rod-0310/Senior_Engineering_Design_Project/vision/runs/detect/predict/2025-11-10-225509_frame_3_jpg.rf.fb63ad9d6d32afbec5ac665ef9ed68c7.jpg

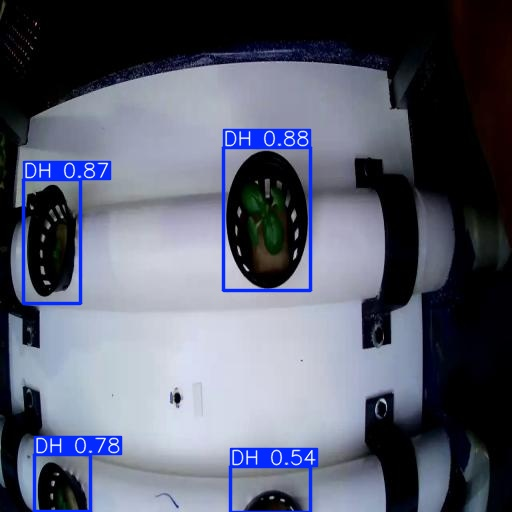
vision/runs/detect/predict/2025-11-10-225509_frame_3_jpg.rf.fb63ad9d6d32afbec5ac665ef9ed68c7.jpg
