rod-0310/Senior_Engineering_Design_Project/README.md

# Senior_Engineering_Design_Project
mian repository
