rod-0310/Senior_Engineering_Design_Project/body-gt2-idler-pulley-1.snapshot.2/Foto.png

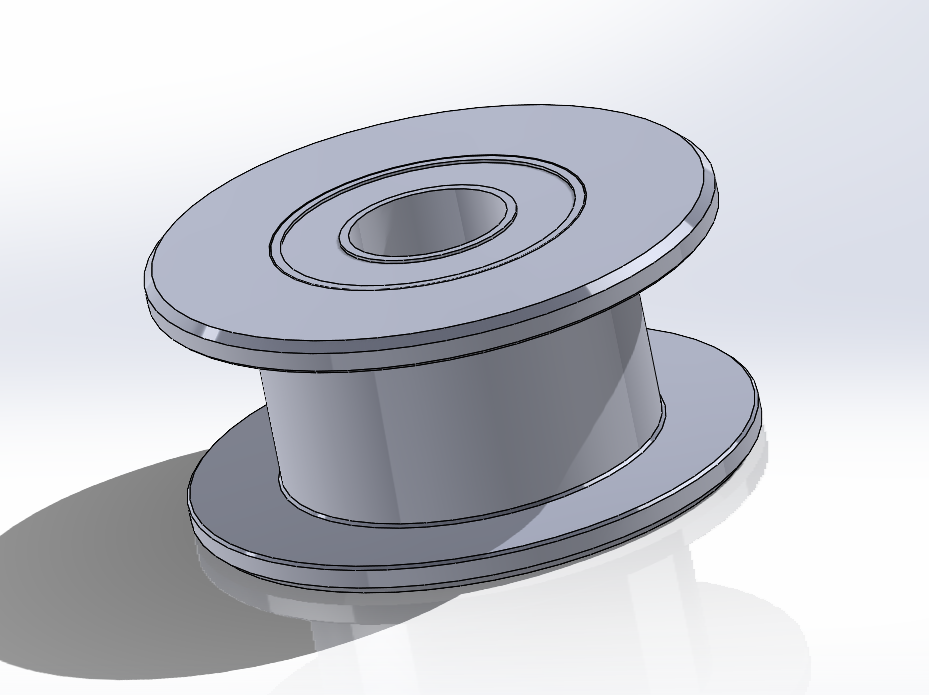
body-gt2-idler-pulley-1.snapshot.2/Foto.png
