rod-0310/Senior_Engineering_Design_Project/bomba-march-pump-1.snapshot.9/BOMBA DE LLENADORA.JPG

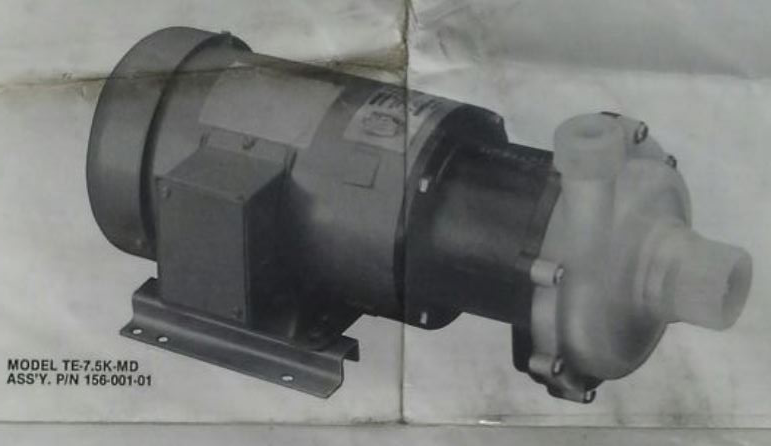
bomba-march-pump-1.snapshot.9/BOMBA DE LLENADORA.JPG
