rod-0310/Senior_Engineering_Design_Project/esp32-devkit_1-shield-expansion-board-1.snapshot.10/imagen_2025-06-20_145719014.png

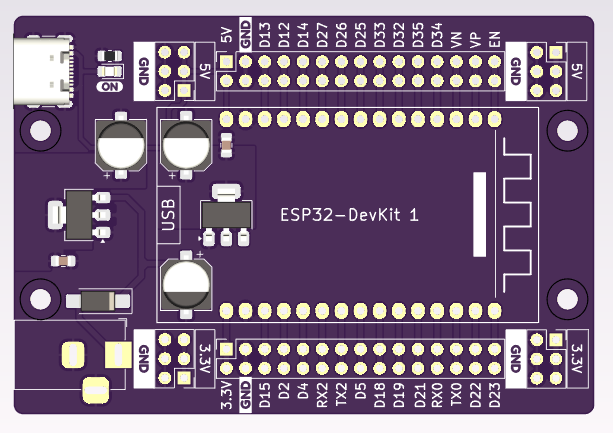
esp32-devkit_1-shield-expansion-board-1.snapshot.10/imagen_2025-06-20_145719014.png
