rod-0310/Senior_Engineering_Design_Project/fan-60x60-techman-1.snapshot.1/2.jpg

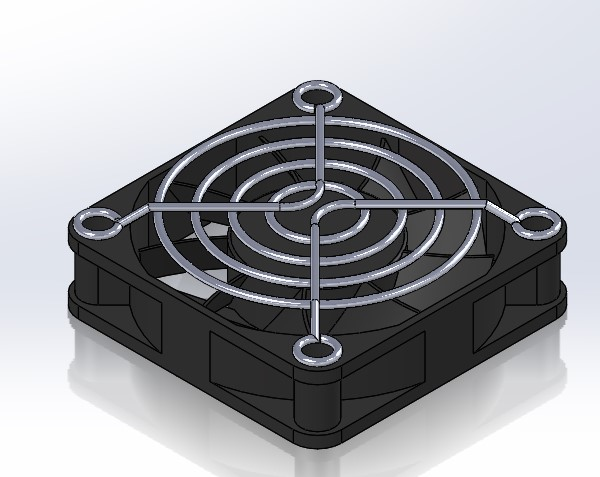
fan-60x60-techman-1.snapshot.1/2.jpg
