rod-0310/Senior_Engineering_Design_Project/fan-60x60-techman-1.snapshot.1/20181109_073611.png

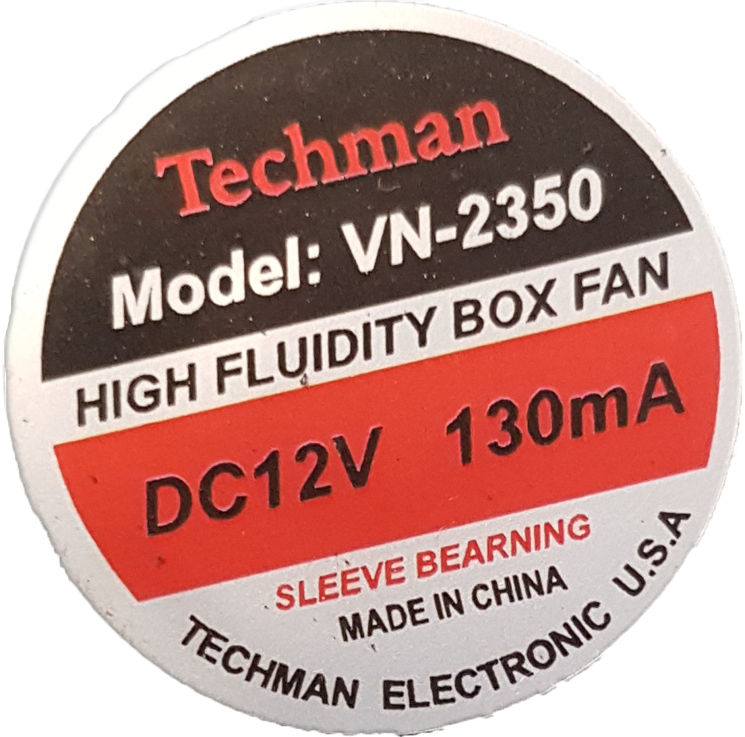
fan-60x60-techman-1.snapshot.1/20181109_073611.png
