rod-0310/Senior_Engineering_Design_Project/fuente-conmutada-24v-25a-48v-12-5a-y-24v-25a-1.snapshot.1/Fuente Conmutada 48V 12.5A img 1.PNG

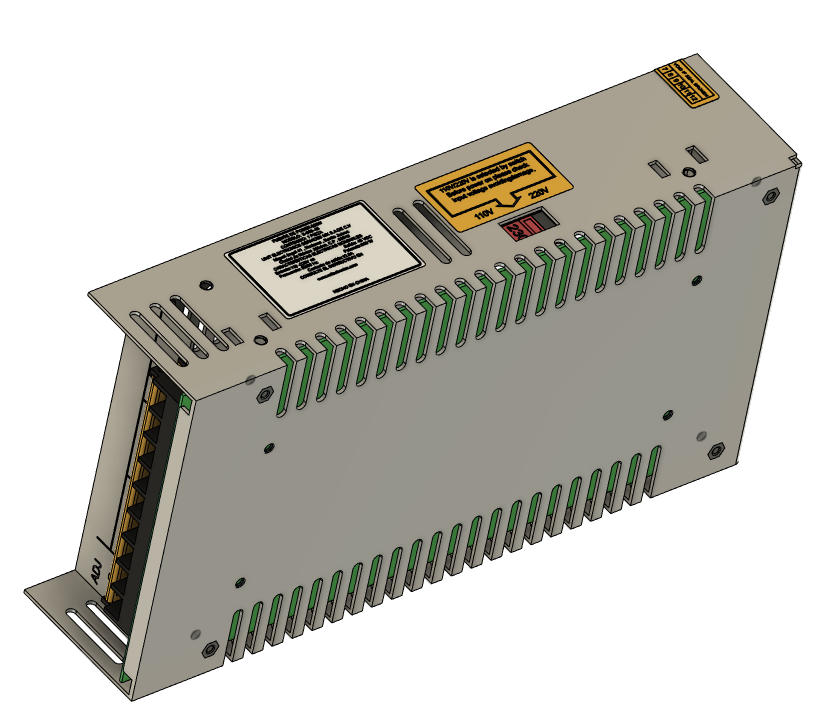
fuente-conmutada-24v-25a-48v-12-5a-y-24v-25a-1.snapshot.1/Fuente Conmutada 48V 12.5A img 1.PNG
