rod-0310/Senior_Engineering_Design_Project/Nema 17 42x40x5/Pic3.PNG

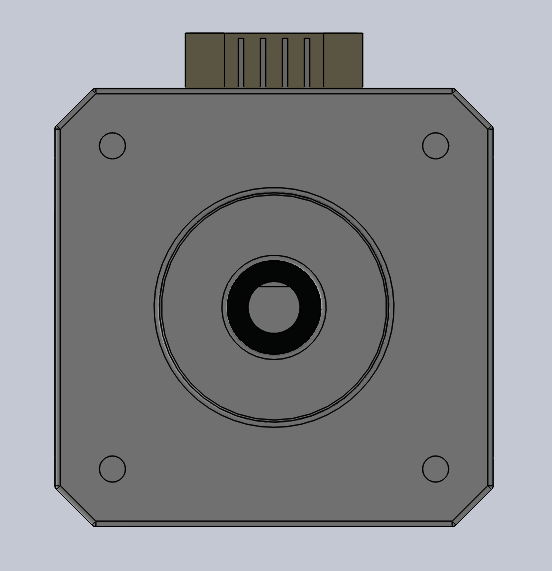
Nema 17 42x40x5/Pic3.PNG
