rod-0310/Senior_Engineering_Design_Project/plc-7.snapshot.1/PLCFinal2.png

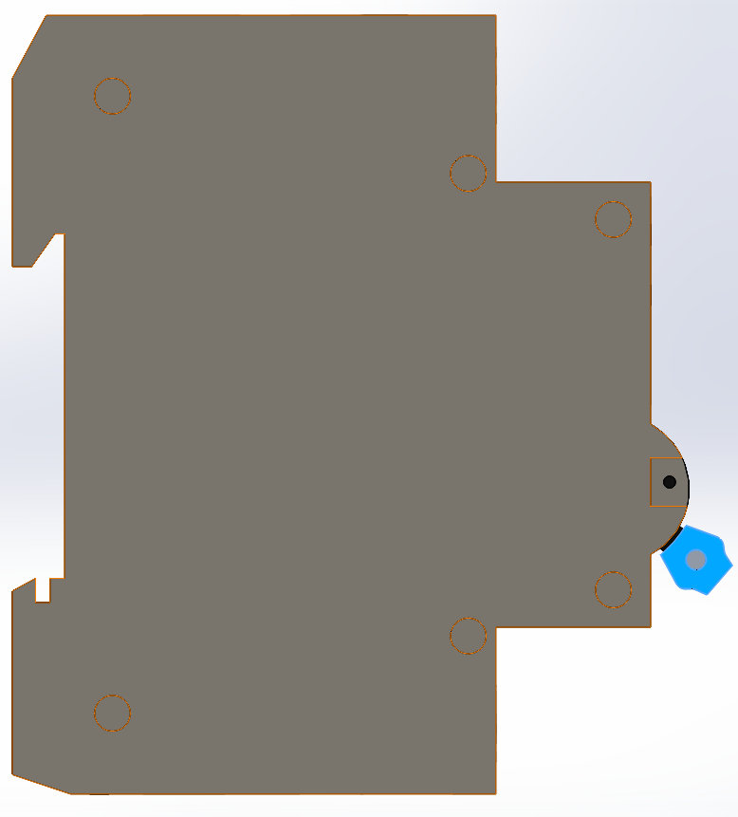
plc-7.snapshot.1/PLCFinal2.png
