rod-0310/Senior_Engineering_Design_Project/pulley-gt2-20-tooth-5-bore-gt2-1.snapshot.1/Снимок экрана 2023-11-01 161619.png

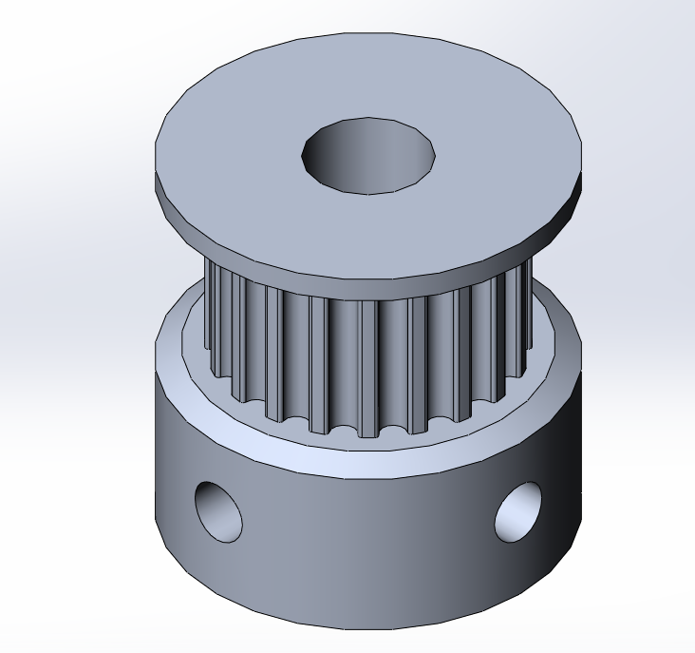
pulley-gt2-20-tooth-5-bore-gt2-1.snapshot.1/Снимок экрана 2023-11-01 161619.png
