rod-0310/Senior_Engineering_Design_Project/rodamientos-lineales-linear-bearings-1.snapshot.2/rodamientos lineales.JPG

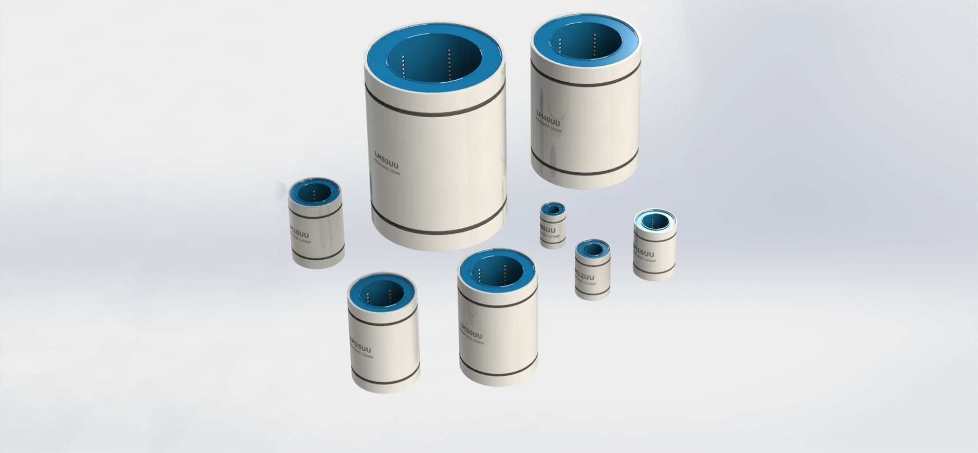
rodamientos-lineales-linear-bearings-1.snapshot.2/rodamientos lineales.JPG
