rod-0310/Senior_Engineering_Design_Project/tb6600-driver-1.snapshot.1/TB6600-3.PNG

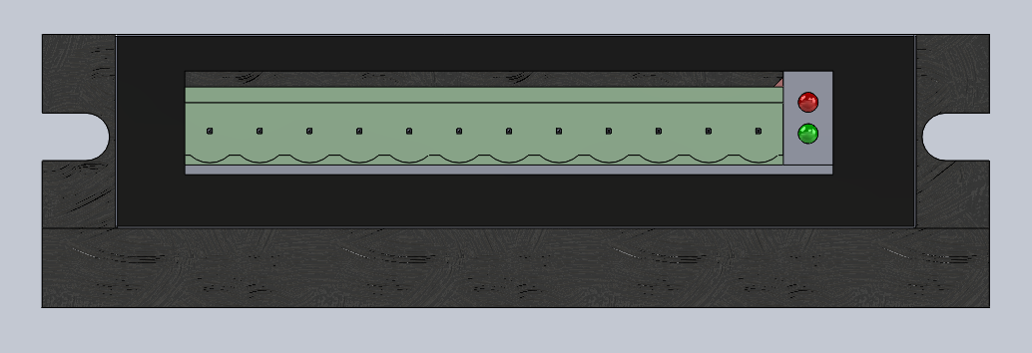
tb6600-driver-1.snapshot.1/TB6600-3.PNG
