rod-0310/Senior_Engineering_Design_Project/valvula-de-bola-de-1-in-de-pvc-1.snapshot.3/Untitled.JPG

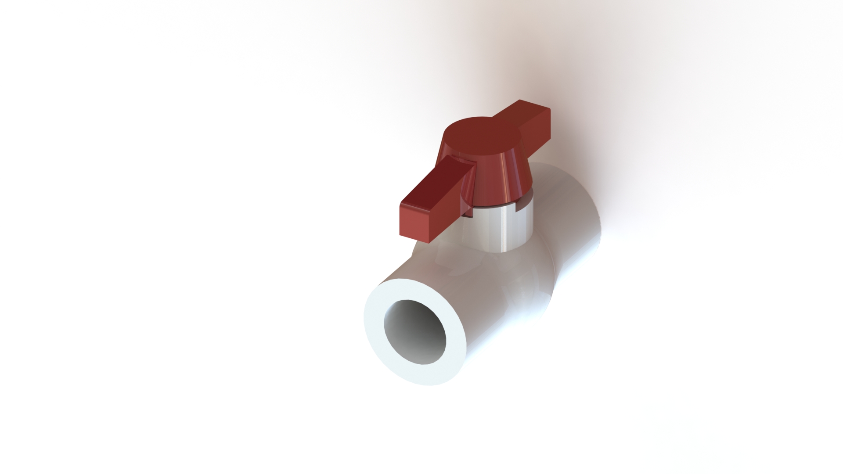
valvula-de-bola-de-1-in-de-pvc-1.snapshot.3/Untitled.JPG
