rod-0310/Senior_Engineering_Design_Project/vision/runs/detect/predict/2025-11-10-223832_frame_15_jpg.rf.22a14f25574e3a6e1a47245aced490ff.jpg

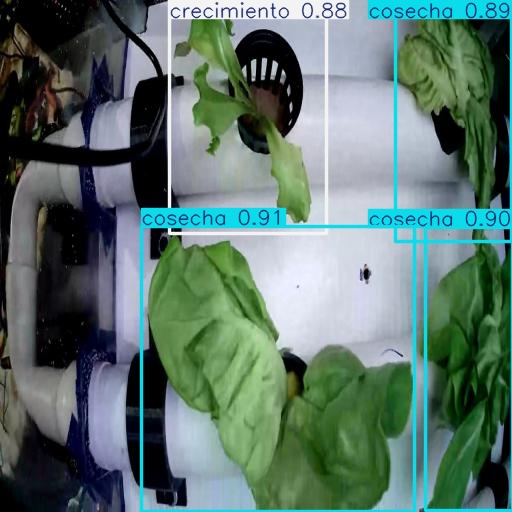
vision/runs/detect/predict/2025-11-10-223832_frame_15_jpg.rf.22a14f25574e3a6e1a47245aced490ff.jpg
