rod-0310/Senior_Engineering_Design_Project/vision/runs/detect/predict/2025-11-10-223832_frame_16_jpg.rf.2f97a4026e4792bca8e62f9cea386afc.jpg

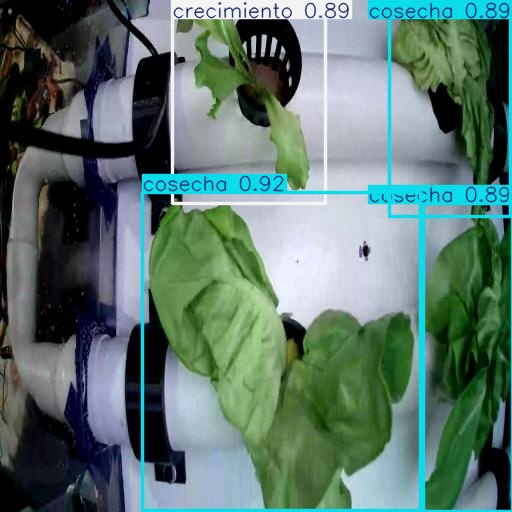
vision/runs/detect/predict/2025-11-10-223832_frame_16_jpg.rf.2f97a4026e4792bca8e62f9cea386afc.jpg
