rod-0310/Senior_Engineering_Design_Project/vision/runs/detect/predict/2025-11-10-223936_frame_9_jpg.rf.916dadcf2fc539604772f068412f9f6e.jpg

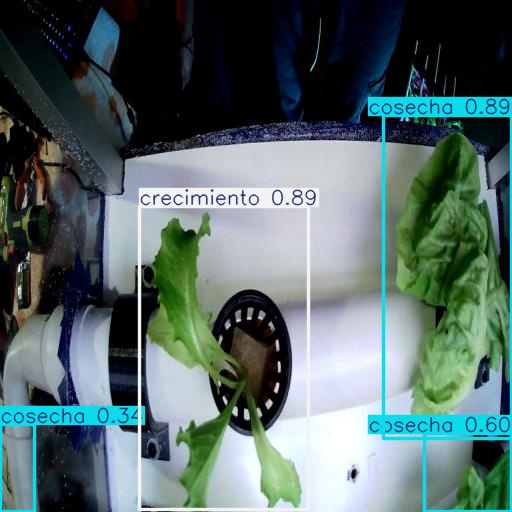
vision/runs/detect/predict/2025-11-10-223936_frame_9_jpg.rf.916dadcf2fc539604772f068412f9f6e.jpg
