rod-0310/Senior_Engineering_Design_Project/vision/runs/detect/predict/2025-11-10-223936_frame_16_jpg.rf.3a708838be61265636ba27722d4fdc08.jpg

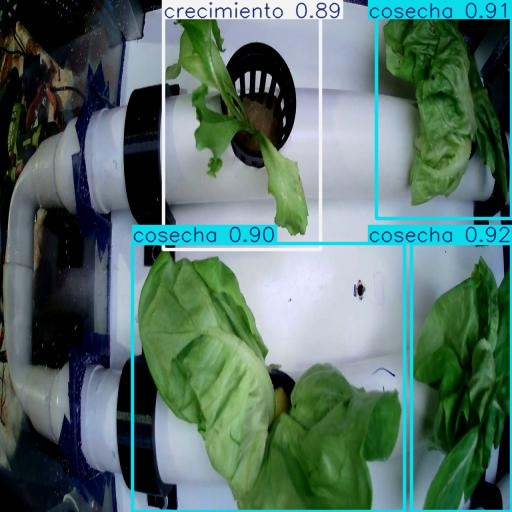
vision/runs/detect/predict/2025-11-10-223936_frame_16_jpg.rf.3a708838be61265636ba27722d4fdc08.jpg
