rod-0310/Senior_Engineering_Design_Project/vision/runs/detect/predict/2025-11-10-224214_frame_26_jpg.rf.f7065c991a5802a6a953b0d0d70c4c16.jpg

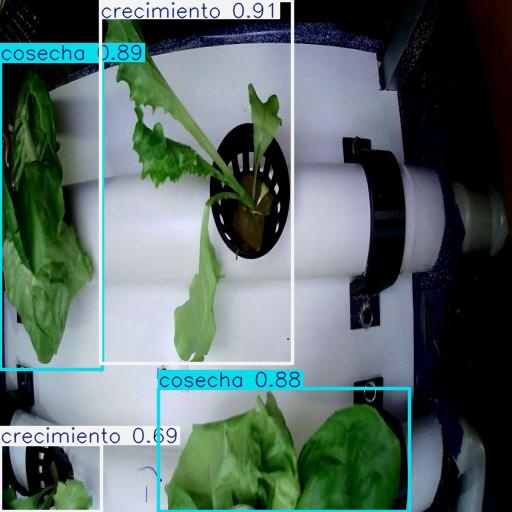
vision/runs/detect/predict/2025-11-10-224214_frame_26_jpg.rf.f7065c991a5802a6a953b0d0d70c4c16.jpg
