rod-0310/Senior_Engineering_Design_Project/vision/runs/detect/predict/2025-11-10-224326_frame_7_jpg.rf.50a9398aa1a29edf5bf6550289bb4c49.jpg

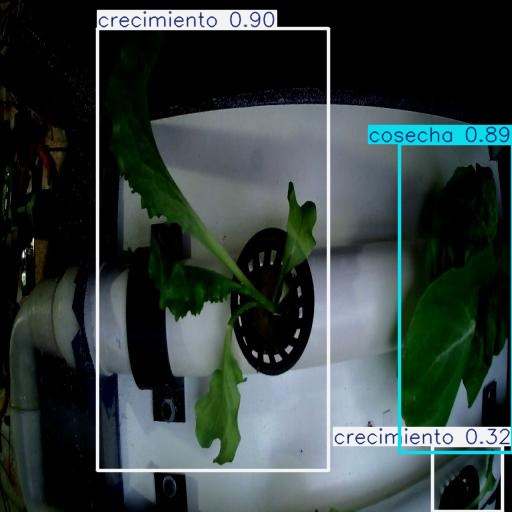
vision/runs/detect/predict/2025-11-10-224326_frame_7_jpg.rf.50a9398aa1a29edf5bf6550289bb4c49.jpg
