rod-0310/Senior_Engineering_Design_Project/vision/runs/detect/predict/2025-11-10-224425_frame_20_jpg.rf.f0c4a33722093ec0f9ddbb4c10bcf8e6.jpg

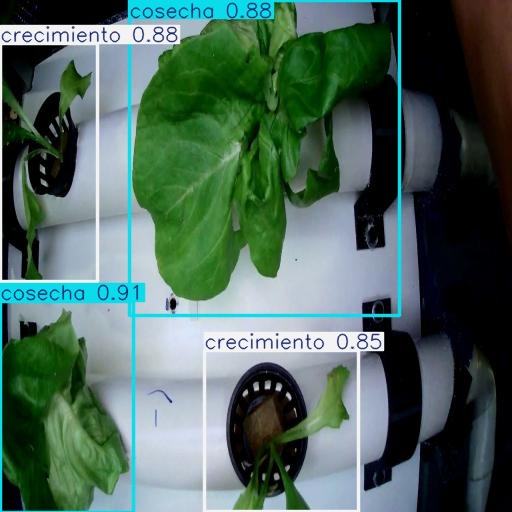
vision/runs/detect/predict/2025-11-10-224425_frame_20_jpg.rf.f0c4a33722093ec0f9ddbb4c10bcf8e6.jpg
