rod-0310/Senior_Engineering_Design_Project/vision/runs/detect/predict/2025-11-10-224652_frame_2_jpg.rf.96d3c39d6f43bb69b98d42bbe74c6def.jpg

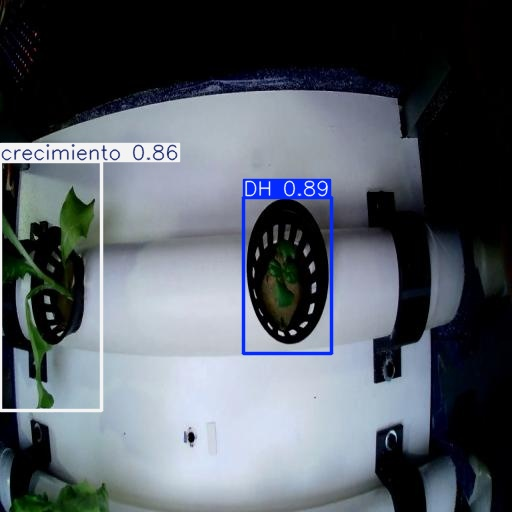
vision/runs/detect/predict/2025-11-10-224652_frame_2_jpg.rf.96d3c39d6f43bb69b98d42bbe74c6def.jpg
