rod-0310/Senior_Engineering_Design_Project/vision/runs/detect/predict/2025-11-10-224652_frame_13_jpg.rf.508b9bf271020223bf58ecf0794aba57.jpg

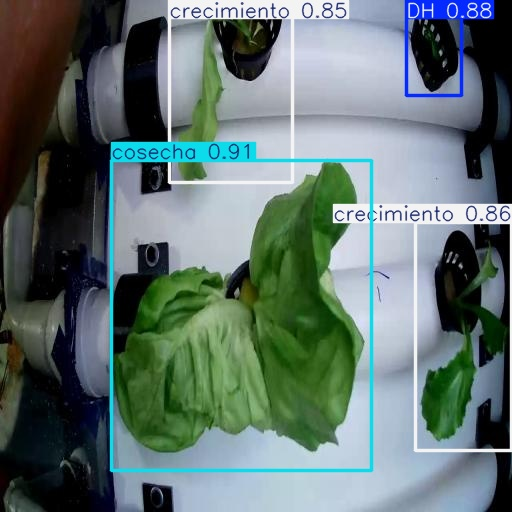
vision/runs/detect/predict/2025-11-10-224652_frame_13_jpg.rf.508b9bf271020223bf58ecf0794aba57.jpg
