rod-0310/Senior_Engineering_Design_Project/vision/runs/detect/train2/F1_curve.png

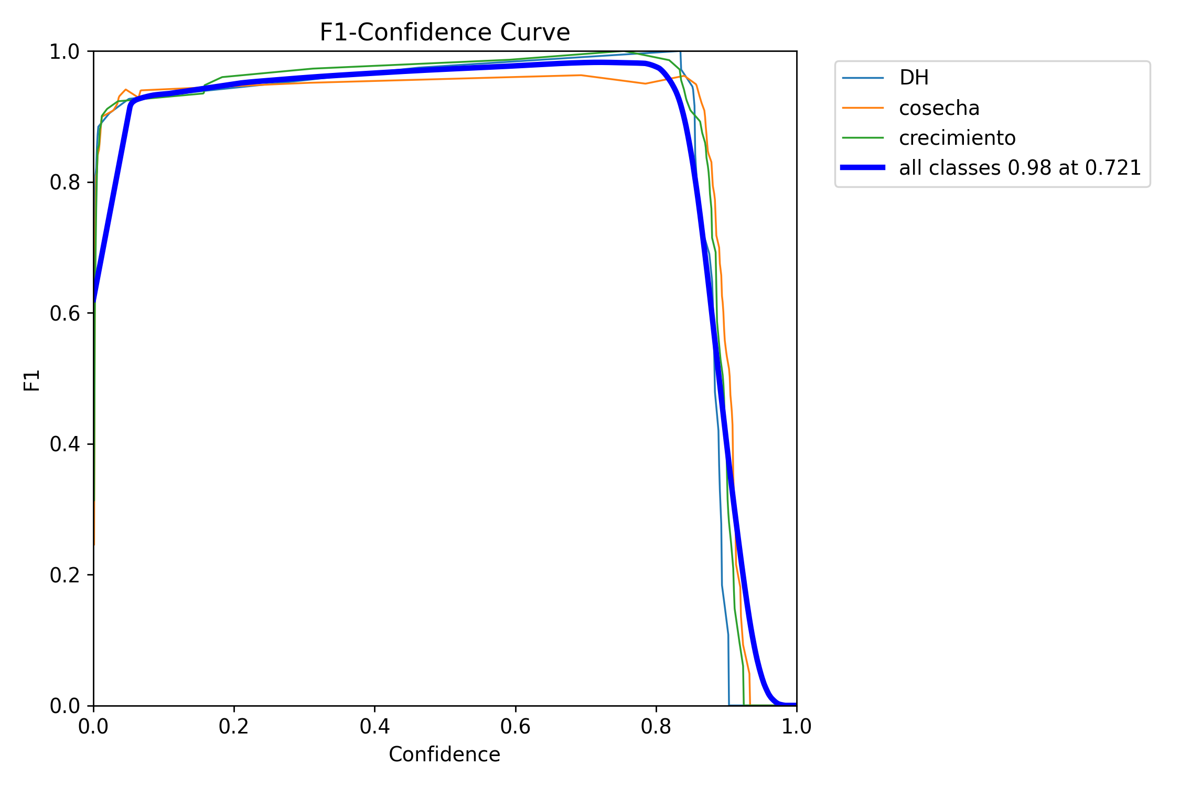
vision/runs/detect/train2/F1_curve.png
