rod-0310/Senior_Engineering_Design_Project/vision/runs/detect/train2/labels.jpg

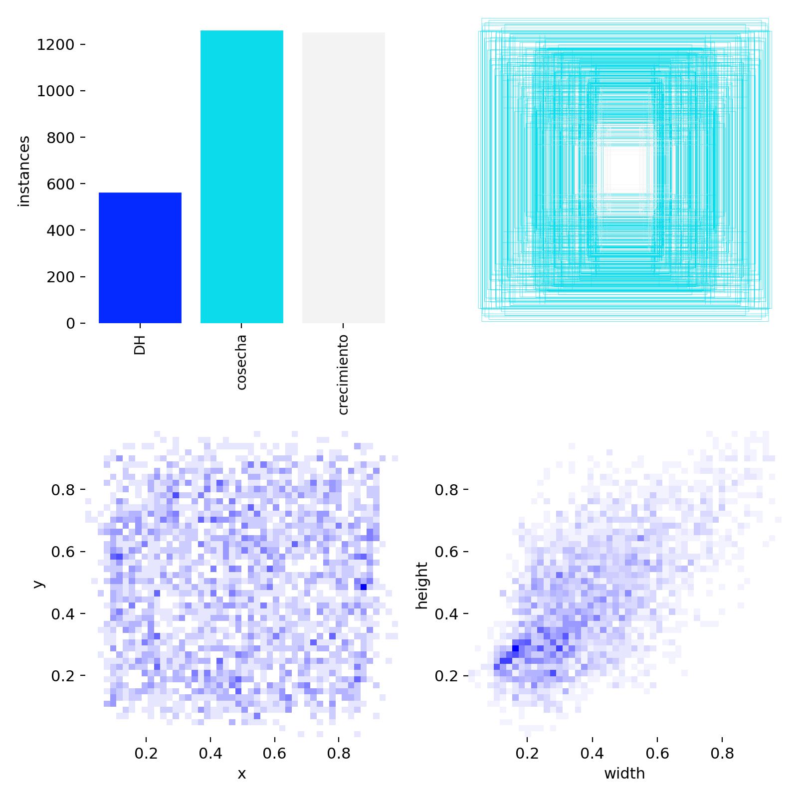
vision/runs/detect/train2/labels.jpg
