rod-0310/Senior_Engineering_Design_Project/vision/runs/detect/train2/train_batch0.jpg

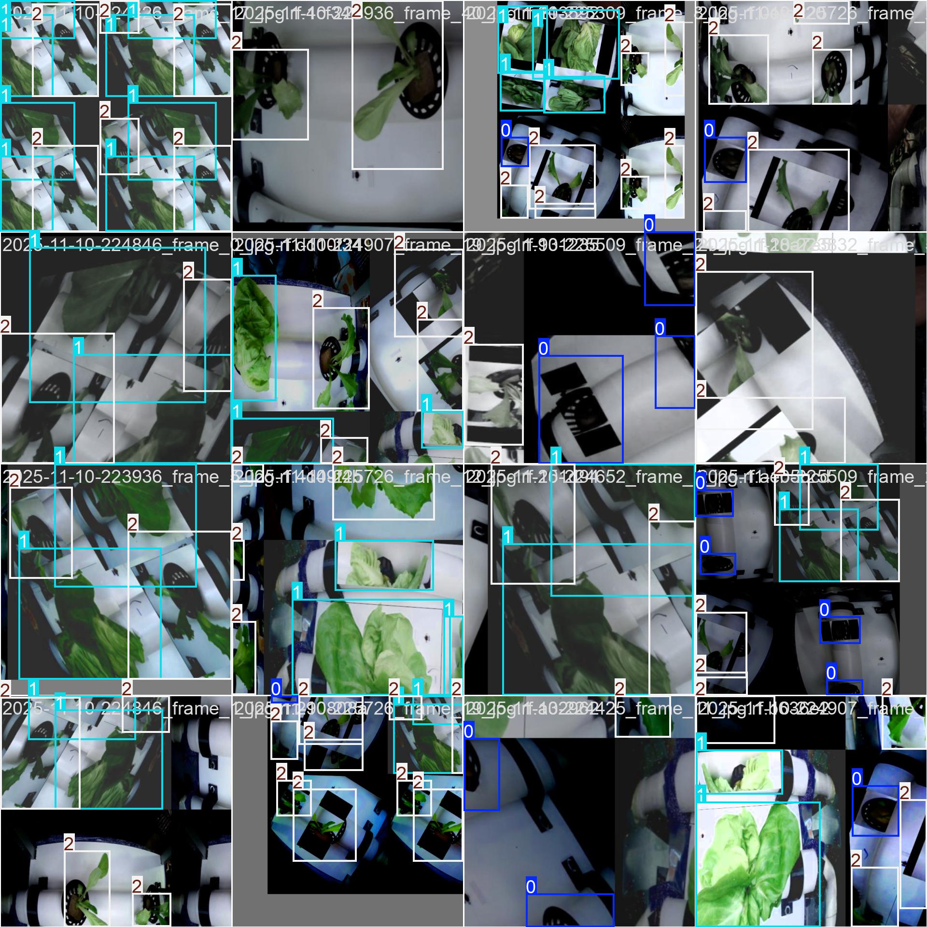
vision/runs/detect/train2/train_batch0.jpg
