rod-0310/Senior_Engineering_Design_Project/vision/runs/detect/train3/train_batch2.jpg

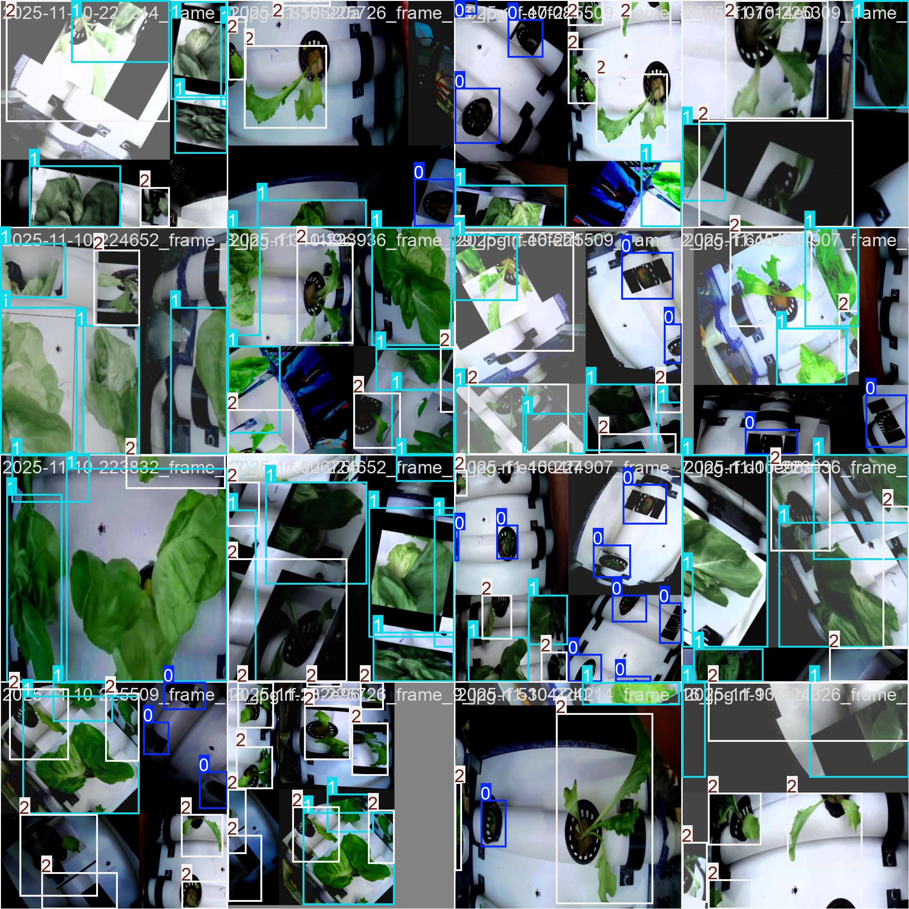
vision/runs/detect/train3/train_batch2.jpg
