rod-0310/Senior_Engineering_Design_Project/vision/runs/detect/train5/labels_correlogram.jpg

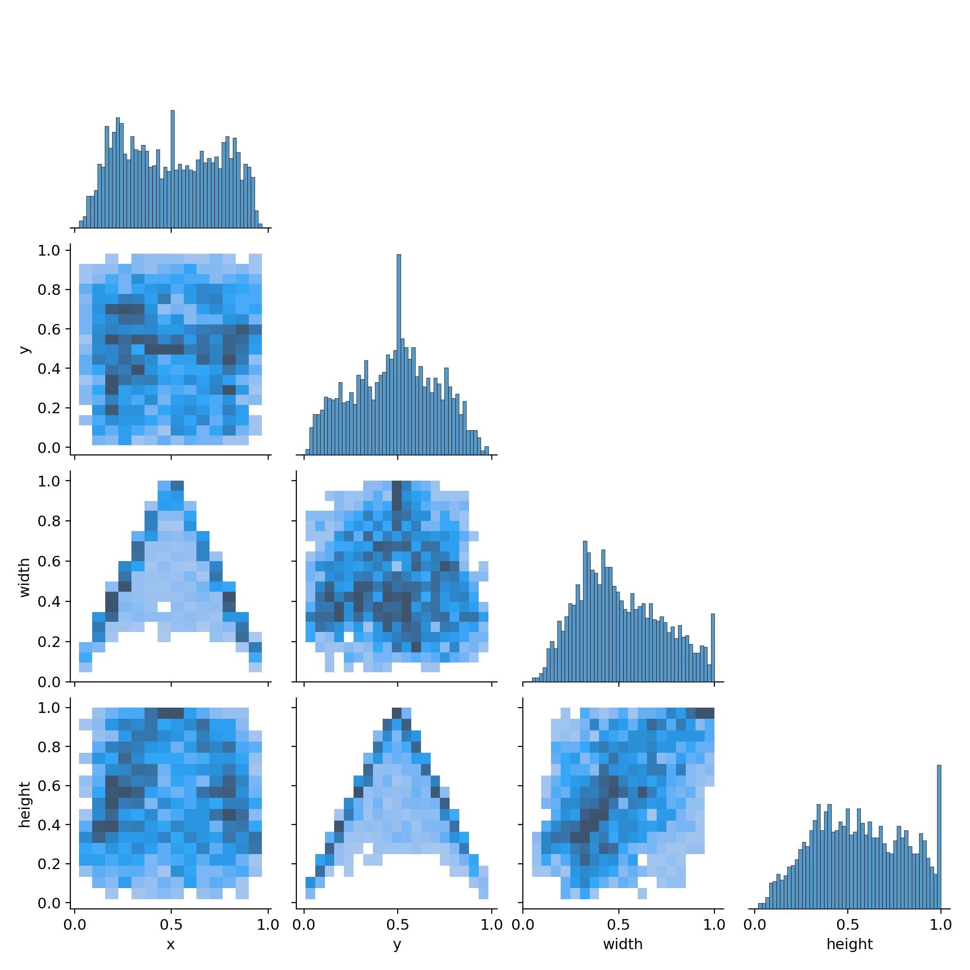
vision/runs/detect/train5/labels_correlogram.jpg
