rod-0310/Senior_Engineering_Design_Project/vision/runs/detect/train6/train_batch5851.jpg

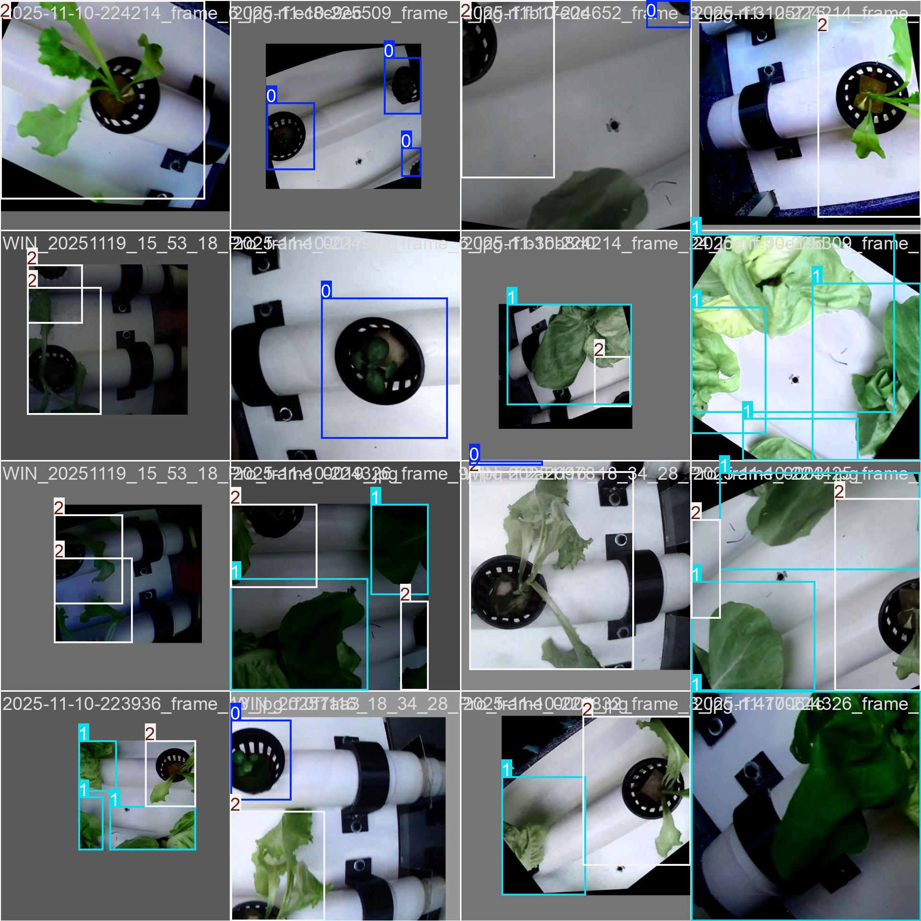
vision/runs/detect/train6/train_batch5851.jpg
