rod-0310/Senior_Engineering_Design_Project/vision/runs/detect/train6/val_batch1_labels.jpg

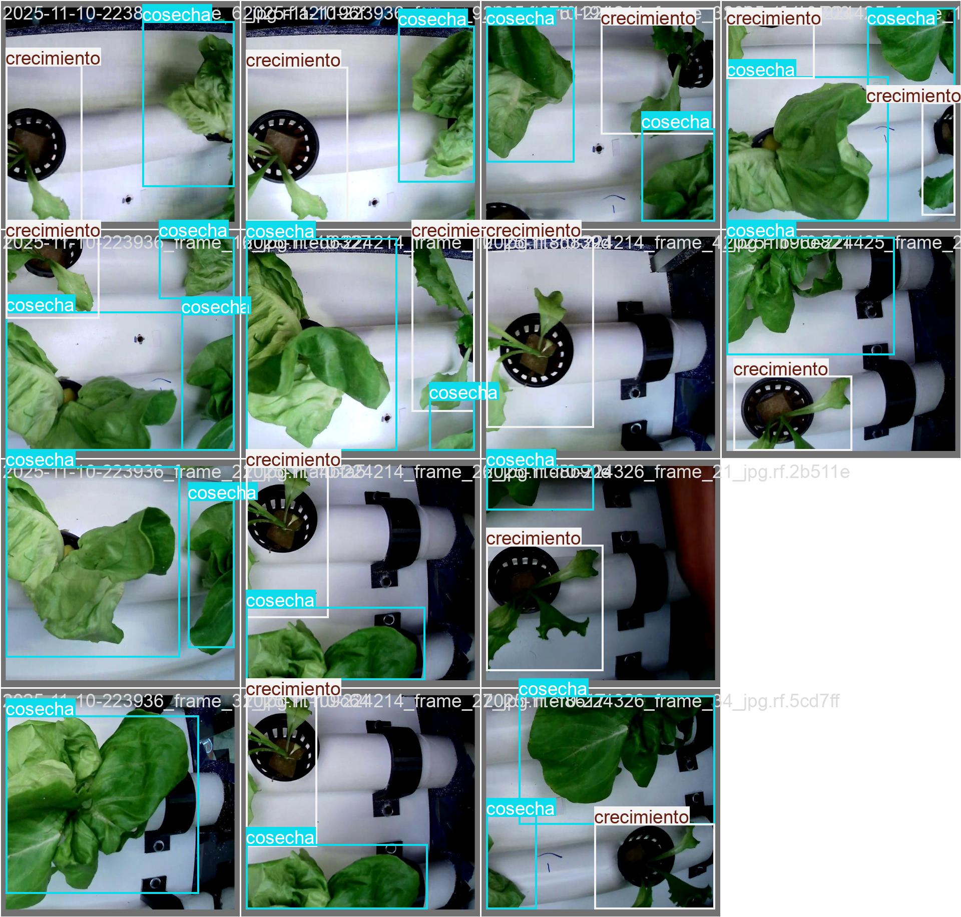
vision/runs/detect/train6/val_batch1_labels.jpg
