rod-0310/Senior_Engineering_Design_Project/plc-7.snapshot.1/PLCFinal.SLDASM

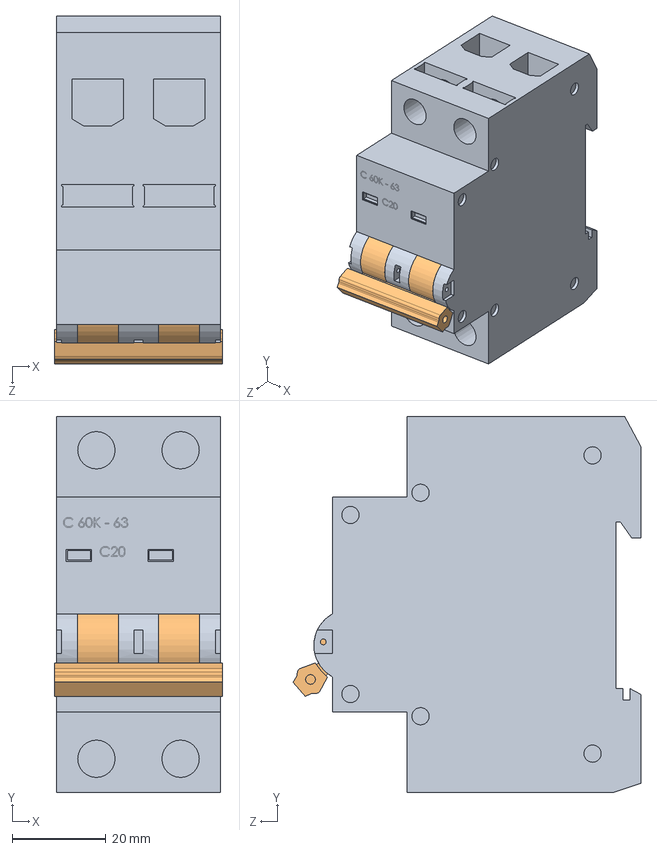
[picture p72: CAD file, 2025-10-19]
plc-7.snapshot.1/PLCFinal.SLDASM
36.0 x 80.5 x 74.4 mm
PLC
PLCPieza2
