rod-0310/Senior_Engineering_Design_Project/valvula-de-bola-de-1-in-de-pvc-1.snapshot.3/válvula de bola.SLDASM

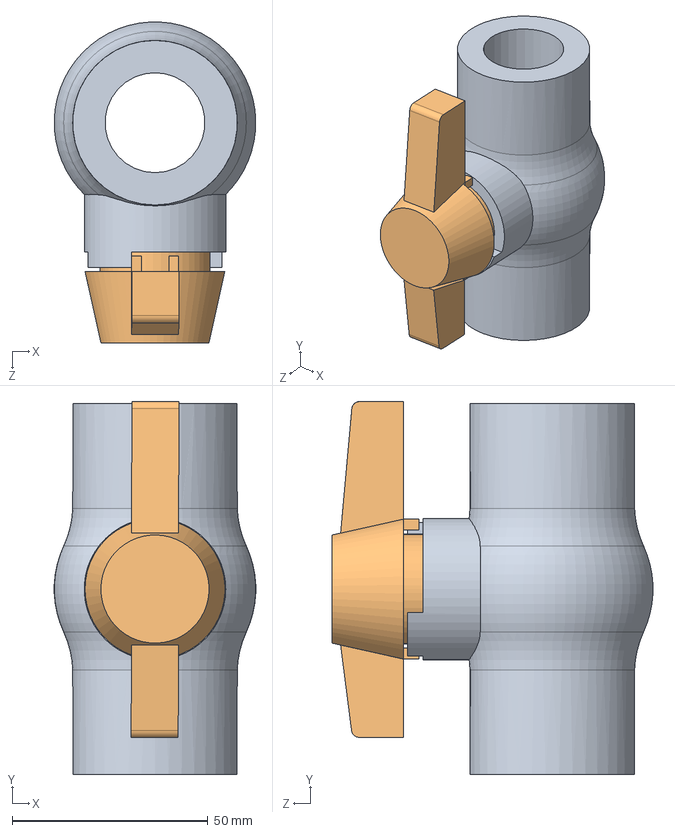
[picture p73: CAD file, 2025-10-17]
valvula-de-bola-de-1-in-de-pvc-1.snapshot.3/válvula de bola.SLDASM
51.4 x 95.2 x 81.9 mm
cuerpo valvula
mariposa
