rod-0310/Senior_Engineering_Design_Project/ensamblaje_v1.SLDASM

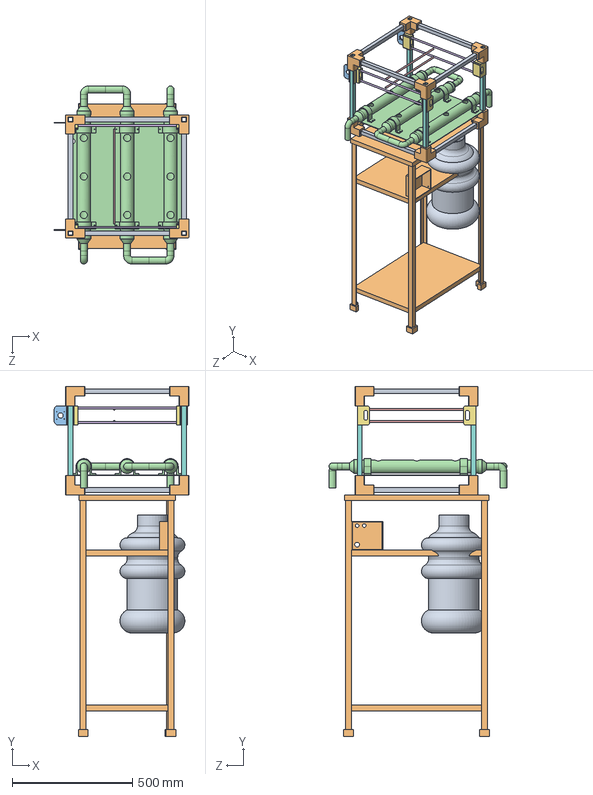
[picture p74: CAD file, 2025-10-16]
ensamblaje_v1.SLDASM
559.0 x 1454.0 x 739.4 mm
esquinero x 8
perfil_x_y x 8
perfil_z x 4
esquinero_varillas x 4
varilla_eje_y x 4
varilla_eje_x x 2
base_trupan
soporte_motor x 2
mesa_v2
botellon
