rod-0310/Senior_Engineering_Design_Project/acrilico_top.SLDPRT

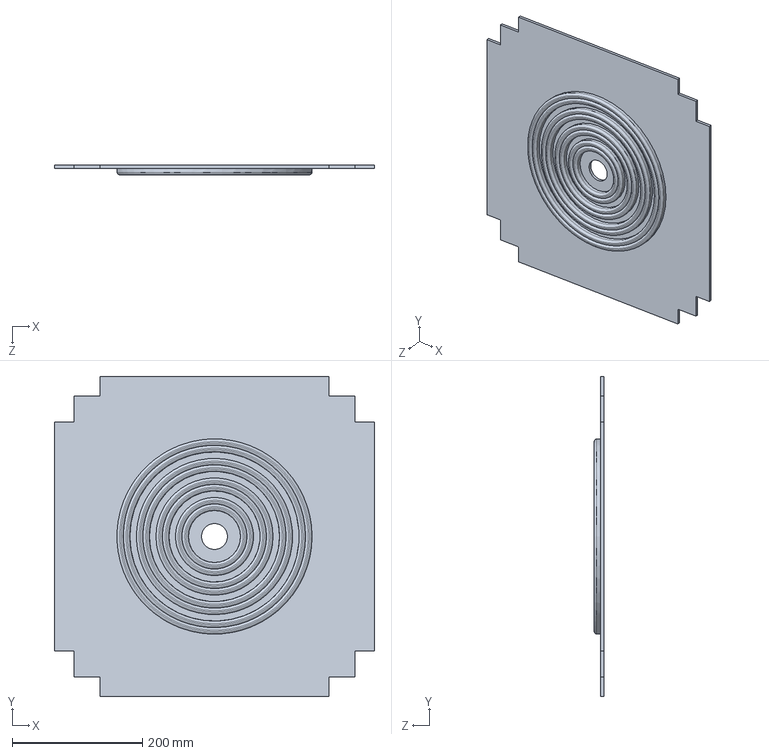
[picture p75: CAD file, 2025-11-08]
acrilico_top.SLDPRT
492.0 x 492.0 x 15.0 mm
