rod-0310/Senior_Engineering_Design_Project/body-gt2-idler-pulley-1.snapshot.2/GT2 sin dientes.SLDPRT

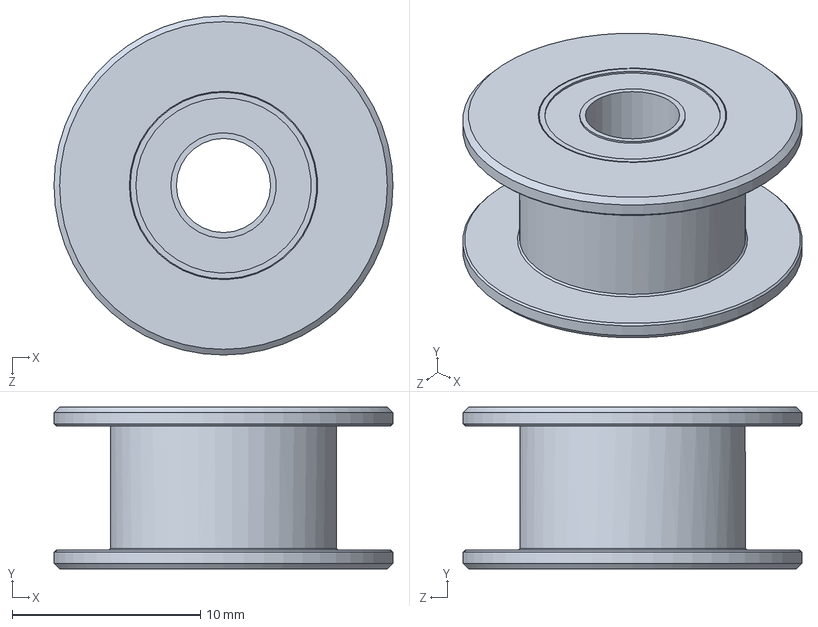
[picture p76: CAD file, 2025-10-17]
body-gt2-idler-pulley-1.snapshot.2/GT2 sin dientes.SLDPRT
18.0 x 8.60 x 18.0 mm
