rod-0310/Senior_Engineering_Design_Project/bomba-march-pump-1.snapshot.9/BOMBA MARCH ENVASADO.STEP

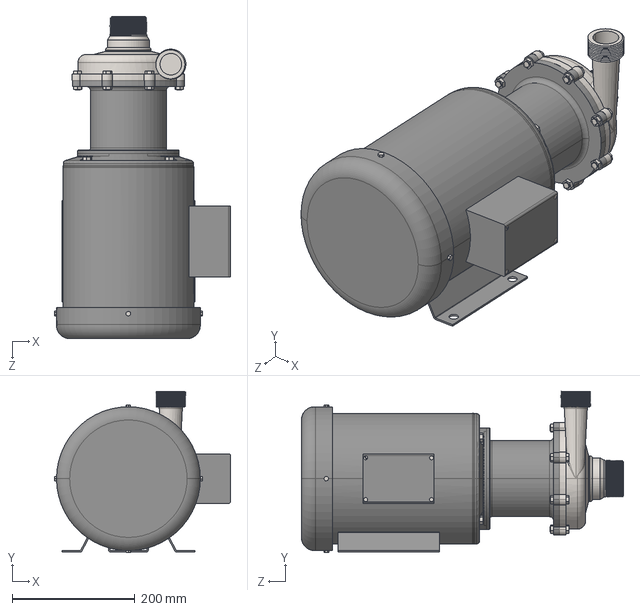
[picture p77: CAD file, 2025-10-15]
bomba-march-pump-1.snapshot.9/BOMBA MARCH ENVASADO.STEP
286.3 x 262.2 x 524.2 mm
