rod-0310/Senior_Engineering_Design_Project/coudes-pvc-1.snapshot.2/codo.SLDPRT

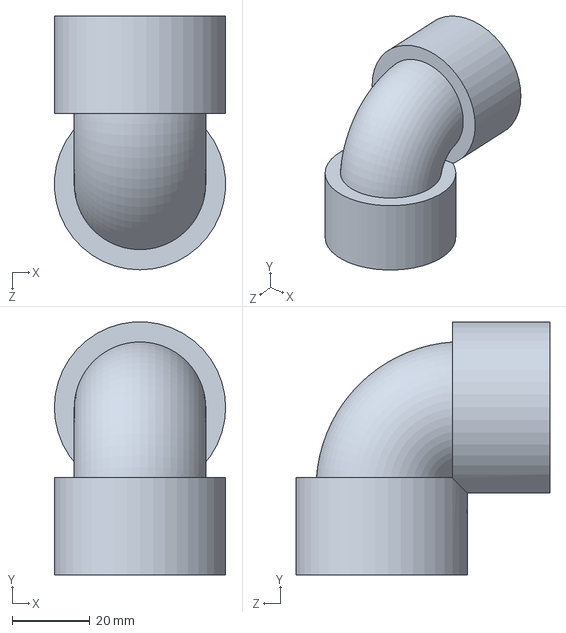
[picture p78: CAD file, 2025-10-15]
coudes-pvc-1.snapshot.2/codo.SLDPRT
44.0 x 65.0 x 65.1 mm
