rod-0310/Senior_Engineering_Design_Project/fan-60x60-techman-1.snapshot.1/ventilador 60x60.STEP

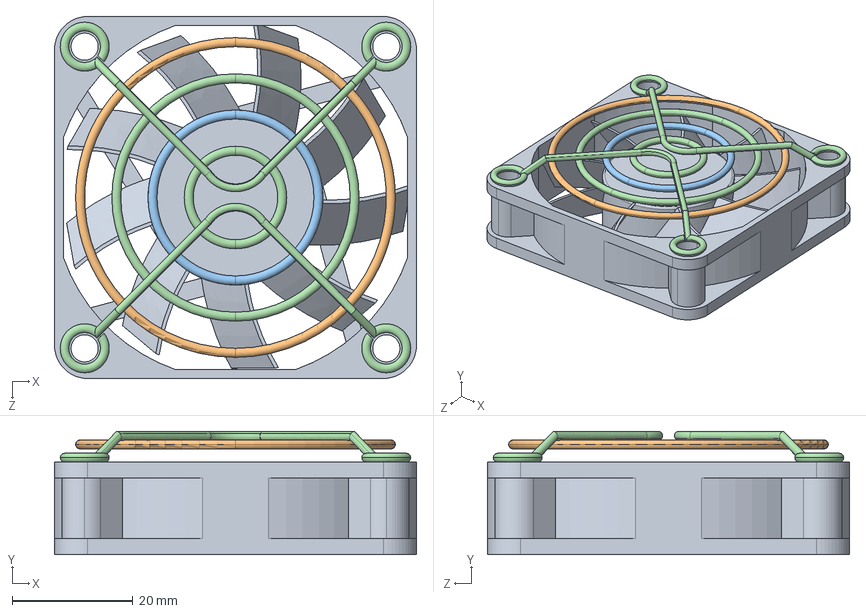
[picture p79: CAD file, 2025-10-17]
fan-60x60-techman-1.snapshot.1/ventilador 60x60.STEP
60.0 x 20.4 x 60.0 mm
