rod-0310/Senior_Engineering_Design_Project/Nema 17 42x40x5/Nima 17 40x42x5mm.STEP

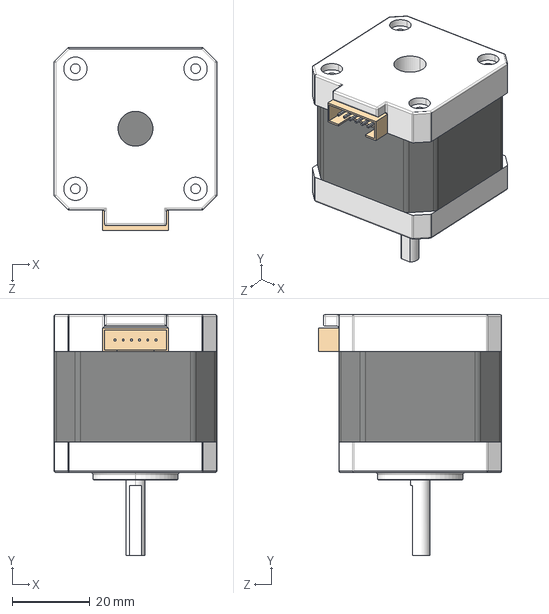
[picture p80: CAD file, 2025-10-14]
Nema 17 42x40x5/Nima 17 40x42x5mm.STEP
42.0 x 62.1 x 47.3 mm
