rod-0310/Senior_Engineering_Design_Project/plc-7.snapshot.1/PLC.SLDPRT

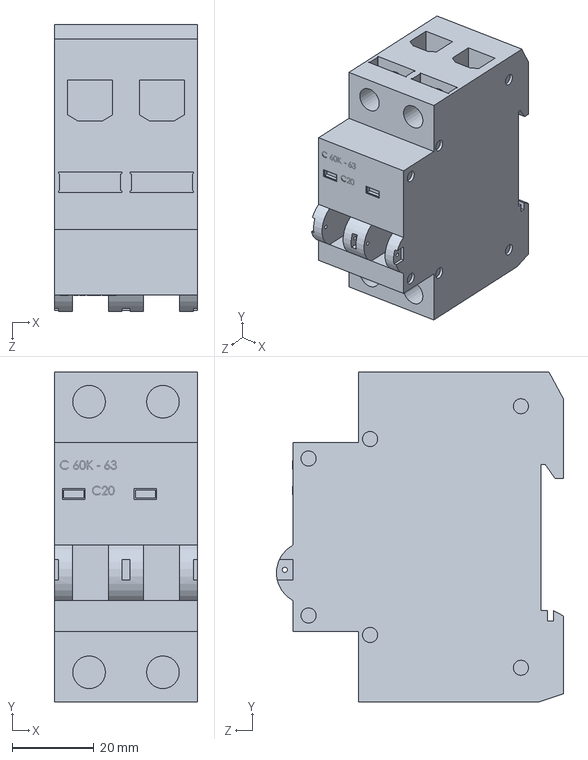
[picture p81: CAD file, 2025-10-19]
plc-7.snapshot.1/PLC.SLDPRT
35.0 x 80.5 x 69.9 mm
