rod-0310/Senior_Engineering_Design_Project/pulley-gt2-20-tooth-5-bore-gt2-1.snapshot.1/Шкив GT2 20T b5.STEP

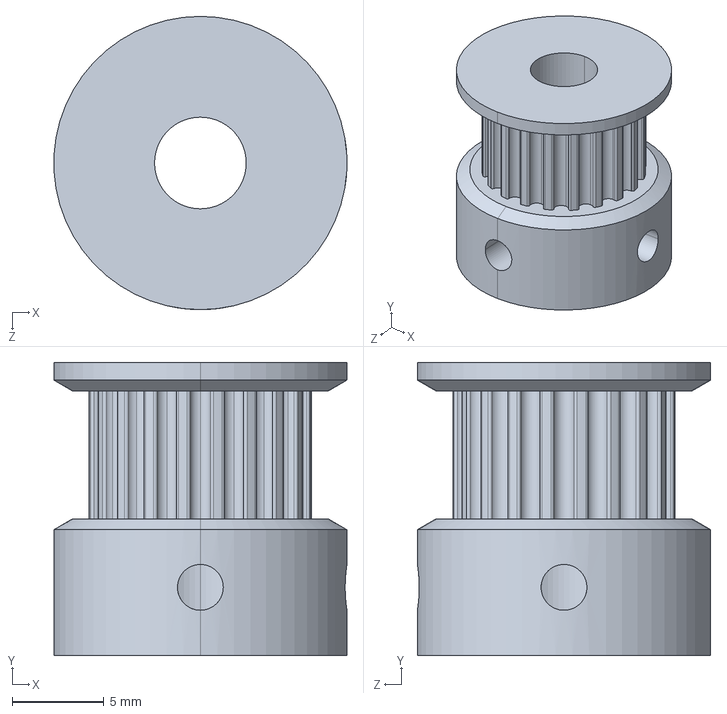
[picture p82: CAD file, 2025-10-17]
pulley-gt2-20-tooth-5-bore-gt2-1.snapshot.1/Шкив GT2 20T b5.STEP
16.0 x 16.0 x 16.0 mm
