rod-0310/Senior_Engineering_Design_Project/rodamientos-lineales-linear-bearings-1.snapshot.2/Rodamientos lineales/LM30UU.STEP

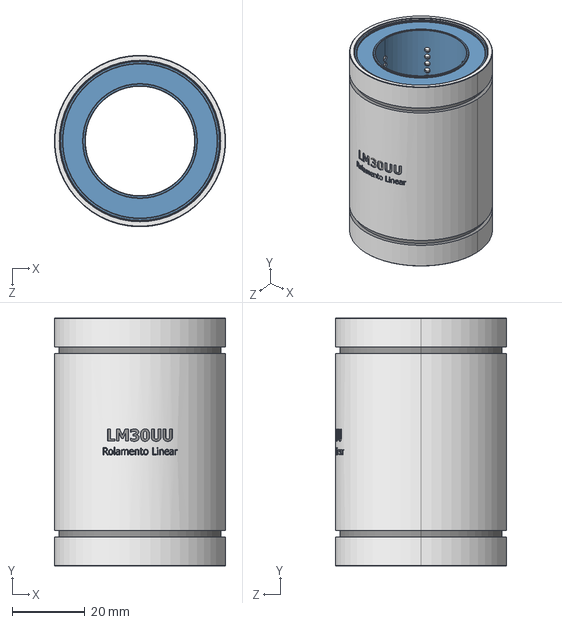
[picture p83: CAD file, 2025-10-17]
rodamientos-lineales-linear-bearings-1.snapshot.2/Rodamientos lineales/LM30UU.STEP
47.0 x 68.0 x 47.0 mm
