rod-0310/Senior_Engineering_Design_Project/tb6600-driver-1.snapshot.1/TB-6600.STEP

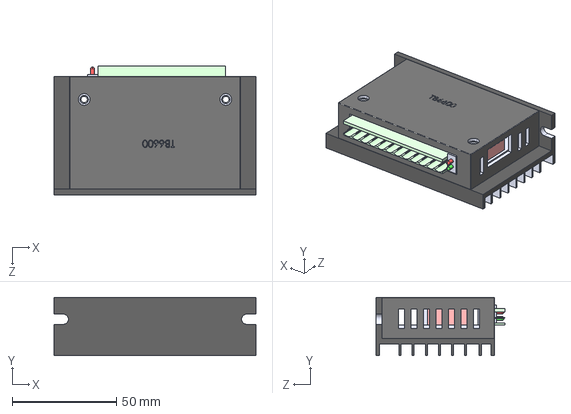
[picture p84: CAD file, 2025-10-14]
tb6600-driver-1.snapshot.1/TB-6600.STEP
97.0 x 28.0 x 62.0 mm
