rod-0310/Senior_Engineering_Design_Project/valvula-de-bola-de-1-in-de-pvc-1.snapshot.3/cuerpo valvula.SLDPRT

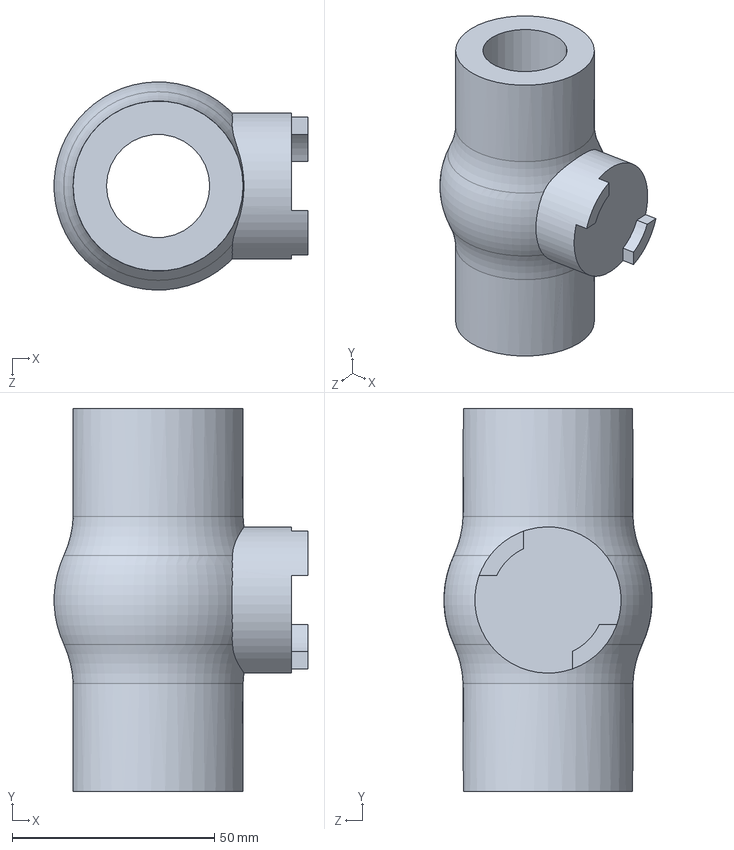
[picture p85: CAD file, 2025-10-17]
valvula-de-bola-de-1-in-de-pvc-1.snapshot.3/cuerpo valvula.SLDPRT
62.7 x 94.6 x 51.4 mm
