rod-0310/Senior_Engineering_Design_Project/coudes-pvc-1.snapshot.2/coude50.SLDPRT

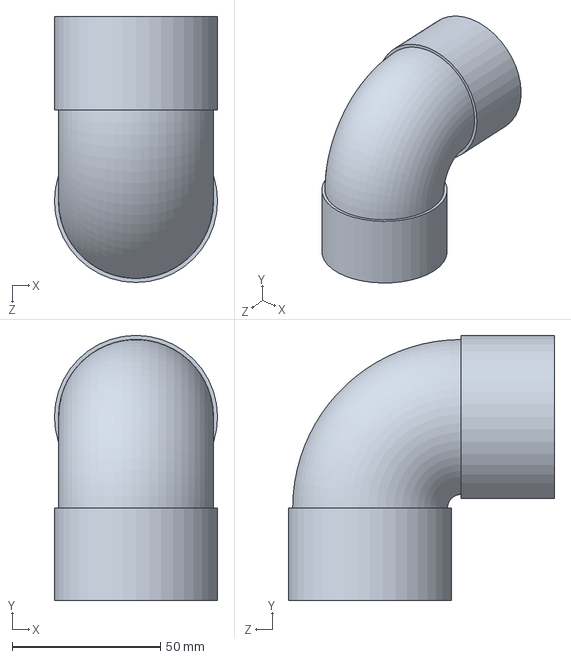
[picture p86: CAD file, 2025-10-15]
coudes-pvc-1.snapshot.2/coude50.SLDPRT
55.0 x 89.4 x 89.7 mm
