rod-0310/Senior_Engineering_Design_Project/rodamientos-lineales-linear-bearings-1.snapshot.2/Rodamientos lineales/LM40UU.STEP

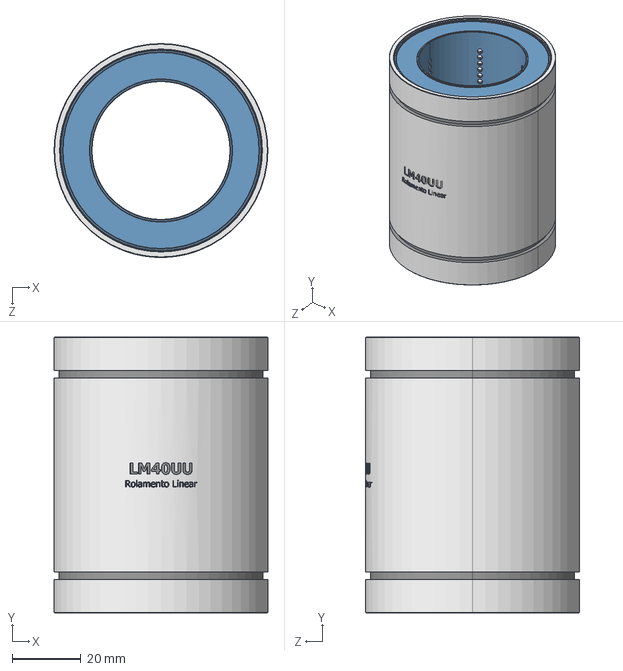
[picture p87: CAD file, 2025-10-17]
rodamientos-lineales-linear-bearings-1.snapshot.2/Rodamientos lineales/LM40UU.STEP
62.0 x 80.0 x 62.0 mm
