rod-0310/Senior_Engineering_Design_Project/tapa_tubo.SLDPRT

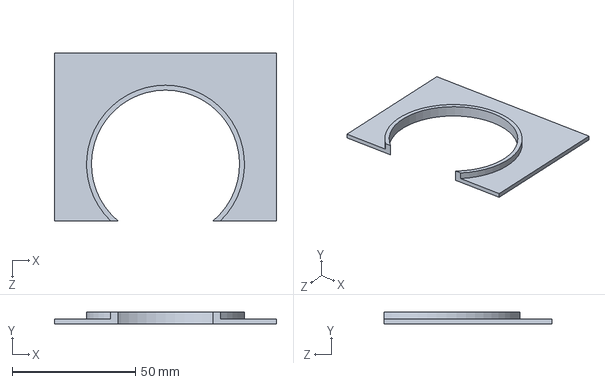
[picture p88: CAD file, 2025-11-08]
tapa_tubo.SLDPRT
90.0 x 5.00 x 68.0 mm
