rod-0310/Senior_Engineering_Design_Project/valvula-de-bola-de-1-in-de-pvc-1.snapshot.3/mariposa.SLDPRT

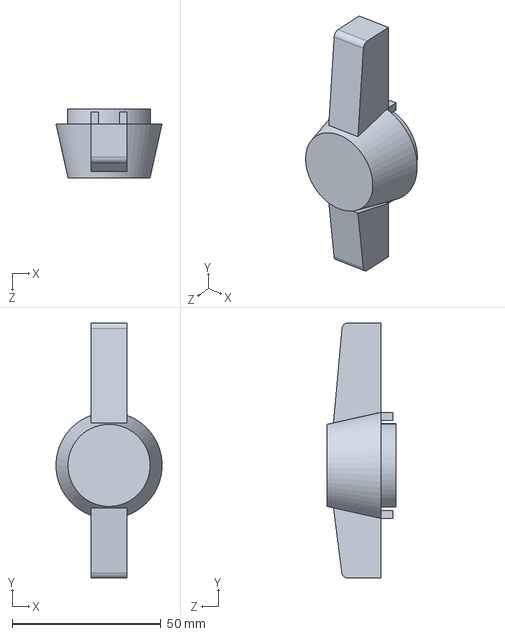
[picture p89: CAD file, 2025-10-17]
valvula-de-bola-de-1-in-de-pvc-1.snapshot.3/mariposa.SLDPRT
35.7 x 85.7 x 23.2 mm
