rod-0310/Senior_Engineering_Design_Project/aspersor.SLDPRT

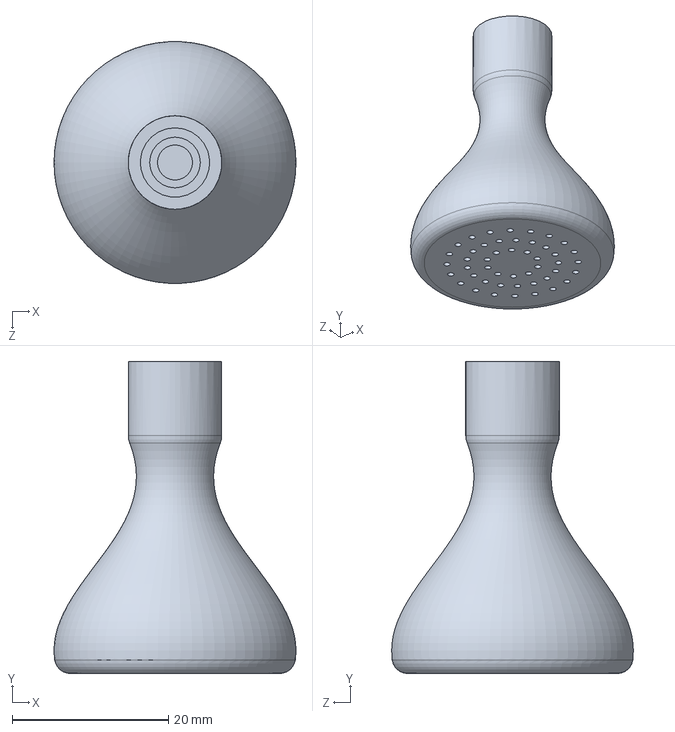
[picture p90: CAD file, 2025-11-08]
aspersor.SLDPRT
31.0 x 40.0 x 31.0 mm
