rod-0310/Senior_Engineering_Design_Project/coudes-pvc-1.snapshot.2/coude30.SLDPRT

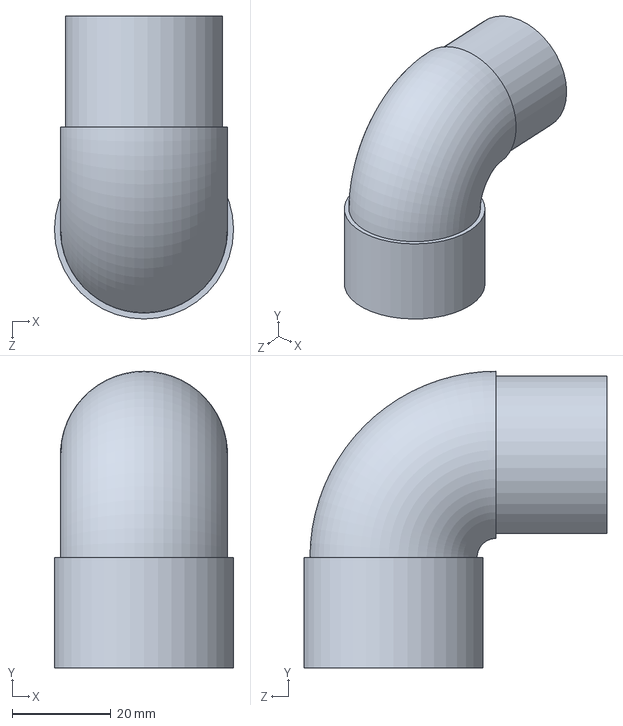
[picture p91: CAD file, 2025-10-15]
coudes-pvc-1.snapshot.2/coude30.SLDPRT
36.2 x 59.9 x 61.2 mm
