rod-0310/Senior_Engineering_Design_Project/plc-7.snapshot.1/PLCPieza2.SLDPRT

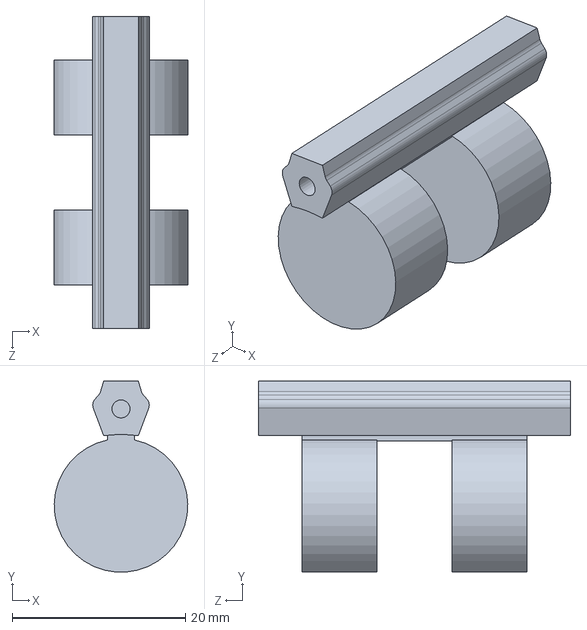
[picture p92: CAD file, 2025-10-19]
plc-7.snapshot.1/PLCPieza2.SLDPRT
15.4 x 22.0 x 36.0 mm
