rod-0310/Senior_Engineering_Design_Project/rodamientos-lineales-linear-bearings-1.snapshot.2/Rodamientos lineales/LM08UU.STEP

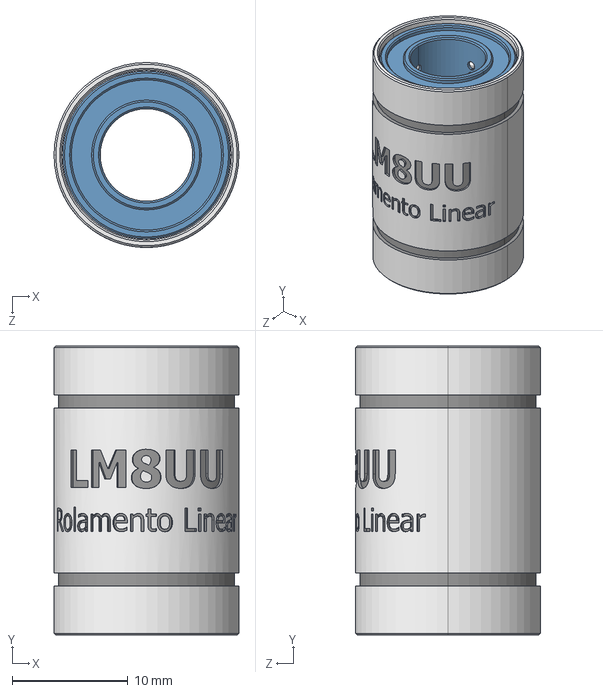
[picture p93: CAD file, 2025-10-17]
rodamientos-lineales-linear-bearings-1.snapshot.2/Rodamientos lineales/LM08UU.STEP
16.0 x 25.0 x 16.0 mm
