rod-0310/Senior_Engineering_Design_Project/aspersor2.STL

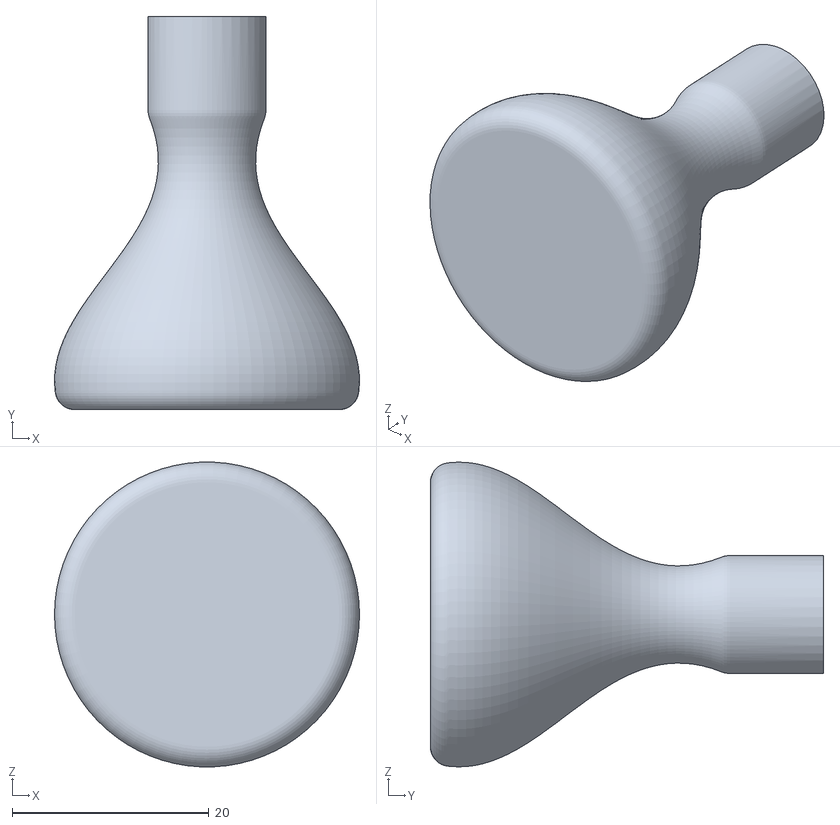
[picture p94: CAD file, 2025-11-08]
aspersor2.STL
31.0 x 40.0 x 31.0
