rod-0310/Senior_Engineering_Design_Project/rodamientos-lineales-linear-bearings-1.snapshot.2/Rodamientos lineales/LM25UU.STEP

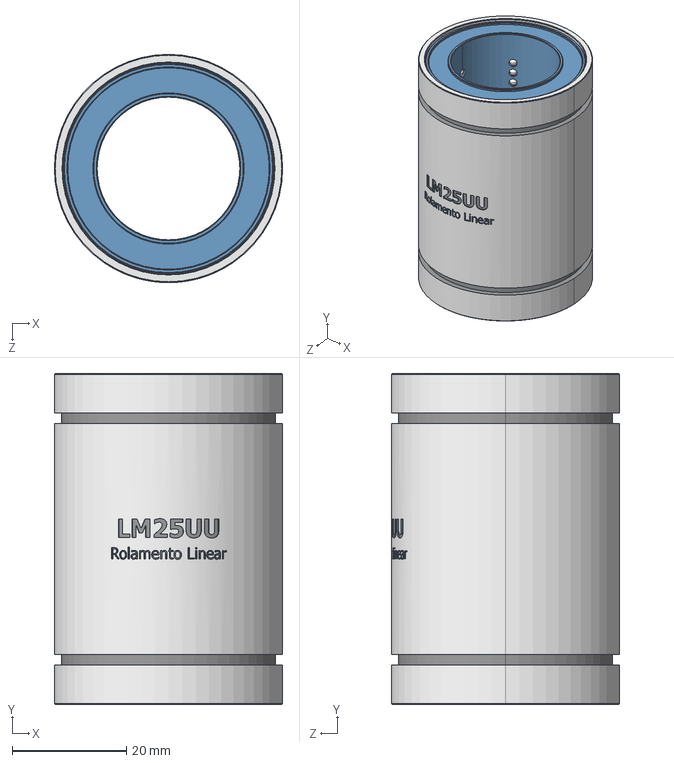
[picture p95: CAD file, 2025-10-17]
rodamientos-lineales-linear-bearings-1.snapshot.2/Rodamientos lineales/LM25UU.STEP
40.0 x 58.0 x 40.0 mm
