rod-0310/Senior_Engineering_Design_Project/acrilico.SLDPRT

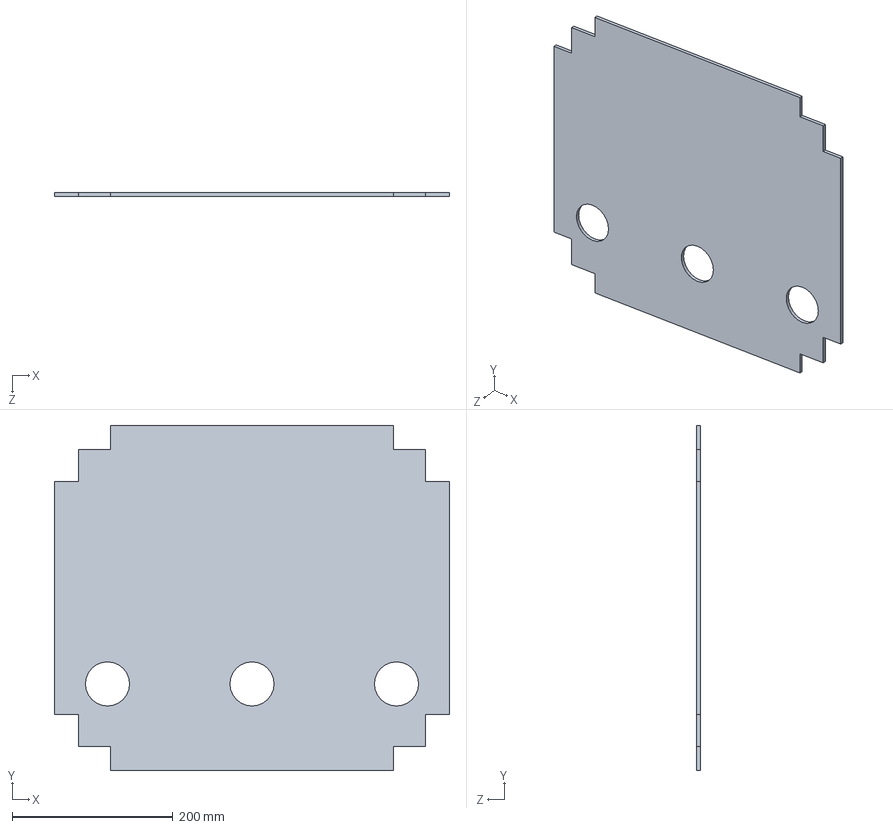
[picture p96: CAD file, 2025-10-27]
acrilico.SLDPRT
492.0 x 430.0 x 5.00 mm
