rod-0310/Senior_Engineering_Design_Project/rodamientos-lineales-linear-bearings-1.snapshot.2/Rodamientos lineales/LM20UU.STEP

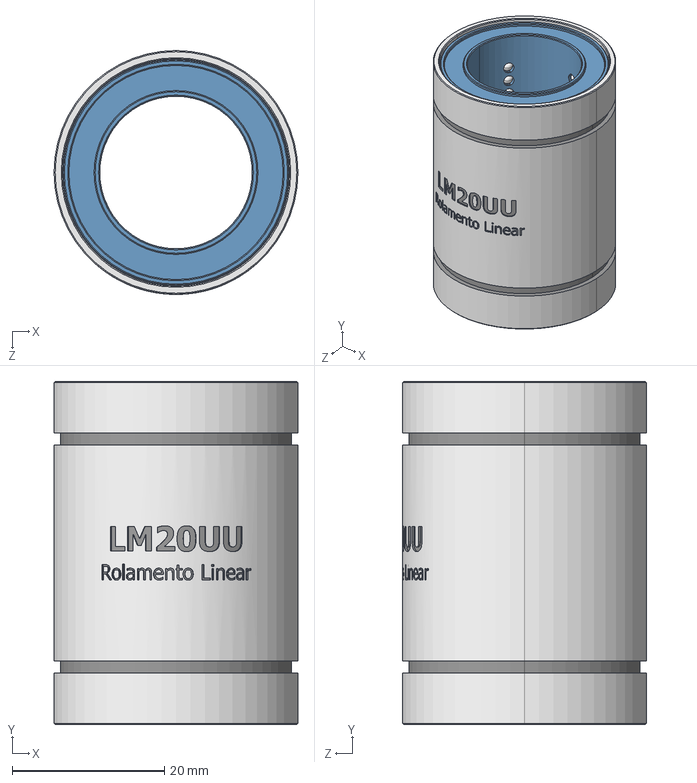
[picture p97: CAD file, 2025-10-17]
rodamientos-lineales-linear-bearings-1.snapshot.2/Rodamientos lineales/LM20UU.STEP
32.0 x 45.0 x 32.0 mm
