rod-0310/Senior_Engineering_Design_Project/esquiero.SLDPRT

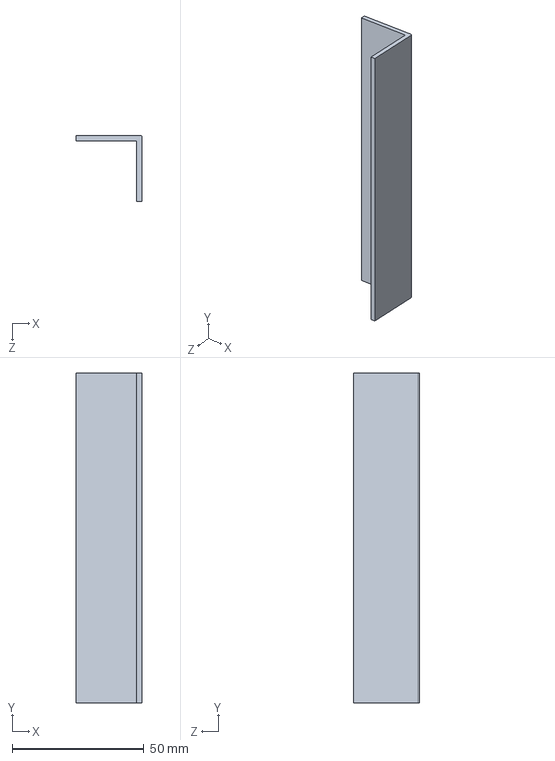
[picture p98: CAD file, 2025-10-27]
esquiero.SLDPRT
25.0 x 125.0 x 25.0 mm
