rod-0310/Senior_Engineering_Design_Project/rodamientos-lineales-linear-bearings-1.snapshot.2/Rodamientos lineales/Piezaacrilico.SLDPRT

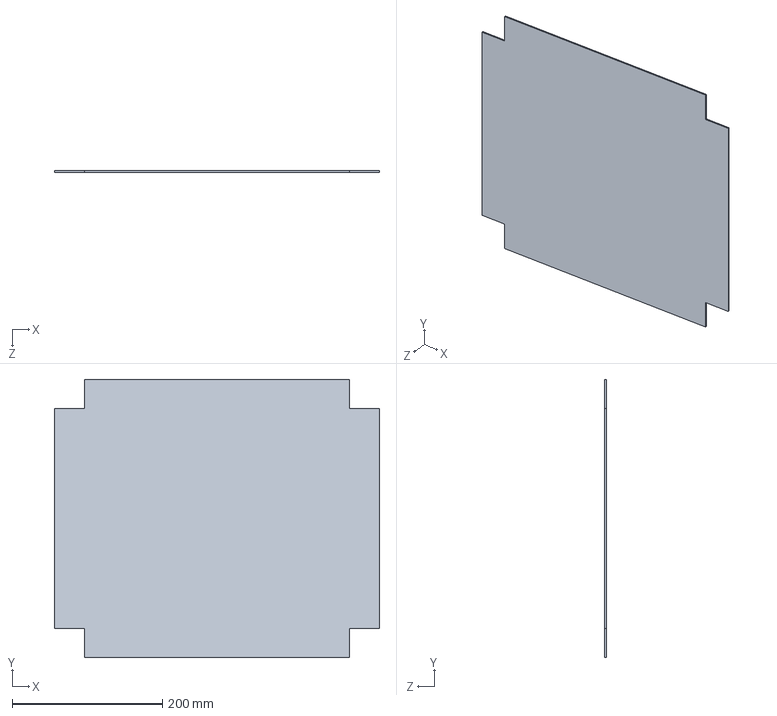
[picture p99: CAD file, 2025-10-17]
rodamientos-lineales-linear-bearings-1.snapshot.2/Rodamientos lineales/Piezaacrilico.SLDPRT
432.0 x 370.0 x 2.00 mm
