rod-0310/Senior_Engineering_Design_Project/soporte_end_stop.SLDPRT

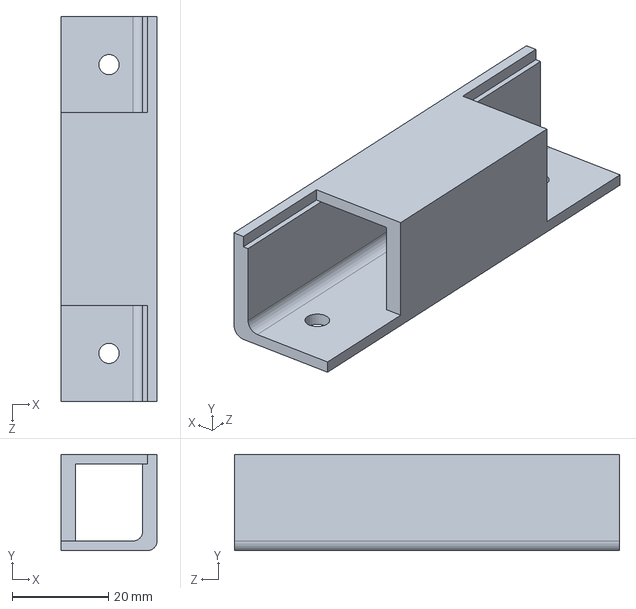
[picture p101: CAD file, 2025-10-25]
soporte_end_stop.SLDPRT
20.0 x 20.0 x 80.0 mm
