rod-0310/Senior_Engineering_Design_Project/case_end_stop.SLDPRT

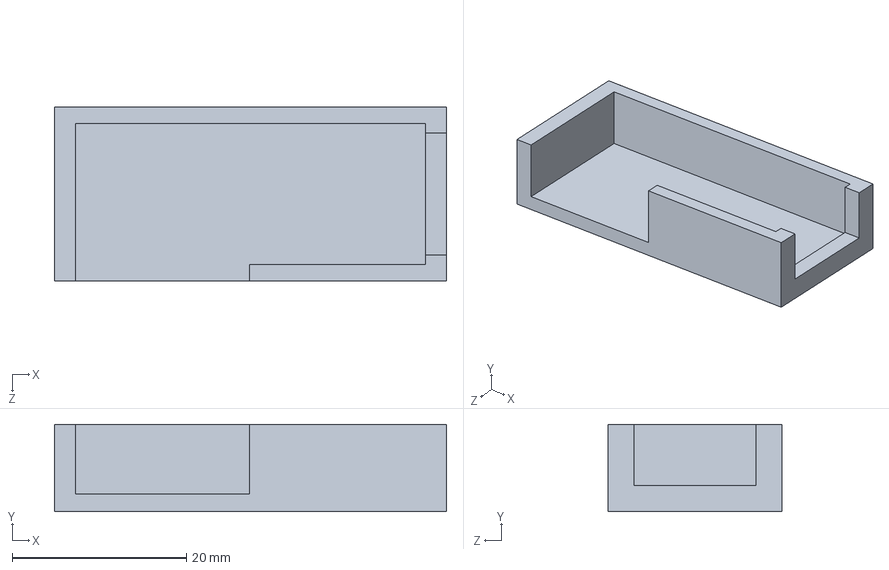
[picture p102: CAD file, 2025-10-25]
case_end_stop.SLDPRT
45.0 x 10.0 x 20.0 mm
