rod-0310/Senior_Engineering_Design_Project/soporte_engrane.SLDPRT

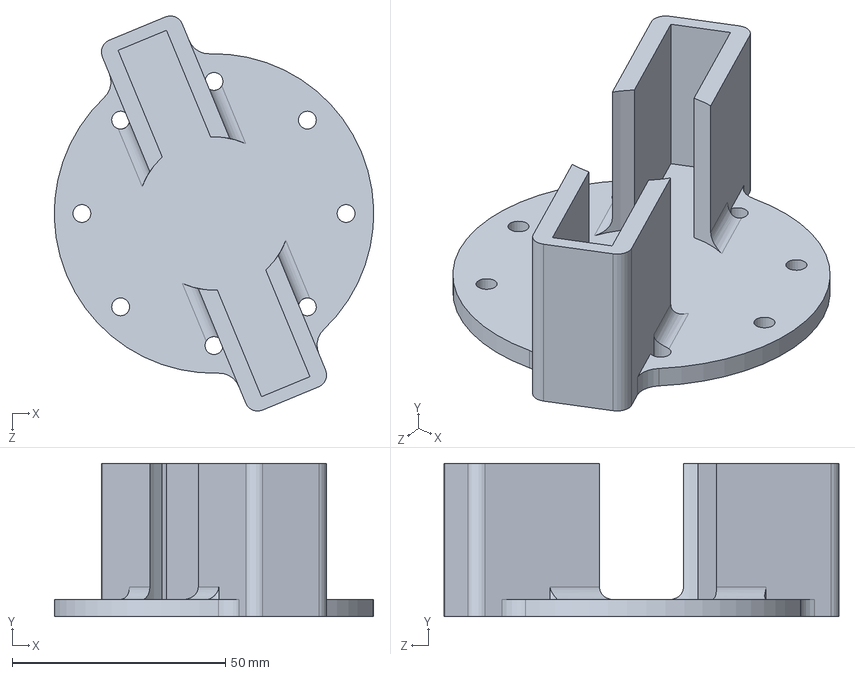
[picture p104: CAD file, 2025-10-25]
soporte_engrane.SLDPRT
75.0 x 36.0 x 92.7 mm
