rod-0310/Senior_Engineering_Design_Project/Pieza3.STL

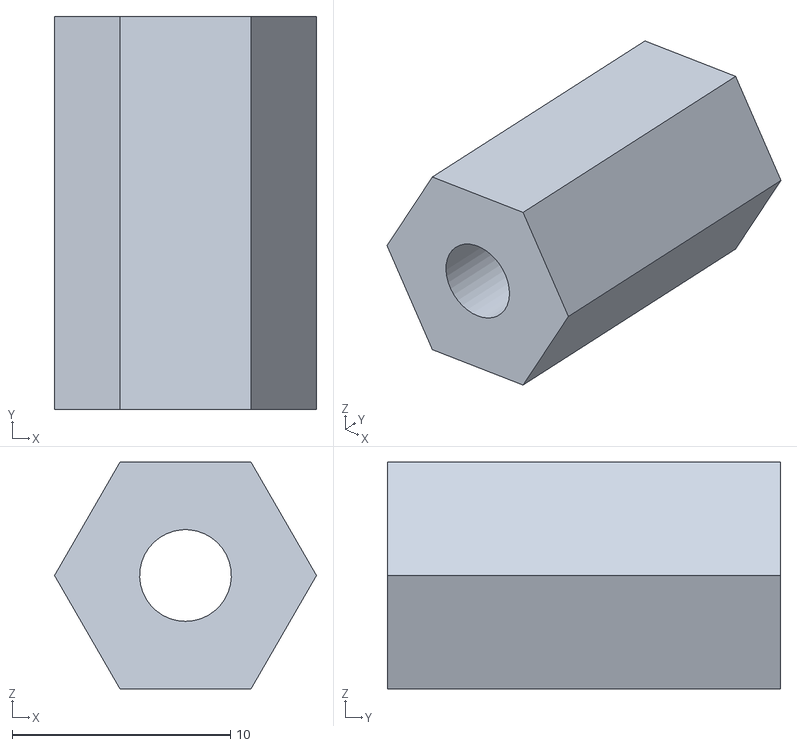
[picture p105: CAD file, 2025-10-25]
Pieza3.STL
12.0 x 18.0 x 10.4
