rod-0310/Senior_Engineering_Design_Project/mesa_v2.SLDPRT

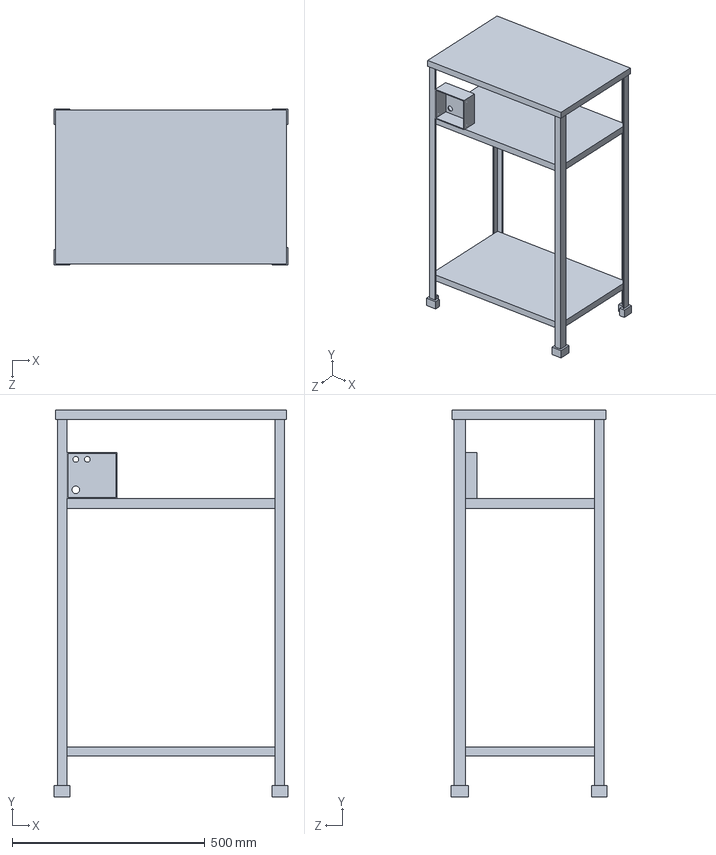
[picture p106: CAD file, 2025-10-19]
mesa_v2.SLDPRT
606.0 x 1004.0 x 406.0 mm
