rod-0310/Senior_Engineering_Design_Project/esp32_caja.SLDPRT

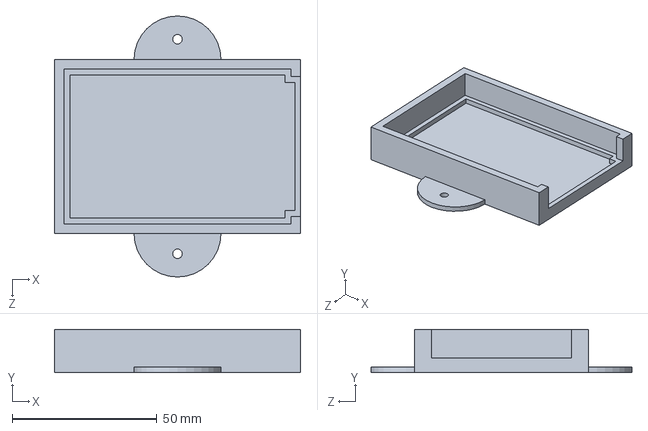
[picture p107: CAD file, 2025-10-19]
esp32_caja.SLDPRT
85.0 x 15.0 x 90.0 mm
