rod-0310/Senior_Engineering_Design_Project/ayuda_estabilizador.SLDPRT

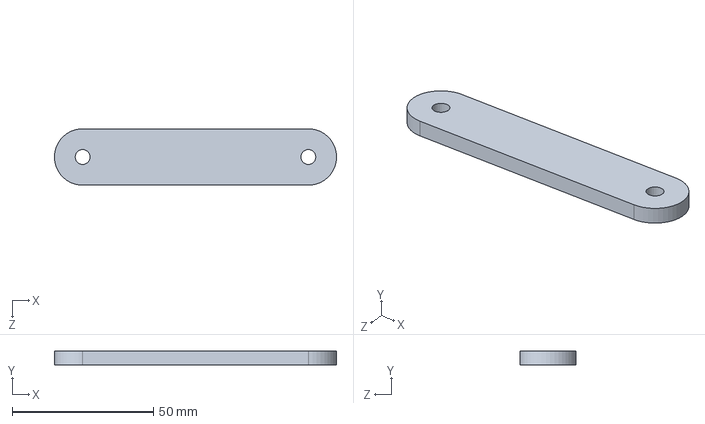
[picture p108: CAD file, 2025-10-17]
ayuda_estabilizador.SLDPRT
99.9 x 5.00 x 20.0 mm
