rod-0310/Senior_Engineering_Design_Project/base_trupan.SLDPRT

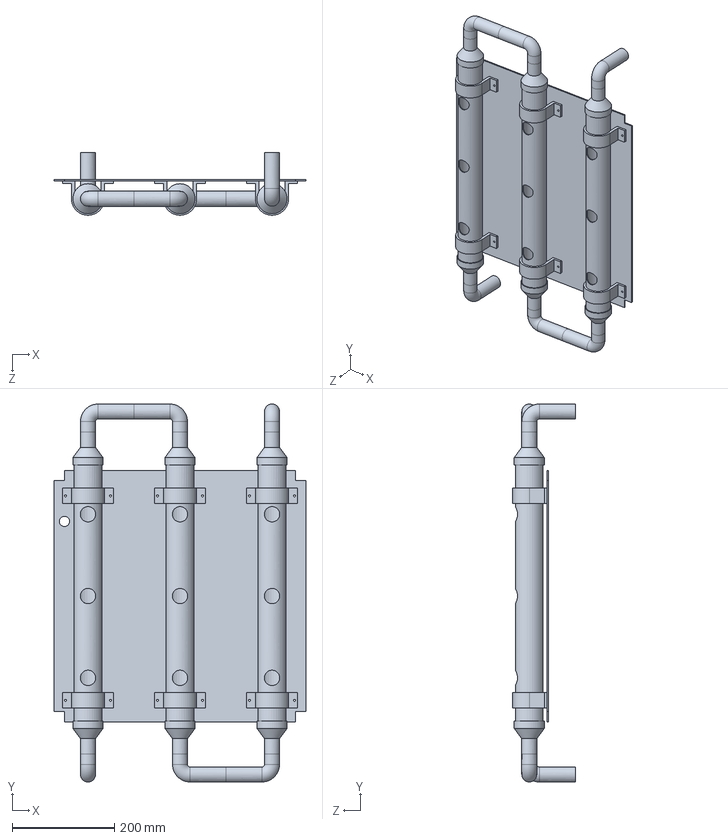
[picture p109: CAD file, 2025-10-17]
base_trupan.SLDPRT
492.0 x 739.4 x 122.3 mm
