rod-0310/Senior_Engineering_Design_Project/acrilico_back.SLDPRT

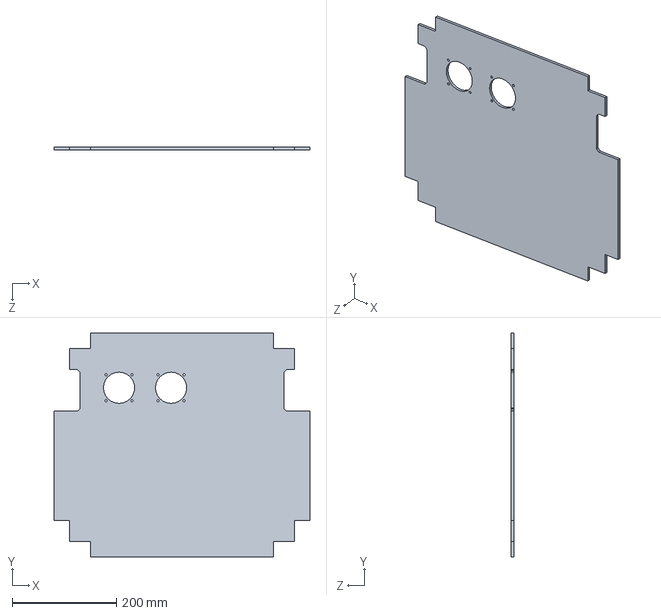
[picture p110: CAD file, 2025-10-17]
acrilico_back.SLDPRT
492.0 x 430.0 x 5.00 mm
