rod-0310/Senior_Engineering_Design_Project/varilla_eje_y.SLDPRT

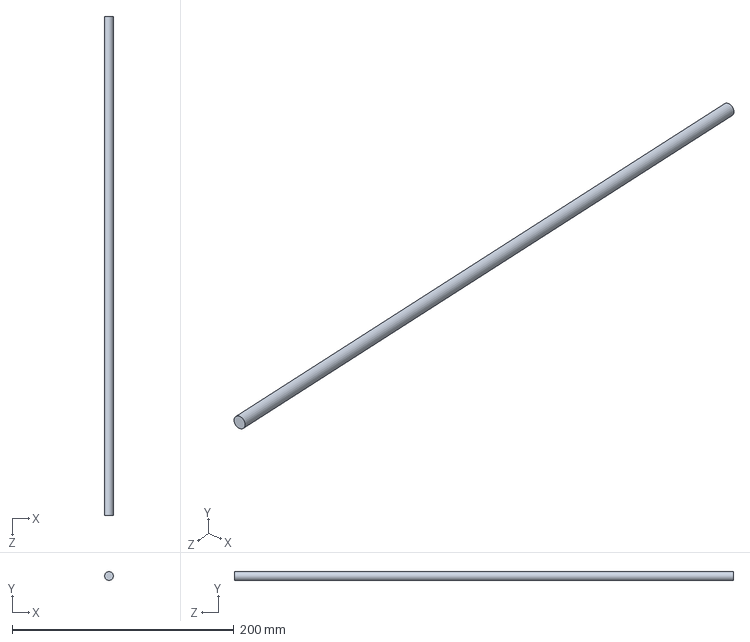
[picture p111: CAD file, 2025-10-17]
varilla_eje_y.SLDPRT
8.00 x 8.00 x 450.0 mm
