rod-0310/Senior_Engineering_Design_Project/motor_bomba.SLDPRT

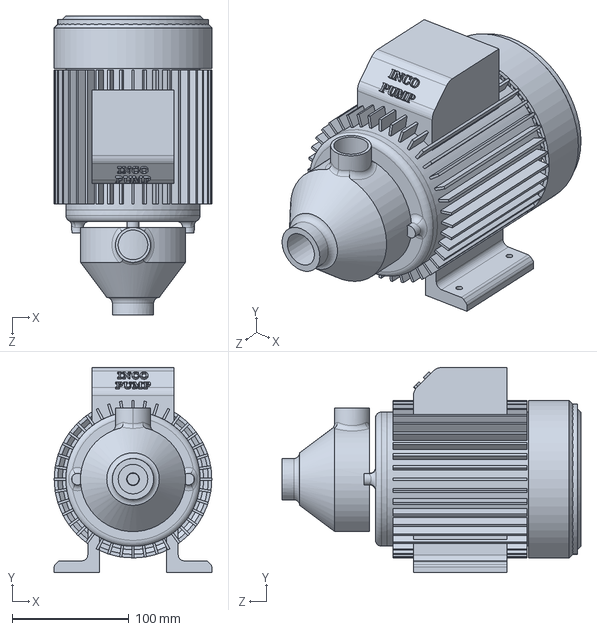
[picture p112: CAD file, 2025-10-17]
motor_bomba.SLDPRT
135.0 x 175.6 x 256.0 mm
