rod-0310/Senior_Engineering_Design_Project/varilla_eje_x.SLDPRT

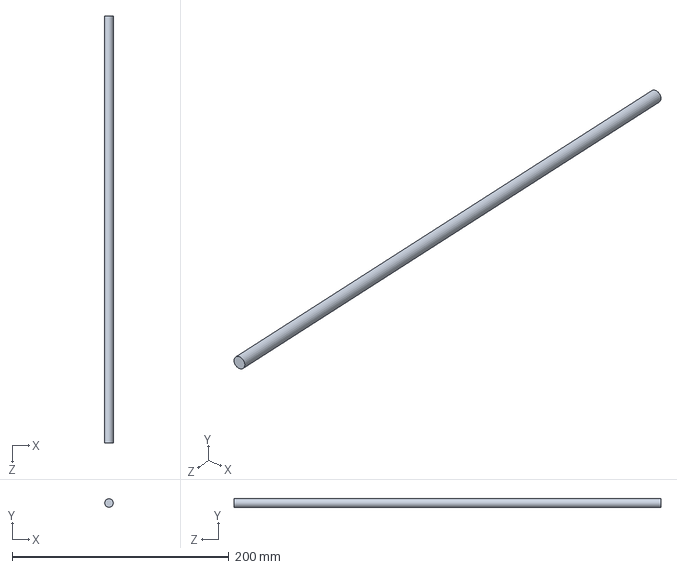
[picture p113: CAD file, 2025-10-17]
varilla_eje_x.SLDPRT
8.00 x 8.00 x 394.0 mm
