rod-0310/Senior_Engineering_Design_Project/mueble.STEP

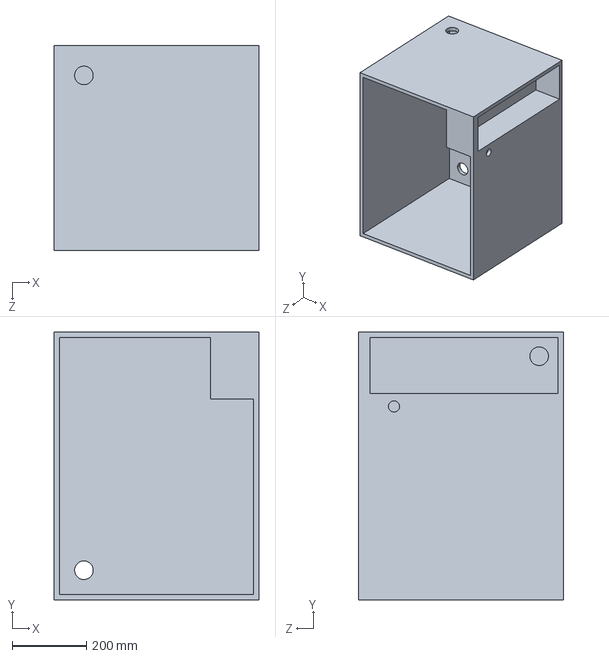
[picture p114: CAD file, 2025-10-16]
mueble.STEP
550.0 x 720.0 x 550.0 mm
