rod-0310/Senior_Engineering_Design_Project/botellon.SLDPRT

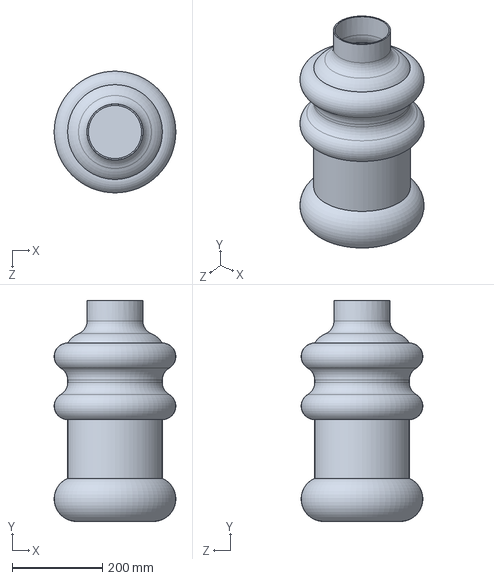
[picture p115: CAD file, 2025-10-14]
botellon.SLDPRT
270.0 x 490.0 x 270.0 mm
