rod-0310/Senior_Engineering_Design_Project/perfil_z.SLDPRT

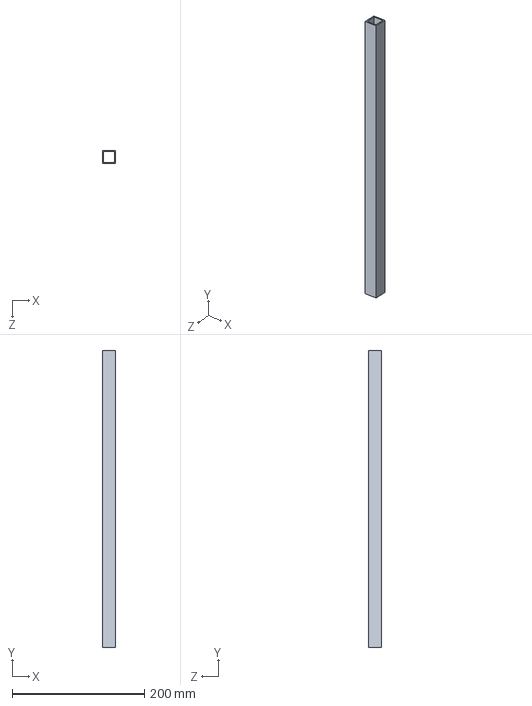
[picture p116: CAD file, 2025-10-14]
perfil_z.SLDPRT
20.0 x 450.0 x 20.0 mm
