rod-0310/Senior_Engineering_Design_Project/soporte_motor.SLDPRT

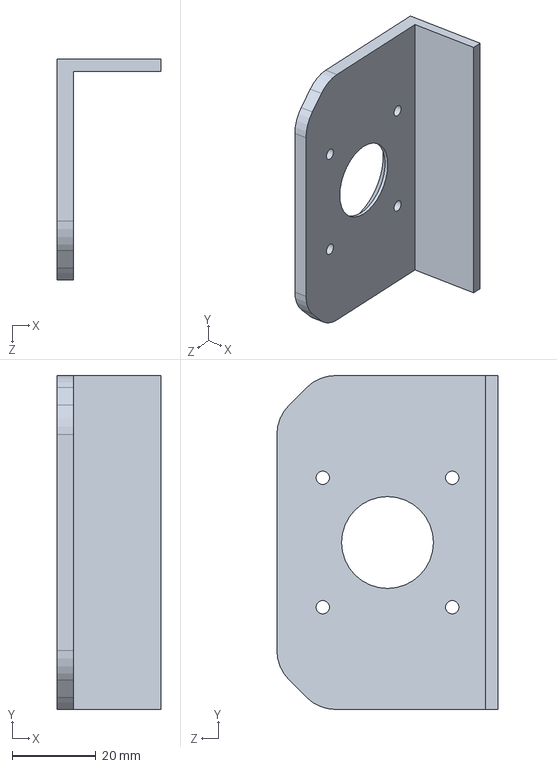
[picture p117: CAD file, 2025-10-14]
soporte_motor.SLDPRT
25.0 x 80.0 x 53.0 mm
