rod-0310/Senior_Engineering_Design_Project/esquinero_varillas.SLDPRT

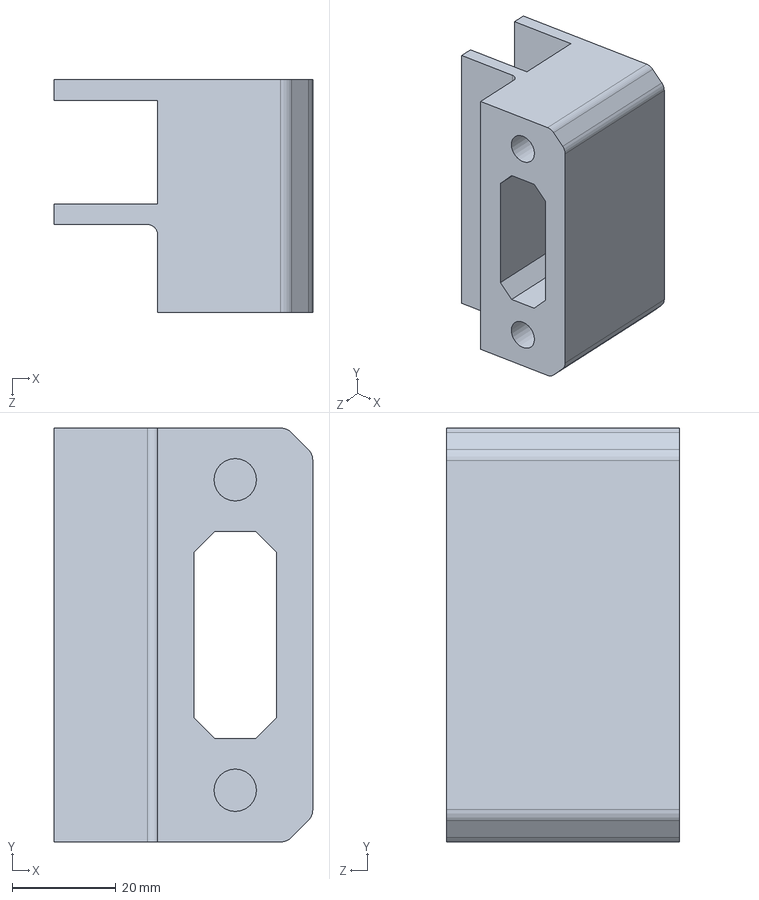
[picture p118: CAD file, 2025-10-14]
esquinero_varillas.SLDPRT
50.0 x 80.0 x 45.0 mm
