rod-0310/Senior_Engineering_Design_Project/esquinero.SLDPRT

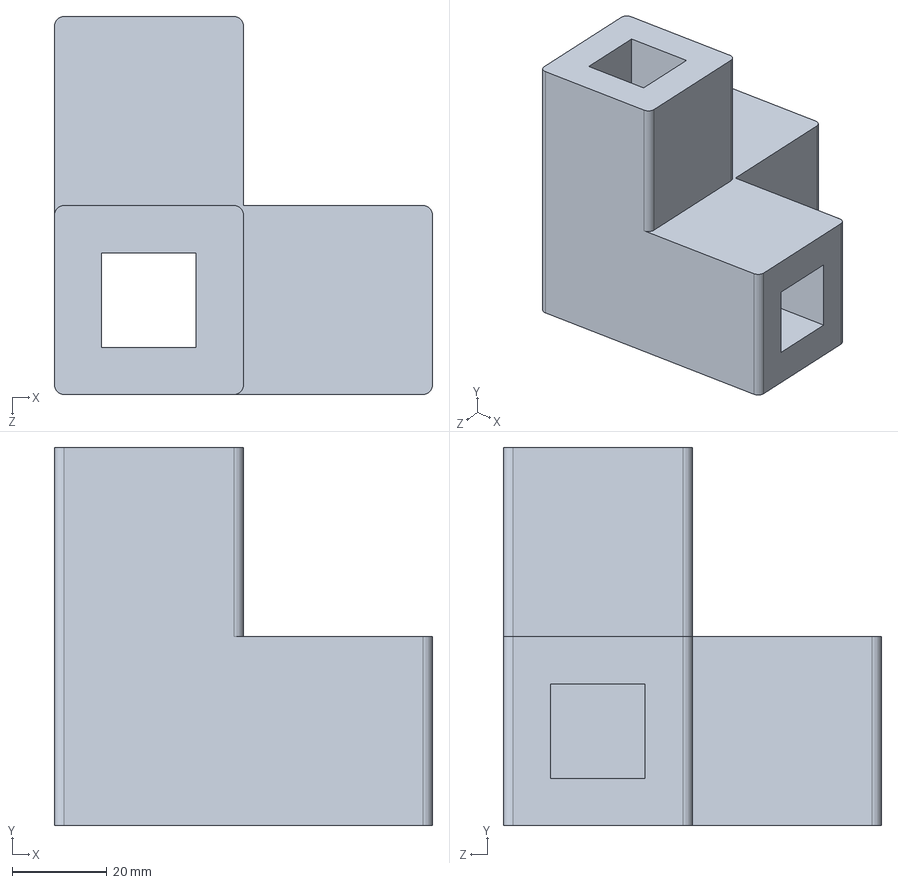
[picture p119: CAD file, 2025-10-14]
esquinero.SLDPRT
80.0 x 80.0 x 80.0 mm
