rod-0310/Senior_Engineering_Design_Project/(list of files, cad)

Other CAD files:
perfil_x_y.SLDPRT
Nema 17 42x40x5/Nima 17 40x42x5mm.SLDPRT
aspersor.STL
ayuda_estabilizador.STL
base_trupan.STL
bomba-march-pump-1.snapshot.9/BOMBA MARCH ENVASADO.SLDPRT
case_end_stop.STL
esp32_caja.STL
esquiero.STL
fan-60x60-techman-1.snapshot.1/ventilador 60x60.IGS
fan-60x60-techman-1.snapshot.1/ventilador 60x60.SLDPRT
mesa_v2.STL
mueble.SLDPRT
pulley-gt2-20-tooth-5-bore-gt2-1.snapshot.1/Шкив GT2 20T b5.SLDPRT
rodamientos-lineales-linear-bearings-1.snapshot.2/Rodamientos lineales/LM00UU.iam
rodamientos-lineales-linear-bearings-1.snapshot.2/Rodamientos lineales/LM08UU.SLDPRT
rodamientos-lineales-linear-bearings-1.snapshot.2/Rodamientos lineales/LM08UU.ipt
rodamientos-lineales-linear-bearings-1.snapshot.2/Rodamientos lineales/LM12UU.ipt
rodamientos-lineales-linear-bearings-1.snapshot.2/Rodamientos lineales/LM20UU.ipt
soporte_engrane.STL
tapa_tubo.STL
tb6600-driver-1.snapshot.1/TB-6600.SLDPRT
