rod-0310/Senior_Engineering_Design_Project/vision/runs/detect/train2/results.csv

epoch | time | train/box_loss | train/cls_loss | train/dfl_loss | metrics/precision(B) | metrics/recall(B) | metrics/mAP50(B) | metrics/mAP50-95(B) | val/box_loss | val/cls_loss | val/dfl_loss | lr/pg0 | lr/pg1 | lr/pg2
1 | 10.9466 | 1.32815 | 2.60389 | 1.57528 | 0.94121 | 0.42667 | 0.66832 | 0.44163 | 1.09856 | 2.43508 | 1.2922 | 0.000468121 | 0.000468121 | 0.000468121
2 | 20.1202 | 1.24903 | 1.49288 | 1.49218 | 0.68502 | 0.86576 | 0.829 | 0.52437 | 1.20869 | 1.30018 | 1.43319 | 0.000925754 | 0.000925754 | 0.000925754
3 | 29.2937 | 1.23315 | 1.29288 | 1.4521 | 0.70659 | 0.73476 | 0.82619 | 0.49028 | 1.39503 | 1.40031 | 1.48149 | 0.00136452 | 0.00136452 | 0.00136452
4 | 38.4103 | 1.22608 | 1.23142 | 1.44725 | 0.76921 | 0.84259 | 0.872 | 0.54476 | 1.25636 | 1.13215 | 1.38756 | 0.00134412 | 0.00134412 | 0.00134412
5 | 47.56 | 1.20106 | 1.13561 | 1.4281 | 0.86786 | 0.92416 | 0.94617 | 0.63346 | 1.08196 | 0.82545 | 1.26424 | 0.00131582 | 0.00131582 | 0.00131582
6 | 56.7059 | 1.1602 | 1.06737 | 1.39668 | 0.92252 | 0.95634 | 0.98143 | 0.6738 | 1.09331 | 0.87528 | 1.25483 | 0.00128753 | 0.00128753 | 0.00128753
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
