rod-0310/Senior_Engineering_Design_Project/vision/runs/detect/train4/results.csv

epoch | time | train/box_loss | train/cls_loss | train/dfl_loss | metrics/precision(B) | metrics/recall(B) | metrics/mAP50(B) | metrics/mAP50-95(B) | val/box_loss | val/cls_loss | val/dfl_loss | lr/pg0 | lr/pg1 | lr/pg2
1 | 8.81524 | 1.32815 | 2.60389 | 1.57528 | 0.94121 | 0.42667 | 0.66832 | 0.44163 | 1.09856 | 2.43508 | 1.2922 | 0.000468121 | 0.000468121 | 0.000468121
2 | 16.6808 | 1.24734 | 1.47346 | 1.48606 | 0.79051 | 0.94173 | 0.93832 | 0.6009 | 1.16167 | 1.1691 | 1.39145 | 0.000939779 | 0.000939779 | 0.000939779
3 | 24.713 | 1.23082 | 1.28108 | 1.45106 | 0.78891 | 0.80526 | 0.85625 | 0.48443 | 1.36263 | 1.40103 | 1.45247 | 0.00140672 | 0.00140672 | 0.00140672
4 | 32.6393 | 1.23057 | 1.24324 | 1.46115 | 0.90335 | 0.88815 | 0.95969 | 0.63382 | 1.12337 | 0.92745 | 1.29196 | 0.00140778 | 0.00140778 | 0.00140778
5 | 40.5359 | 1.20481 | 1.14723 | 1.4344 | 0.89112 | 0.92309 | 0.9692 | 0.6492 | 1.15683 | 0.84902 | 1.31899 | 0.00140071 | 0.00140071 | 0.00140071
6 | 48.5134 | 1.17713 | 1.0649 | 1.4117 | 0.88767 | 0.77116 | 0.90914 | 0.60903 | 1.15325 | 1.06243 | 1.27271 | 0.00139363 | 0.00139363 | 0.00139363
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
