rod-0310/Senior_Engineering_Design_Project/vision/runs/detect/train6/results.csv

epoch | time | train/box_loss | train/cls_loss | train/dfl_loss | metrics/precision(B) | metrics/recall(B) | metrics/mAP50(B) | metrics/mAP50-95(B) | val/box_loss | val/cls_loss | val/dfl_loss | lr/pg0 | lr/pg1 | lr/pg2
1 | 59.526 | 1.40002 | 2.75789 | 1.73186 | 0.75337 | 0.29635 | 0.41796 | 0.1996 | 1.45933 | 2.34407 | 1.827 | 0.000469005 | 0.000469005 | 0.000469005
2 | 118.912 | 1.34324 | 1.92399 | 1.66916 | 0.40809 | 0.54334 | 0.42311 | 0.21028 | 2.13676 | 2.29916 | 2.38346 | 0.00093598 | 0.00093598 | 0.00093598
3 | 178.33 | 1.36254 | 1.75337 | 1.6778 | 0.68239 | 0.63077 | 0.72289 | 0.36683 | 1.73841 | 1.83796 | 2.12189 | 0.00139352 | 0.00139352 | 0.00139352
4 | 237.592 | 1.34228 | 1.66857 | 1.66963 | 0.52828 | 0.52983 | 0.53448 | 0.25182 | 1.82435 | 2.22866 | 2.13227 | 0.00138656 | 0.00138656 | 0.00138656
5 | 296.926 | 1.30143 | 1.53075 | 1.61936 | 0.81283 | 0.80288 | 0.8375 | 0.47592 | 1.41559 | 1.36563 | 1.68818 | 0.00137241 | 0.00137241 | 0.00137241
6 | 355.938 | 1.25818 | 1.46638 | 1.59826 | 0.87923 | 0.72567 | 0.8462 | 0.43849 | 1.61191 | 1.46708 | 1.89486 | 0.00135826 | 0.00135826 | 0.00135826
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
