rod-0310/Senior_Engineering_Design_Project/vision/runs/detect/train2/results.png

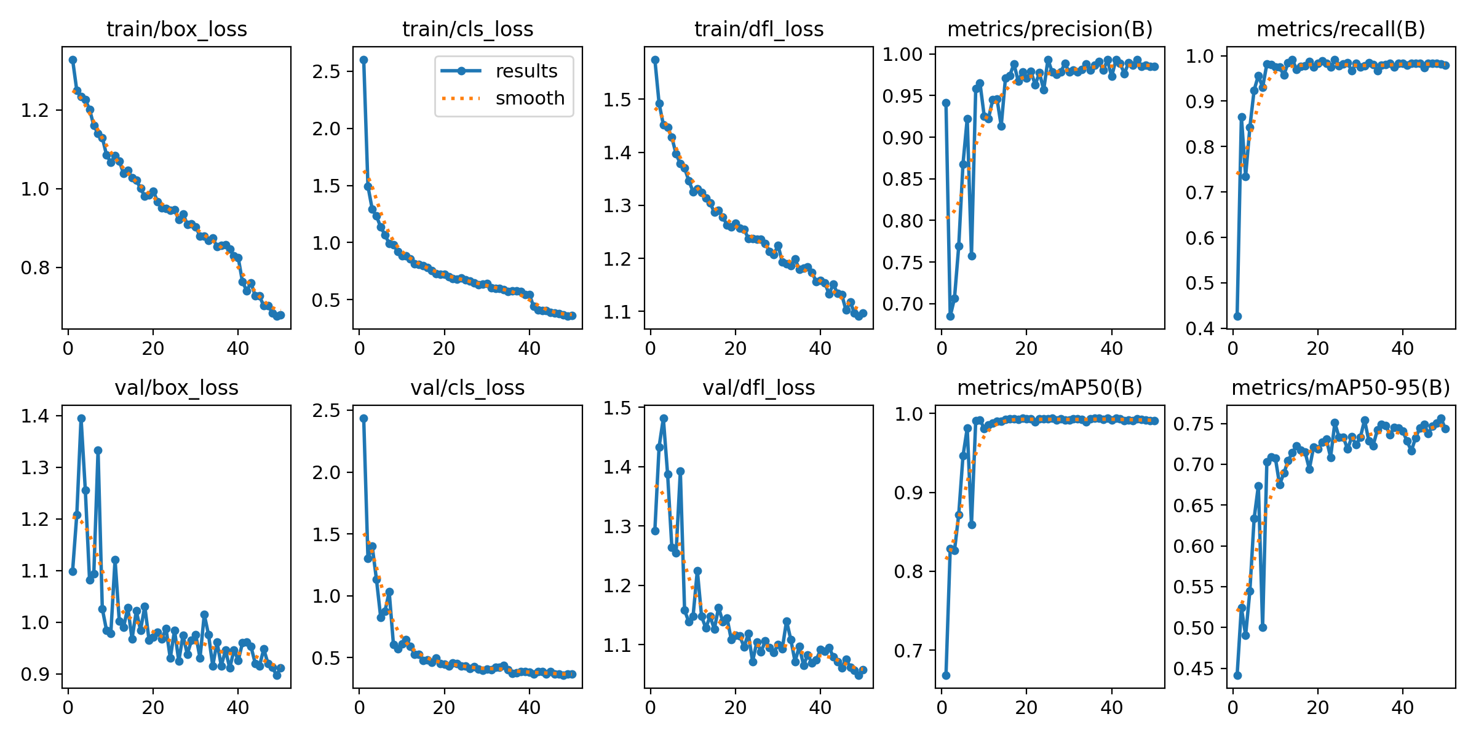
vision/runs/detect/train2/results.png
