rod-0310/Senior_Engineering_Design_Project/esp32-devkit_1-shield-expansion-board-1.snapshot.10/Circuit Diagram.pdf

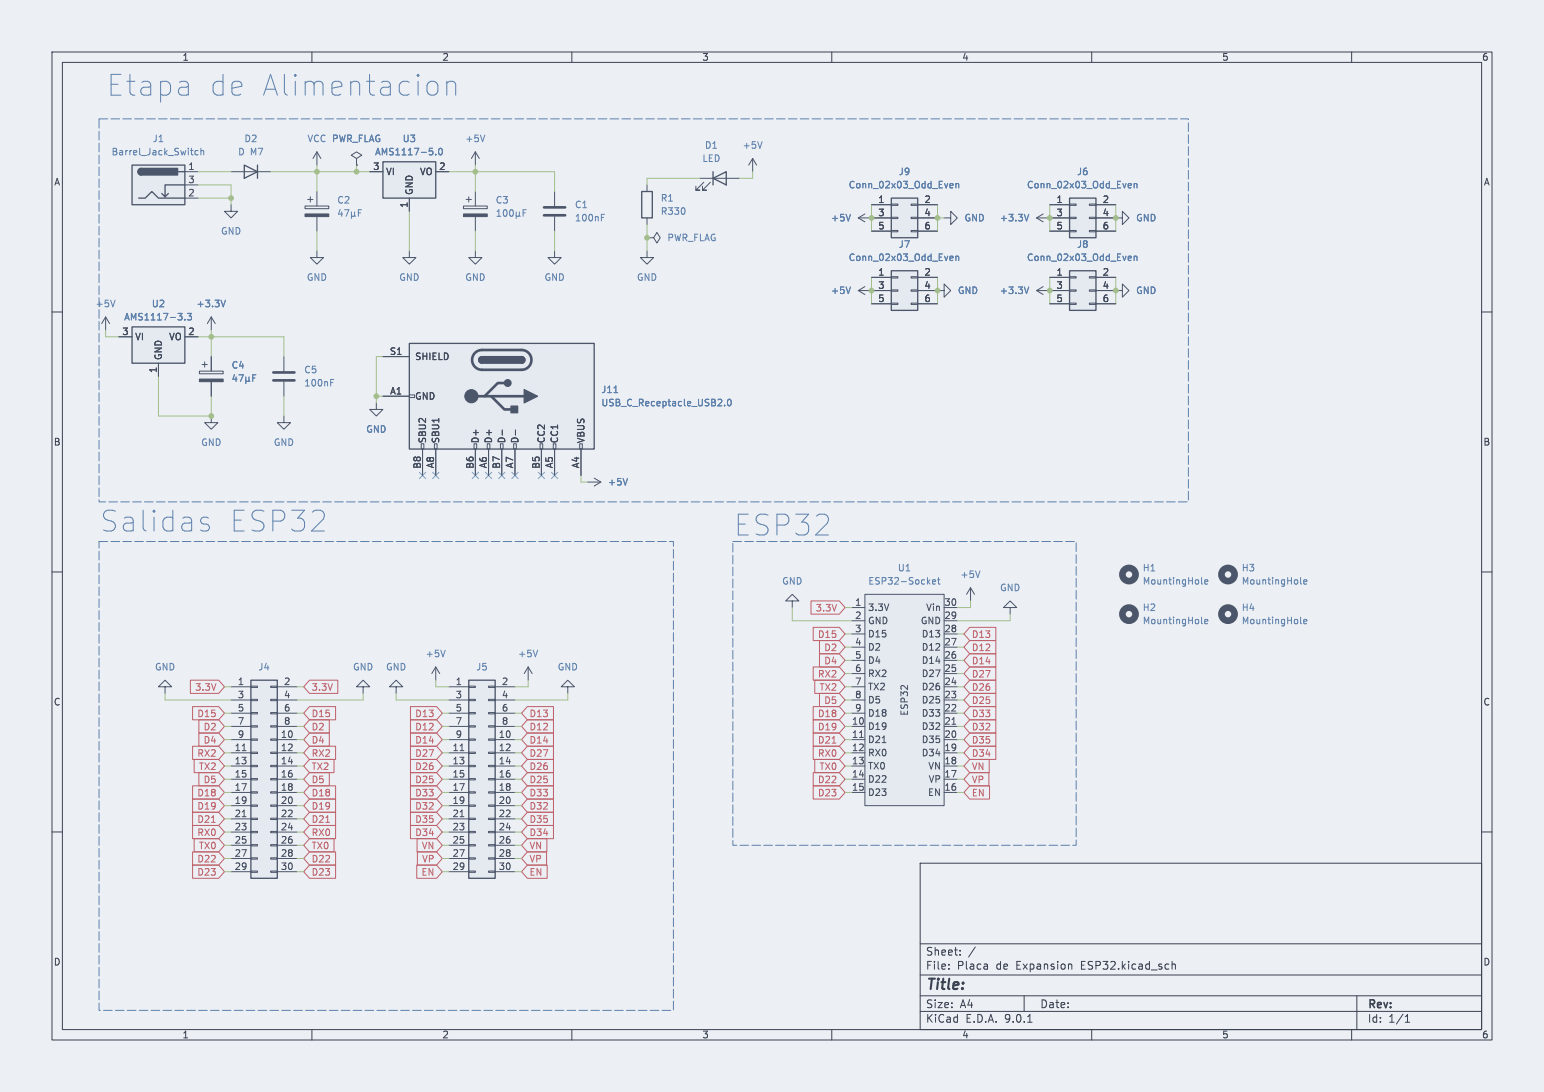
[picture p121: page 1]
