rod-0310/Senior_Engineering_Design_Project/FINAL_V2/FINAL_V2.ino

#include <SmoothThermistor.h>
#include <PID_v1.h>
#include <esp32-hal-timer.h>
#include <esp32-hal-ledc.h>
#include <driver/adc.h>

#include <FastAccelStepper.h>
#include <freertos/FreeRTOS.h>
#include <freertos/task.h>
#include <freertos/queue.h>
#include <freertos/event_groups.h>
#include "soc/gpio_struct.h"
#include <math.h>

// ================== MQTT / WiFi ==================
#include <WiFi.h>
#include <PubSubClient.h>

// ---- CONFIGURACIÓN WIFI ----
const char* WIFI_SSID     = "Mikisito";        // <- IGUAL
const char* WIFI_PASSWORD = "admin12345";      // <- IGUAL

// --- Broker MQTT local (Home Assistant / Mosquitto) ---
#define MQTT_SERVER        "192.168.0.109"   // <- AHORA TU BROKER LOCAL
#define MQTT_PORT          1883

// Credenciales MQTT
const char* MQTT_USER     = "mqtt_user";
const char* MQTT_PASS     = "hidrovida123";

// Prefijo de tópicos de telemetría
const char* MQTT_TOPIC_TEMP      = "hidrovida/temp";
const char* MQTT_TOPIC_SETPOINT  = "hidrovida/setpoint";
const char* MQTT_TOPIC_HEATER    = "hidrovida/heater";
const char* MQTT_TOPIC_FAN       = "hidrovida/fan";
const char* MQTT_TOPIC_PUMP      = "hidrovida/pump";
const char* MQTT_TOPIC_POSX      = "hidrovida/posx";
const char* MQTT_TOPIC_POSY      = "hidrovida/posy";
const char* MQTT_TOPIC_SAFETY    = "hidrovida/safety";

// NUEVOS: tópicos de estado de periodos (en minutos)
const char* MQTT_TOPIC_ANALISIS_PERIOD  = "hidrovida/period/analisis";
const char* MQTT_TOPIC_FUMIGADO_PERIOD  = "hidrovida/period/fumigado";

// NUEVO: estado del sensor de temperatura
// Ejemplos de payload: "ok", "okoc", "okidle", "nan", "out_of_range_low", "out_of_range_high"
const char* MQTT_TOPIC_TEMP_SENSOR      = "hidrovida/temp_sensor_state";

// Tópicos de comandos
const char* MQTT_TOPIC_CMD_ANALISIS         = "hidrovida/cmd/analisis";
const char* MQTT_TOPIC_CMD_SP               = "hidrovida/cmd/sp";
const char* MQTT_TOPIC_CMD_SAFE             = "hidrovida/cmd/safe";
const char* MQTT_TOPIC_CMD_RAW              = "hidrovida/cmd/raw";
const char* MQTT_TOPIC_CMD_MODE             = "hidrovida/cmd/mode";  // modo AUTO/MANUAL
// NUEVOS: comandos para cambiar periodos (minutos)
const char* MQTT_TOPIC_CMD_ANALISIS_PERIOD  = "hidrovida/cmd/analisis_period";
const char* MQTT_TOPIC_CMD_FUMIGADO_PERIOD  = "hidrovida/cmd/fumigado_period";

// Cliente WiFi/MQTT
WiFiClient espClient;
PubSubClient mqttClient(espClient);

/* ===================== HELPERS SALIDA (TODO POR Serial) ===================== */
static inline void OUT_print(const String &s){ Serial.print(s); }
static inline void OUT_print(const char* s) { Serial.print(s); }
static inline void OUT_println(const String &s){ Serial.println(s); }
static inline void OUT_println(const char* s) { Serial.println(s); }

/* ===================== MODOS DE OPERACIÓN ===================== */
enum : uint8_t { MODE_AUTO = 0, MODE_MANUAL = 1 };
volatile uint8_t opMode = MODE_AUTO;   // Arranca siempre en modo AUTOMÁTICO

// Control manual en modo MANUAL
double heater_manual_pct = 0.0;  // 0-100%
double fan_manual_pct    = 0.0;  // 0-100%

/* =====================================================================
 *  BLOQUE 1: CONTROL DE TEMPERATURA + DIMMER + VENTILADORES (PIN 12 y 26)
 * ===================================================================== */

#define MAINS_FREQ_HZ        50
static const uint32_t HALF_CYCLE_US = (1000000UL / (MAINS_FREQ_HZ * 2));

double SETPOINT_C = 22.0;
const double SP_MIN = 0.0;
const double SP_MAX = 80.0;

// PID_v1 — Ts=0.1 s
double Kp = 2.0450;
double Ki = 0.8149;
double Kd = 1.4046;
const uint16_t PID_SAMPLE_MS = 100;

const double U_MIN = 25.0;   // 25 %
const double U_MAX = 100.0;  // 100 %

const int PIN_FAN_IN   = 12;
const int PIN_FAN_OUT  = 26;
const int FAN_PWM_HZ   = 25000;
const int FAN_PWM_BITS = 10;
const uint32_t FAN_MAX = (1u << FAN_PWM_BITS) - 1;

const double FAN_MIN_PCT = 0.0;
const double FAN_MAX_PCT = 100.0;

// Dimmer
const int PIN_ZC    = 27;
const int PIN_DIM   = 14;
const uint32_t GATE_PULSE_US = 75;
const uint32_t ZC_BLANK_US   = 500;

// Termistor NTC
const int PIN_NTC_ADC = 34;
SmoothThermistor ntc(
  PIN_NTC_ADC,
  ADC_SIZE_12_BIT,
  100000,
  100000,
  3950,
  25,
  25
);

// Rango esperado de trabajo
const double TEMP_MIN_C = 0.0;
const double TEMP_MAX_C = 40.0;

volatile double y_tempC = 25.0;
volatile double u_duty  = 0.0;
PID myPID((double*)&y_tempC, (double*)&u_duty, &SETPOINT_C, Kp, Ki, Kd, DIRECT);

volatile bool safety_trip = false;
volatile bool sensor_ok   = true;
volatile bool emergency_stop = false;

volatile double t_raw_last   = NAN;
volatile double fan_pct_last = 0.0;
volatile double fan_in_pct   = 0.0;
volatile double fan_out_pct  = 0.0;

hw_timer_t* fireTimer = nullptr;

volatile uint32_t u_delay_us = 0;
volatile bool gate_enable    = true;
volatile uint32_t last_zc_us = 0;

// 0 = ok, 1 = NaN, 2 = fuera de rango bajo, 3 = fuera de rango alto
volatile uint8_t temp_error_code = 0;

// Bandera: PID en control crítico (en HOME, modo AUTO, sin errores)
volatile bool pid_guard_armed = false;

/* ===================== FILTROS TEMP ===================== */
#define USE_MEDIAN5       1
#define USE_EMA_IIR       1
#define USE_RATE_LIMITER  1

static const double SENSE_DT_S = 0.150;
static const double TEMP_TAU_S = 1.5;
static const double MAX_SLOPE_C_PER_S = 2.0;

static double ema_state = NAN;
static double last_filtered = NAN;
static double fan_cmd_smooth = NAN;

#if USE_MEDIAN5
static double m5_buf[5];
static uint8_t m5_idx = 0;
static bool m5_filled = false;

double median5_push(double x) {
  m5_buf[m5_idx] = x;
  m5_idx = (m5_idx + 1) % 5;
  if (m5_idx == 0) m5_filled = true;
  double v[5];
  uint8_t n = m5_filled ? 5 : m5_idx;
  for (uint8_t i=0;i<n;i++) v[i] = m5_buf[i];
  for (uint8_t i=1;i<n;i++) {
    double key = v[i];
    int j = i - 1;
    while (j >= 0 && v[j] > key) { v[j+1] = v[j]; j--; }
    v[j+1] = key;
  }
  if (n == 0) return x;
  if (n % 2 == 1) return v[n/2];
  return 0.5*(v[n/2 - 1] + v[n/2]);
}
#endif

#if USE_EMA_IIR
double ema_update(double x) {
  const double alpha = SENSE_DT_S / (TEMP_TAU_S + SENSE_DT_S);
  if (isnan(ema_state)) ema_state = x;
  ema_state = ema_state + alpha * (x - ema_state);
  return ema_state;
}
#endif

#if USE_RATE_LIMITER
double slope_limit(double x_prev, double x_now) {
  if (isnan(x_prev)) return x_now;
  const double max_step = MAX_SLOPE_C_PER_S * SENSE_DT_S;
  double delta = x_now - x_prev;
  if (delta >  max_step) return x_prev + max_step;
  if (delta < -max_step) return x_prev - max_step;
  return x_now;
}
#endif

double filter_temperature(double t_raw) {
  double t = t_raw;
#if USE_MEDIAN5
  t = median5_push(t);
#endif
#if USE_EMA_IIR
  t = ema_update(t);
#endif
#if USE_RATE_LIMITER
  t = slope_limit(last_filtered, t);
#endif
  last_filtered = t;
  return t;
}

/* ===================== UTILS PID (ANTES DE USARSE) ===================== */
inline uint32_t dutyToDelayUs(double dutyPct) {
  double d = constrain(dutyPct, 0.0, 100.0);
  double alpha = (1.0 - d/100.0) * PI;
  uint32_t delayUs = (uint32_t)((alpha/PI) * HALF_CYCLE_US);
  if (delayUs < 200) delayUs = 200;
  if (delayUs > HALF_CYCLE_US - 200) delayUs = HALF_CYCLE_US - 200;
  return delayUs;
}

inline double heater_to_fan_inverse(double heaterPct) {
  double h = constrain(heaterPct, U_MIN, U_MAX);
  double norm = (h - U_MIN) / (U_MAX - U_MIN);
  double fan = FAN_MAX_PCT * (1.0 - norm);
  fan = constrain(fan, FAN_MIN_PCT, FAN_MAX_PCT);
  return fan;
}

inline double fan_smooth(double target) {
  const double alpha = 0.2;
  if (isnan(fan_cmd_smooth)) fan_cmd_smooth = target;
  fan_cmd_smooth = fan_cmd_smooth + alpha * (target - fan_cmd_smooth);
  return fan_cmd_smooth;
}

inline double clampSP(double sp){
  if (sp < SP_MIN) sp = SP_MIN;
  if (sp > SP_MAX) sp = SP_MAX;
  return sp;
}

/* =====================================================================
 *  BLOQUE 2: CNC 2 EJES + LED DE ANÁLISIS PWM + BOMBA
 * ===================================================================== */

// PUNTOS DE ANÁLISIS (P1..P6)
static const float PX[6] = { 20.0f, 200.0f, 200.0f,  20.0f,  20.0f, 200.0f };
static const float PY[6] = {  0.0f,   0.0f, 130.0f, 130.0f, 265.0f, 265.0f };

// PUNTOS DE FUMIGADO (F1..F6)
static const float FX[6] = { 25.0f, 195.0f, 195.0f,  25.0f,  25.0f, 200.0f };
static const float FY[6] = { 35.0f,  35.0f, 175.0f, 172.0f, 305.0f, 307.0f };

// Ejes
#define X_STEP_PIN     18
#define X_DIR_PIN      19
#define X_ENDSTOP_PIN  13
#define X_ENDSTOP_ACTIVE_LOW 1

#define Y_STEP_PIN     23
#define Y_DIR_PIN      16
#define Y_ENDSTOP_PIN  32
#define Y_ENDSTOP_ACTIVE_LOW 1

// Pines de habilitación de drivers
#define X_ENABLE_PIN   21
#define Y_ENABLE_PIN   22
const bool ENABLE_ACTIVE_LOW = true;   // LOW = enable, HIGH = disable

// LED de análisis PWM
#define LED_ANALISIS_PIN    15

// BOMBA (P0 = GPIO0)
#define PUMP_PIN            0

// Límites
const float X_MAX_MM = 220.0f;
const float Y_MAX_MM = 320.0f;

// Mecánica
float X_STEPS_PER_MM = 40.0f;
float Y_STEPS_PER_MM = 50.0f;
int   X_SPEED_HZ = 10000;
int   X_ACCEL    = 20000;
int   Y_SPEED_HZ = 10000;
int   Y_ACCEL    = 20000;

// Homing
const bool  X_HOME_TOWARD_NEG = true;
const bool  Y_HOME_TOWARD_NEG = true;
const float X_HOME_BACKOFF_MM = 8.0f;
const float Y_HOME_BACKOFF_MM = 8.0f;
const int   X_HOME_FAST_HZ = 5000;
const int   X_HOME_SLOW_HZ = 1200;
const int   Y_HOME_FAST_HZ = 5000;
const int   Y_HOME_SLOW_HZ = 1200;

// Direcciones
const bool X_DIR_INVERTED = true;
const bool Y_DIR_INVERTED = false;

FastAccelStepperEngine engine;
FastAccelStepper* stepperX = nullptr;
FastAccelStepper* stepperY = nullptr;

/* ========================= RTOS Infra CNC + PID ========================= */
#define EV_X_HOMED     (1<<0)
#define EV_Y_HOMED     (1<<1)
#define EV_MOTION_BUSY (1<<2)

static EventGroupHandle_t eg;
static int motion_busy_depth = 0;   // nivel de anidación de secciones "busy"

inline long  mmToStepsX(float mm){ return lroundf(mm * X_STEPS_PER_MM); }
inline long  mmToStepsY(float mm){ return lroundf(mm * Y_STEPS_PER_MM); }
inline float stepsToMmX(long st) { return (float)st / X_STEPS_PER_MM; }
inline float stepsToMmY(long st) { return (float)st / Y_STEPS_PER_MM; }
inline float getXmm() { return stepsToMmX(stepperX->getCurrentPosition()); }
inline float getYmm() { return stepsToMmY(stepperY->getCurrentPosition()); }

inline bool endstopXPressed(){ int v=digitalRead(X_ENDSTOP_PIN); return X_ENDSTOP_ACTIVE_LOW ? (v==LOW):(v==HIGH); }
inline bool endstopYPressed(){ int v=digitalRead(Y_ENDSTOP_PIN); return Y_ENDSTOP_ACTIVE_LOW ? (v==LOW):(v==HIGH); }

/* ========= SOLO CONTROL PID CUANDO LA CNC ESTÁ EN HOME (0,0) EN MODO AUTO ========= */
bool isAtHomePos() {
  if (stepperX == nullptr || stepperY == nullptr || eg == nullptr) return false;

  EventBits_t b = xEventGroupGetBits(eg);
  if ((b & EV_X_HOMED) == 0 || (b & EV_Y_HOMED) == 0) return false;

  float x = getXmm();
  float y = getYmm();

  const float TOL = 0.5f; // tolerancia en mm
  bool atHome = (x > -TOL && x < TOL && y > -TOL && y < TOL);
  return atHome;
}

/* ===================== ISRs DIMMER ===================== */
void IRAM_ATTR onFireTimer() {
  static uint32_t last_fire = 0;
  uint32_t now = micros();
  if (now - last_fire < 2000) {
    timerStop(fireTimer);
    return;
  }
  last_fire = now;

  if (!gate_enable) {
    timerStop(fireTimer);
    return;
  }

  digitalWrite(PIN_DIM, HIGH);
  delayMicroseconds(GATE_PULSE_US);
  digitalWrite(PIN_DIM, LOW);
  timerStop(fireTimer);
}

void IRAM_ATTR isrZeroCross() {
  uint32_t now = micros();
  if (now - last_zc_us < ZC_BLANK_US) return;
  last_zc_us = now;

  if (!gate_enable) return;

  timerStop(fireTimer);
  timerWrite(fireTimer, 0);
  timerAlarm(fireTimer, u_delay_us, false, 0);
  timerStart(fireTimer);
}

/* ===================== TAREAS PID ===================== */
static uint8_t bad_count  = 0;
static uint8_t good_count = 0;
const uint8_t BAD_THRESHOLD  = 5;
const uint8_t GOOD_THRESHOLD = 3;

void applyEmergencyStop();   // forward
void clearEmergencyStop();   // forward

void taskSense(void* pv) {
  static bool prev_sensor_ok = true;

  for (;;) {
    double t_raw = ntc.temperature();
    t_raw_last = t_raw;

    uint8_t err_code = 0;
    if (isnan(t_raw)) {
      err_code = 1; // NaN
    } else if (t_raw <= TEMP_MIN_C) {
      err_code = 2; // muy bajo
    } else if (t_raw >= TEMP_MAX_C) {
      err_code = 3; // muy alto
    }

    bool ok_now = (err_code == 0);
    temp_error_code = err_code;

    // Histeresis
    if (!ok_now) {
      if (bad_count < 255) bad_count++;
      good_count = 0;
    } else {
      if (good_count < 255) good_count++;
      bad_count = 0;
    }

    if (bad_count >= BAD_THRESHOLD) {
      sensor_ok = false;
    } else if (good_count >= GOOD_THRESHOLD) {
      sensor_ok = true;
    }

    // Actualiza filtro solo con lecturas válidas
    if (sensor_ok && ok_now) {
      double t_filt = filter_temperature(t_raw);
      y_tempC = t_filt;
    }

    // Parada solo si el PID está armado (control crítico activo)
    if (sensor_ok != prev_sensor_ok) {
      if (!sensor_ok) {
        Serial.println("ERROR de sensor de temperatura.");
        if (pid_guard_armed) {
          Serial.println("PID armado -> Activando PARADA DE EMERGENCIA por sensor.");
          applyEmergencyStop();
        } else {
          Serial.println("PID NO armado (movimiento o idle). NO se activa emergencia por sensor.");
        }
      } else {
        Serial.println("Sensor de temperatura OK de nuevo.");
      }
      prev_sensor_ok = sensor_ok;
    }

    vTaskDelay(pdMS_TO_TICKS(150));
  }
}

void taskControl(void* pv) {
  TickType_t last = xTaskGetTickCount();
  const TickType_t period = pdMS_TO_TICKS(PID_SAMPLE_MS);

  for (;;) {
    vTaskDelayUntil(&last, period);

    // Por defecto, hasta comprobar condiciones, asumimos PID no armado
    pid_guard_armed = false;

    // MODO MANUAL: heater al porcentaje manual
    if (opMode == MODE_MANUAL) {
      if (safety_trip || !sensor_ok || emergency_stop) {
        gate_enable = false;
        if (myPID.GetMode() != MANUAL)
          myPID.SetMode(MANUAL);
        u_duty = 0.0;
        u_delay_us = HALF_CYCLE_US;
        continue;
      }

      if (myPID.GetMode() != MANUAL)
        myPID.SetMode(MANUAL);

      double h = constrain(heater_manual_pct, 0.0, 100.0);
      u_duty = h;  // telemetría

      if (h <= 0.0) {
        gate_enable = false;
        u_delay_us  = HALF_CYCLE_US;
      } else {
        gate_enable = true;
        u_delay_us  = dutyToDelayUs(h);
      }
    }
    // MODO AUTO: PID controla el heater, sólo en HOME
    else {
      bool atHome = isAtHomePos();

      // PID SOLO funciona en HOME y SIN emergencias / safety / error sensor
      if (safety_trip || !sensor_ok || !atHome || emergency_stop) {
        gate_enable = false;
        if (myPID.GetMode() == AUTOMATIC)
          myPID.SetMode(MANUAL);
        u_duty = 0.0;
        u_delay_us = HALF_CYCLE_US;
        pid_guard_armed = false;
        continue;
      }

      if (myPID.GetMode() == MANUAL) {
        myPID.SetMode(AUTOMATIC);
      }
      gate_enable     = true;
      pid_guard_armed = true;

      myPID.Compute();
      u_delay_us = dutyToDelayUs(u_duty);
    }
  }
}

void taskActuators(void* pv) {
  for (;;) {
    double fanPct;

    if (emergency_stop) {
      fanPct = 0.0;
    }
    else if (opMode == MODE_MANUAL) {
      fanPct = constrain(fan_manual_pct, 0.0, 100.0);
    }
    else if (safety_trip || !sensor_ok) {
      fanPct = FAN_MAX_PCT;
    } else {
      double heaterPct = u_duty;
      double fanTarget = heater_to_fan_inverse(heaterPct);
      fanPct = fan_smooth(fanTarget);
    }

    uint32_t duty_counts = (uint32_t)(fanPct * FAN_MAX / 100.0);
    ledcWrite(PIN_FAN_IN,  duty_counts);
    ledcWrite(PIN_FAN_OUT, duty_counts);

    fan_in_pct  = fanPct;
    fan_out_pct = fanPct;
    fan_pct_last = fanPct;

    vTaskDelay(pdMS_TO_TICKS(100));
  }
}

/* ========================= LED DE ANÁLISIS PWM ========================= */
static volatile uint8_t  led_pwm     = 0;
static volatile bool     led_on      = false;
static volatile uint16_t led_pwm_cnt = 0;
static hw_timer_t*       ledTimer    = nullptr;

void IRAM_ATTR ledTimerISR() {
  uint8_t duty = led_on ? led_pwm : 0;
  if (led_pwm_cnt < duty) GPIO.out_w1ts = (1UL << LED_ANALISIS_PIN);
  else                    GPIO.out_w1tc = (1UL << LED_ANALISIS_PIN);
  led_pwm_cnt++;
  if (led_pwm_cnt >= 256) led_pwm_cnt = 0;
}

void ledOn()    { led_on = true;  if (led_pwm == 0) led_pwm = 255; }
void ledOff()   { led_on = false; }
void ledSetPower(uint8_t p) {
  led_pwm = p;
  led_on  = (p > 0);
}

/* ========================= BOMBA ========================= */
volatile bool pump_state = false;  // estado para MQTT

inline void pumpOn()  { digitalWrite(PUMP_PIN, HIGH); pump_state = true;  }
inline void pumpOff() { digitalWrite(PUMP_PIN, LOW);  pump_state = false; }

/* ========================= HABILITACIÓN MOTORES ========================= */
static void motorsEnable(bool on){
  uint8_t lvl = ENABLE_ACTIVE_LOW
                ? (on ? LOW : HIGH)
                : (on ? HIGH : LOW);
  digitalWrite(X_ENABLE_PIN, lvl);
  digitalWrite(Y_ENABLE_PIN, lvl);
}

/* ========================= LIMITES Y HOMING ========================= */
static bool checkLimitX(float mmTarget){
  EventBits_t b = xEventGroupGetBits(eg);
  if (!(b & EV_X_HOMED)) return true;
  return (mmTarget >= 0.0f && mmTarget <= X_MAX_MM);
}
static bool checkLimitY(float mmTarget){
  EventBits_t b = xEventGroupGetBits(eg);
  if (!(b & EV_Y_HOMED)) return true;
  return (mmTarget >= 0.0f && mmTarget <= Y_MAX_MM);
}

// === APLICAR / LIBERAR PARADA DE EMERGENCIA ===
void applyEmergencyStop() {
  emergency_stop = true;
  safety_trip = true;
  pumpOff();
  ledOff();
  motorsEnable(false);
  gate_enable = false;
  u_duty = 0.0;
  u_delay_us = HALF_CYCLE_US;

  if (stepperX) stepperX->forceStop();
  if (stepperY) stepperY->forceStop();
}

void clearEmergencyStop() {
  emergency_stop = false;
  safety_trip = false;
}

static void waitStepper(FastAccelStepper* s){
  while (s->isRunning()) {
    if (emergency_stop) {
      s->forceStop();
      break;
    }
    vTaskDelay(pdMS_TO_TICKS(1));
  }
}

static bool doHomeAxis(FastAccelStepper* s,
                       bool (*endstopPressed)(),
                       bool homeTowardNeg,
                       float backoff_mm,
                       int fast_hz,
                       int slow_hz,
                       int speed_normal_hz,
                       int accel_normal,
                       float steps_per_mm)
{
  OUT_println("  - Búsqueda rápida...");
  s->setAcceleration(accel_normal);
  s->setSpeedInHz(fast_hz);

  long direction = homeTowardNeg ? -1 : 1;
  long maxSteps  = lroundf(1000.0f * steps_per_mm);
  s->move(direction * maxSteps);

  while (s->isRunning()){
    if (emergency_stop) { s->forceStop(); break; }
    if (endstopPressed()){ s->forceStopAndNewPosition(0); break; }
    vTaskDelay(1);
  }

  if (emergency_stop) {
    OUT_println("  ! Homing cancelado por emergencia");
    s->setSpeedInHz(speed_normal_hz);
    s->setAcceleration(accel_normal);
    return false;
  }

  if (!endstopPressed()){
    OUT_println("  ! Endstop no detectado");
    s->setSpeedInHz(speed_normal_hz);
    s->setAcceleration(accel_normal);
    return false;
  }

  OUT_println("  - Retroceso...");
  s->setSpeedInHz(slow_hz);
  s->move(-direction * lroundf(backoff_mm * steps_per_mm));
  waitStepper(s);
  vTaskDelay(pdMS_TO_TICKS(50));

  OUT_println("  - Aproximación lenta...");
  s->move(direction * lroundf(backoff_mm * 2.0f * steps_per_mm));
  while (s->isRunning()){
    if (emergency_stop) { s->forceStop(); break; }
    if (endstopPressed()){ s->forceStopAndNewPosition(0); break; }
    vTaskDelay(1);
  }

  if (emergency_stop) {
    OUT_println("  ! Homing cancelado por emergencia");
    s->setSpeedInHz(speed_normal_hz);
    s->setAcceleration(accel_normal);
    return false;
  }

  s->setCurrentPosition(0);
  s->setSpeedInHz(speed_normal_hz);
  s->setAcceleration(accel_normal);
  OUT_println("  OK: pos=0");
  return true;
}

static void preUnlatch(FastAccelStepper* s, bool homeTowardNeg, float steps_per_mm, float travel_mm){
  int  away_dir = homeTowardNeg ? +1 : -1;
  long st       = lroundf(travel_mm * steps_per_mm) * away_dir;
  if (st == 0) return;
  s->move(st);
  waitStepper(s);
  vTaskDelay(pdMS_TO_TICKS(30));
}

/* ========================= MOVIMIENTOS ========================= */
static bool moveToXYAbsSync(float x_mm, float y_mm){
  if (!checkLimitX(x_mm) || !checkLimitY(y_mm)){ OUT_println("  ! Limite excedido"); return false; }
  float curx = getXmm(), cury = getYmm();
  long dx = mmToStepsX(x_mm - curx);
  long dy = mmToStepsY(y_mm - cury);
  long adx = labs(dx), ady = labs(dy);
  if (adx==0 && ady==0) return true;

  int  baseSpeed = min(X_SPEED_HZ, Y_SPEED_HZ);
  int  baseAccel = min(X_ACCEL,    Y_ACCEL);
  long maxSteps  = max(adx, ady);
  auto scaled = [&](long a, int base)->int{
    if (a==0) return 0;
    long v = lround((double)base * (double)a / (double)maxSteps);
    if (v < 100) v = 100;
    return (int)v;
  };
  int vx = scaled(adx, baseSpeed), vy = scaled(ady, baseSpeed);
  int ax = scaled(adx, baseAccel), ay = scaled(ady, baseAccel);

  int old_vx = X_SPEED_HZ, old_ax = X_ACCEL;
  int old_vy = Y_SPEED_HZ, old_ay = Y_ACCEL;

  if (adx>0){ stepperX->setSpeedInHz(vx); stepperX->setAcceleration(ax); }
  if (ady>0){ stepperY->setSpeedInHz(vy); stepperY->setAcceleration(ay); }

  if (adx>0) stepperX->move(dx);
  if (ady>0) stepperY->move(dy);

  while ((adx>0 && stepperX->isRunning()) || (ady>0 && stepperY->isRunning())){
    if (emergency_stop) {
      if (stepperX) stepperX->forceStop();
      if (stepperY) stepperY->forceStop();
      OUT_println("  ! Movimiento cancelado por emergencia");
      break;
    }
    vTaskDelay(1);
  }

  stepperX->setSpeedInHz(old_vx); stepperX->setAcceleration(old_ax);
  stepperY->setSpeedInHz(old_vy); stepperY->setAcceleration(old_ay);
  return !emergency_stop;
}

static bool moveRelX(float mm){
  float dest = getXmm() + mm;
  if (!checkLimitX(dest)) return false;
  stepperX->move(mmToStepsX(mm));
  waitStepper(stepperX);
  return !emergency_stop;
}
static bool moveRelY(float mm){
  float dest = getYmm() + mm;
  if (!checkLimitY(dest)) return false;
  stepperY->move(mmToStepsY(mm));
  waitStepper(stepperY);
  return !emergency_stop;
}

/* ========================= TAREAS INTERFAZ & MOVIMIENTO ========================= */
typedef enum : uint8_t {
  CMD_HELP,
  CMD_ANALISIS,
  CMD_FUMIGADO,
  CMD_HOME_X, CMD_HOME_Y, CMD_HOME_BOTH,
  CMD_G0X, CMD_G0Y, CMD_G0XY,
  CMD_P1, CMD_P2, CMD_P3, CMD_P4, CMD_P5, CMD_P6,
  CMD_REL_MMX, CMD_REL_MMY,
  CMD_POSQ,
  CMD_LED_ON, CMD_LED_OFF, CMD_LED_Q,
  CMD_LED_POWER,
  CMD_ESTOP,
  CMD_ESTOP_CLEAR,
  // MODOS
  CMD_MODE_AUTO,
  CMD_MODE_MANUAL,
  // CONTROL MANUAL HEATER / FAN / PUMP
  CMD_HEATER_SET,
  CMD_HEATER_Q,
  CMD_FAN_SET,
  CMD_FAN_Q,
  CMD_PUMP_ON,
  CMD_PUMP_OFF,
  CMD_PUMP_Q,
  // PID
  CMD_PID_KP,
  CMD_PID_KI,
  CMD_PID_KD,
  CMD_PID_SP_ABS,
  CMD_PID_SP_INC,
  CMD_PID_SP_DEC,
  CMD_PID_SHOW,
  CMD_PID_SENS,
  CMD_PID_SAFE_ON,
  CMD_PID_SAFE_OFF
} CmdType;

typedef struct {
  CmdType type;
  float   value;
} Command;

static QueueHandle_t qCmd;
static TaskHandle_t hUI   = nullptr;
static TaskHandle_t hUtil = nullptr;
static TaskHandle_t hMotion = nullptr;
static TaskHandle_t hAutoAnalisis = nullptr;
static TaskHandle_t hAutoFumigado = nullptr;
static TaskHandle_t hMqtt = nullptr;

static String cmdBuf;

/* --- Busy + habilitación drivers con contador anidado --- */
static void setBusy(bool on){
  if (on) {
    if (motion_busy_depth == 0) {
      motorsEnable(true);
      xEventGroupSetBits(eg, EV_MOTION_BUSY);
    }
    motion_busy_depth++;
  } else {
    if (motion_busy_depth > 0) {
      motion_busy_depth--;
      if (motion_busy_depth == 0) {
        motorsEnable(false);
        xEventGroupClearBits(eg, EV_MOTION_BUSY);
      }
    }
  }
}

static void uiSend(CmdType t, float v=0){
  Command c{t, v};
  xQueueSend(qCmd, &c, portMAX_DELAY);
}

/* --- Parser ÚNICO --- */
static void parseLineAndDispatch(const String& sIn){
  String s = sIn; s.trim(); s.toLowerCase();
  if (!s.length()) return;

  if (s=="help" || s=="?") {
    OUT_println("\nComandos PID:");
    OUT_println("  kp <v>, ki <v>, kd <v>");
    OUT_println("  sp <v>, sp+ <d>, sp- <d>");
    OUT_println("  show, sens, safe on, safe off");
    OUT_println("\nComandos MODO:");
    OUT_println("  modo auto");
    OUT_println("  modo manual");
    OUT_println("\nComandos MOTORES + LED + BOMBA:");
    OUT_println("  analisis");
    OUT_println("  fumigado");
    OUT_println("  p1..p6");
    OUT_println("  home | homex | homey");
    OUT_println("  g0   | g0x   | g0y");
    OUT_println("  mmx=<n> | mmy=<n>");
    OUT_println("  pos?");
    OUT_println("  ledon | ledoff | led? | ledp=<0-255>");
    OUT_println("  pump on | pump off | pump?");
    OUT_println("\nComandos MANUAL (sólo en modo MANUAL):");
    OUT_println("  heater=<0-100> | heater?");
    OUT_println("  fan=<0-100>    | fan?");
    OUT_println("\nSeguridad:");
    OUT_println("  parada  (parada de emergencia)");
    OUT_println("  seguir  (libera parada de emergencia)\n");
    return;
  }

  // PID
  if      (s.startsWith("kp ")) uiSend(CMD_PID_KP, s.substring(3).toFloat());
  else if (s.startsWith("ki ")) uiSend(CMD_PID_KI, s.substring(3).toFloat());
  else if (s.startsWith("kd ")) uiSend(CMD_PID_KD, s.substring(3).toFloat());
  else if (s.startsWith("sp+ ")) uiSend(CMD_PID_SP_INC, s.substring(4).toFloat());
  else if (s.startsWith("sp- ")) uiSend(CMD_PID_SP_DEC, s.substring(4).toFloat());
  else if (s.startsWith("sp "))  uiSend(CMD_PID_SP_ABS, s.substring(3).toFloat());
  else if (s=="show")    uiSend(CMD_PID_SHOW);
  else if (s=="sens")    uiSend(CMD_PID_SENS);
  else if (s=="safe on") uiSend(CMD_PID_SAFE_ON);
  else if (s=="safe off")uiSend(CMD_PID_SAFE_OFF);

  // MODOS
  else if (s=="modo auto")   uiSend(CMD_MODE_AUTO);
  else if (s=="modo manual") uiSend(CMD_MODE_MANUAL);

  // MANUAL HEATER/FAN/PUMP
  else if (s.startsWith("heater=")) uiSend(CMD_HEATER_SET, s.substring(7).toFloat());
  else if (s=="heater?")            uiSend(CMD_HEATER_Q);
  else if (s.startsWith("fan="))    uiSend(CMD_FAN_SET, s.substring(4).toFloat());
  else if (s=="fan?")               uiSend(CMD_FAN_Q);
  else if (s=="pump on")            uiSend(CMD_PUMP_ON);
  else if (s=="pump off")           uiSend(CMD_PUMP_OFF);
  else if (s=="pump?")              uiSend(CMD_PUMP_Q);

  // MOTORES + LED + EMERGENCIA
  else if (s=="analisis")  uiSend(CMD_ANALISIS);
  else if (s=="fumigado")  uiSend(CMD_FUMIGADO);
  else if (s=="homex")     uiSend(CMD_HOME_X);
  else if (s=="homey")     uiSend(CMD_HOME_Y);
  else if (s=="home")      uiSend(CMD_HOME_BOTH);
  else if (s=="g0x")       uiSend(CMD_G0X);
  else if (s=="g0y")       uiSend(CMD_G0Y);
  else if (s=="g0")        uiSend(CMD_G0XY);
  else if (s=="p1")        uiSend(CMD_P1);
  else if (s=="p2")        uiSend(CMD_P2);
  else if (s=="p3")        uiSend(CMD_P3);
  else if (s=="p4")        uiSend(CMD_P4);
  else if (s=="p5")        uiSend(CMD_P5);
  else if (s=="p6")        uiSend(CMD_P6);
  else if (s=="pos?")      uiSend(CMD_POSQ);
  else if (s=="ledon")     uiSend(CMD_LED_ON);
  else if (s=="ledoff")    uiSend(CMD_LED_OFF);
  else if (s=="led?")      uiSend(CMD_LED_Q);
  else if (s=="parada") {
    applyEmergencyStop();
    uiSend(CMD_ESTOP);
  }
  else if (s=="seguir") {
    clearEmergencyStop();
    uiSend(CMD_ESTOP_CLEAR);
  }
  else if (s.startsWith("ledp=")) uiSend(CMD_LED_POWER, s.substring(5).toFloat());
  else if (s.startsWith("mmx="))  uiSend(CMD_REL_MMX,   s.substring(4).toFloat());
  else if (s.startsWith("mmy="))  uiSend(CMD_REL_MMY,   s.substring(4).toFloat());
  else OUT_println("Comando invalido. Escribe 'help'.");
}

static void handleStream(Stream& in, String& buf) {
  while (in.available()){
    char c = in.read();
    if (c=='\r' || c=='\n'){
      String line = buf; buf = "";
      parseLineAndDispatch(line);
    } else {
      buf += c;
    }
  }
}

static void vTaskUI(void*){
  OUT_println("ESP32 listo. Usa 'help' para ver comandos (AUTO/MANUAL, PID, MOTORES, LED, BOMBA).");
  for(;;){
    handleStream(Serial, cmdBuf);
    vTaskDelay(pdMS_TO_TICKS(5));
  }
}

static void vTaskUtil(void*){
  TickType_t last = xTaskGetTickCount();
  for(;;){
    vTaskDelayUntil(&last, pdMS_TO_TICKS(250));
  }
}

/* --- Motion / Planner --- */
static void homeX(){
  setBusy(true);
  OUT_println("\n=== HOMING X ===");
  preUnlatch(stepperX, X_HOME_TOWARD_NEG, X_STEPS_PER_MM, 5.0f);
  bool ok = doHomeAxis(stepperX, endstopXPressed, X_HOME_TOWARD_NEG,
                       X_HOME_BACKOFF_MM, X_HOME_FAST_HZ, X_HOME_SLOW_HZ,
                       X_SPEED_HZ, X_ACCEL, X_STEPS_PER_MM);
  if (ok) xEventGroupSetBits(eg, EV_X_HOMED); else xEventGroupClearBits(eg, EV_X_HOMED);
  setBusy(false);
}
static void homeY(){
  setBusy(true);
  OUT_println("\n=== HOMING Y ===");
  preUnlatch(stepperY, Y_HOME_TOWARD_NEG, Y_STEPS_PER_MM, 5.0f);
  bool ok = doHomeAxis(stepperY, endstopYPressed, Y_HOME_TOWARD_NEG,
                       Y_HOME_BACKOFF_MM, Y_HOME_FAST_HZ, Y_HOME_SLOW_HZ,
                       Y_SPEED_HZ, Y_ACCEL, Y_STEPS_PER_MM);
  if (ok) xEventGroupSetBits(eg, EV_Y_HOMED); else xEventGroupClearBits(eg, EV_Y_HOMED);
  setBusy(false);
}

static void go0X(){ setBusy(true); (void)moveToXYAbsSync(0.0f, getYmm()); setBusy(false); OUT_println("OK X=0"); }
static void go0Y(){ setBusy(true); (void)moveToXYAbsSync(getXmm(), 0.0f); setBusy(false); OUT_println("OK Y=0"); }

/* ========================= ANALISIS (SIN BOMBA) ========================= */
static void doAnalisis(){
  setBusy(true);
  OUT_println("\n=== ANALISIS ===");

  if (emergency_stop) {
    OUT_println("! Emergencia activa. Analisis cancelado.");
    setBusy(false);
    return;
  }

  ledOn();

  homeX();
  homeY();
  EventBits_t b = xEventGroupGetBits(eg);
  if (!(b & EV_X_HOMED) || !(b & EV_Y_HOMED)){
    OUT_println("! Homing falló. Aborto.");
    ledOff();
    setBusy(false);
    return;
  }

  for (uint8_t i=0;i<6 && !emergency_stop;i++){
    char msg[64];
    snprintf(msg, sizeof(msg), "→ ANALISIS P%d = (%.1f, %.1f)", i+1, PX[i], PY[i]);
    OUT_println(msg);

    if (!moveToXYAbsSync(PX[i], PY[i])){
      OUT_println("  ! Límite o emergencia; Analisis abortado");
      break;
    }

    const uint32_t wait_ms = 3000;
    for (uint32_t t=0; t<wait_ms && !emergency_stop; t+=50){
      vTaskDelay(pdMS_TO_TICKS(50));
    }
  }

  if (!emergency_stop) {
    OUT_println("Regresando a HOME (0,0)...");
    (void)moveToXYAbsSync(0.0f, 0.0f);
    OUT_println("ANALISIS listo. Posición HOME (0,0).");
  } else {
    OUT_println("Analisis interrumpido por parada de emergencia.");
  }

  ledOff();
  setBusy(false);
}

/* ========================= FUMIGADO (CON BOMBA 0.5 s POR PUNTO) ========================= */
static void doFumigado(){
  setBusy(true);
  OUT_println("\n=== FUMIGADO ===");

  if (emergency_stop) {
    OUT_println("! Emergencia activa. Fumigado cancelado.");
    setBusy(false);
    return;
  }

  pumpOff();
  ledOn();

  homeX();
  homeY();
  EventBits_t b = xEventGroupGetBits(eg);
  if (!(b & EV_X_HOMED) || !(b & EV_Y_HOMED)){
    OUT_println("! Homing falló. Aborto.");
    ledOff();
    pumpOff();
    setBusy(false);
    return;
  }

  for (uint8_t i=0;i<6 && !emergency_stop;i++){
    char msg[64];
    snprintf(msg, sizeof(msg), "→ FUMIGADO P%d = (%.1f, %.1f)", i+1, FX[i], FY[i]);
    OUT_println(msg);

    pumpOff();

    if (!moveToXYAbsSync(FX[i], FY[i])){
      OUT_println("  ! Límite o emergencia; Fumigado abortado");
      pumpOff();
      break;
    }

    if (emergency_stop) break;

    pumpOn();
    const uint32_t wait_ms = 500;
    for (uint32_t t=0; t<wait_ms && !emergency_stop; t+=50){
      vTaskDelay(pdMS_TO_TICKS(50));
    }
    pumpOff();
  }

  if (!emergency_stop) {
    OUT_println("Regresando a HOME (0,0)...");
    (void)moveToXYAbsSync(0.0f, 0.0f);
    OUT_println("FUMIGADO listo. Posición HOME (0,0).");
  } else {
    OUT_println("Fumigado interrumpido por parada de emergencia.");
  }

  ledOff();
  pumpOff();
  setBusy(false);
}

static void gotoPoint(uint8_t idx){
  if (idx<1 || idx>6) return;
  EventBits_t b = xEventGroupGetBits(eg);
  if (!(b & EV_X_HOMED) || !(b & EV_Y_HOMED)) { homeX(); homeY(); }
  if (emergency_stop) {
    OUT_println("! Emergencia activa. Movimiento cancelado.");
    return;
  }
  char msg[32]; snprintf(msg, sizeof(msg), "→ Ir a P%u", idx); OUT_println(msg);
  setBusy(true);
  (void)moveToXYAbsSync(PX[idx-1], PY[idx-1]);
  setBusy(false);
  OUT_println("OK punto.");
}

static void vTaskMotion(void*){
  Command c;
  for(;;){
    if (xQueueReceive(qCmd, &c, portMAX_DELAY) == pdTRUE){

      if (emergency_stop &&
          c.type != CMD_ESTOP_CLEAR &&
          c.type != CMD_ESTOP &&
          c.type != CMD_PID_SHOW &&
          c.type != CMD_PID_SENS &&
          c.type != CMD_HELP &&
          c.type != CMD_MODE_AUTO &&
          c.type != CMD_MODE_MANUAL) {
        OUT_println("Parada de emergencia activa. Usa 'seguir' para reanudar.");
        continue;
      }

      switch(c.type){
        case CMD_HELP:
          OUT_println("\nComandos PID:");
          OUT_println("  kp <v>, ki <v>, kd <v>");
          OUT_println("  sp <v>, sp+ <d>, sp- <d>");
          OUT_println("  show, sens, safe on, safe off");
          OUT_println("\nComandos MODO:");
          OUT_println("  modo auto");
          OUT_println("  modo manual");
          OUT_println("\nComandos MOTORES + LED + BOMBA:");
          OUT_println("  analisis");
          OUT_println("  fumigado");
          OUT_println("  p1..p6");
          OUT_println("  home | homex | homey");
          OUT_println("  g0   | g0x   | g0y");
          OUT_println("  mmx=<n> | mmy=<n>");
          OUT_println("  pos?");
          OUT_println("  ledon | ledoff | led? | ledp=<0-255>");
          OUT_println("  pump on | pump off | pump?");
          OUT_println("\nComandos MANUAL (sólo en modo MANUAL):");
          OUT_println("  heater=<0-100> | heater?");
          OUT_println("  fan=<0-100>    | fan?");
          OUT_println("\nSeguridad:");
          OUT_println("  parada  (parada de emergencia)");
          OUT_println("  seguir  (libera parada de emergencia)\n");
          break;

        case CMD_LED_ON:     ledOn();  OUT_println("LED análisis ON"); break;
        case CMD_LED_OFF:    ledOff(); OUT_println("LED análisis OFF"); break;
        case CMD_LED_Q: {
          char msg[32];
          snprintf(msg,sizeof(msg),"LED: %s PWM=%u", led_on?"ON":"OFF", led_pwm);
          OUT_println(msg);
        } break;
        case CMD_LED_POWER: {
          uint8_t p = (uint8_t)c.value;
          ledSetPower(p);
          char msg[32]; snprintf(msg,sizeof(msg),"LED PWM = %u", p);
          OUT_println(msg);
        } break;

        case CMD_HOME_X:     homeX(); break;
        case CMD_HOME_Y:     homeY(); break;
        case CMD_HOME_BOTH:  homeX(); homeY(); break;

        case CMD_G0X:        go0X(); break;
        case CMD_G0Y:        go0Y(); break;
        case CMD_G0XY:       setBusy(true); (void)moveToXYAbsSync(0,0); setBusy(false); OUT_println("OK X=0,Y=0"); break;

        case CMD_P1: case CMD_P2: case CMD_P3:
        case CMD_P4: case CMD_P5: case CMD_P6:
          gotoPoint((uint8_t)(c.type - CMD_P1 + 1)); break;

        case CMD_REL_MMX:
          setBusy(true); if (!moveRelX(c.value)) OUT_println("! Limite X o emergencia"); setBusy(false); break;
        case CMD_REL_MMY:
          setBusy(true); if (!moveRelY(c.value)) OUT_println("! Limite Y o emergencia"); setBusy(false); break;

        case CMD_POSQ: {
          char msg[80];
          snprintf(msg, sizeof(msg), "X: %.2f mm | Y: %.2f mm", getXmm(), getYmm());
          OUT_println(msg);
        } break;

        case CMD_ANALISIS:
          if (opMode == MODE_MANUAL) {
            OUT_println("Analisis deshabilitado en modo MANUAL.");
          } else {
            doAnalisis();
          }
          break;

        case CMD_FUMIGADO:
          if (opMode == MODE_MANUAL) {
            OUT_println("Fumigado deshabilitado en modo MANUAL.");
          } else {
            doFumigado();
          }
          break;

        case CMD_ESTOP:
          OUT_println("PARADA DE EMERGENCIA ACTIVADA. Todo apagado.");
          break;
        case CMD_ESTOP_CLEAR:
          clearEmergencyStop();
          OUT_println("Parada de emergencia desactivada. Puedes continuar.");
          break;

        // MODOS
        case CMD_MODE_AUTO:
          opMode = MODE_AUTO;
          myPID.SetMode(AUTOMATIC);
          heater_manual_pct = 0.0;
          fan_manual_pct    = 0.0;
          OUT_println("Modo AUTOMATICO activado.");
          break;

        case CMD_MODE_MANUAL:
          opMode = MODE_MANUAL;
          myPID.SetMode(MANUAL);
          gate_enable = false;
          u_duty      = 0.0;
          u_delay_us  = HALF_CYCLE_US;
          heater_manual_pct = 0.0;
          fan_manual_pct    = 0.0;
          ledOff();
          pumpOff();
          OUT_println("Modo MANUAL (mantenimiento) activado.");
          break;

        // MANUAL HEATER
        case CMD_HEATER_SET:
          if (opMode != MODE_MANUAL) {
            OUT_println("Heater manual solo disponible en modo MANUAL.");
            break;
          }
          heater_manual_pct = constrain(c.value, 0.0f, 100.0f);
          Serial.printf("Heater manual = %.1f %%\n", heater_manual_pct);
          break;

        case CMD_HEATER_Q:
          Serial.printf("Modo: %s | Heater: %.1f %% (manual %s)\n",
                        opMode == MODE_AUTO ? "AUTO" : "MANUAL",
                        (opMode == MODE_MANUAL ? heater_manual_pct : u_duty),
                        opMode == MODE_MANUAL ? "ON" : "OFF");
          break;

        // MANUAL FAN
        case CMD_FAN_SET:
          if (opMode != MODE_MANUAL) {
            OUT_println("Fan manual solo disponible en modo MANUAL.");
            break;
          }
          fan_manual_pct = constrain(c.value, 0.0f, 100.0f);
          Serial.printf("Fan manual = %.1f %%\n", fan_manual_pct);
          break;

        case CMD_FAN_Q:
          Serial.printf("Modo: %s | Fan: %.1f %% (manual %s)\n",
                        opMode == MODE_AUTO ? "AUTO" : "MANUAL",
                        fan_pct_last,
                        opMode == MODE_MANUAL ? "ON" : "OFF");
          break;

        // MANUAL PUMP
        case CMD_PUMP_ON:
          if (opMode != MODE_MANUAL) {
            OUT_println("Bomba manual solo disponible en modo MANUAL.");
            break;
          }
          pumpOn();
          OUT_println("Bomba ON (manual).");
          break;

        case CMD_PUMP_OFF:
          if (opMode != MODE_MANUAL) {
            OUT_println("Bomba manual solo disponible en modo MANUAL.");
            break;
          }
          pumpOff();
          OUT_println("Bomba OFF (manual).");
          break;

        case CMD_PUMP_Q:
          Serial.printf("Bomba: %s | Modo: %s\n",
                        pump_state ? "ON" : "OFF",
                        opMode == MODE_AUTO ? "AUTO" : "MANUAL");
          break;

        // PID
        case CMD_PID_KP:
          Kp = c.value;
          myPID.SetTunings(Kp, Ki, Kd);
          Serial.print("Nuevo Kp = "); Serial.println(Kp, 4);
          break;
        case CMD_PID_KI:
          Ki = c.value;
          myPID.SetTunings(Kp, Ki, Kd);
          Serial.print("Nuevo Ki = "); Serial.println(Ki, 4);
          break;
        case CMD_PID_KD:
          Kd = c.value;
          myPID.SetTunings(Kp, Ki, Kd);
          Serial.print("Nuevo Kd = "); Serial.println(Kd, 4);
          break;
        case CMD_PID_SP_ABS:
          SETPOINT_C = clampSP(c.value);
          Serial.print("Nuevo SP = "); Serial.print(SETPOINT_C, 2); Serial.println(" °C");
          break;
        case CMD_PID_SP_INC:
          SETPOINT_C = clampSP(SETPOINT_C + c.value);
          Serial.print("SP aumentado: "); Serial.print(SETPOINT_C, 2); Serial.println(" °C");
          break;
        case CMD_PID_SP_DEC:
          SETPOINT_C = clampSP(SETPOINT_C - c.value);
          Serial.print("SP reducido: "); Serial.print(SETPOINT_C, 2); Serial.println(" °C");
          break;
        case CMD_PID_SHOW:
          Serial.printf("Modo=%s | PID: Kp=%.4f  Ki=%.4f  Kd=%.4f | SP=%.2f °C | T=%.2f °C | U=%.2f%% | gate=%d | emerg=%d\n",
                        opMode == MODE_AUTO ? "AUTO" : "MANUAL",
                        Kp, Ki, Kd, SETPOINT_C, y_tempC, u_duty, (int)gate_enable, emergency_stop ? 1 : 0);
          break;
        case CMD_PID_SENS:
          Serial.printf("T_raw=%.2f  T_filt=%.2f  ok=%d  err_code=%u\n",
                        t_raw_last, y_tempC, sensor_ok ? 1 : 0, temp_error_code);
          break;
        case CMD_PID_SAFE_ON:
          safety_trip = true;
          Serial.println("Safety TRIP activado.");
          break;
        case CMD_PID_SAFE_OFF:
          safety_trip = false;
          Serial.println("Safety TRIP liberado.");
          break;
      }
    }
  }
}

/* ========================= PERIODOS AUTO (EDITABLES POR MQTT) ========================= */

// Valores por defecto
volatile uint32_t analisis_period_ms = 60UL * 60UL * 1000UL;   // 60 min
volatile uint32_t fumigado_period_ms = 10UL * 60UL * 1000UL;   // 10 min

// Contadores de tiempo transcurrido (se actualizan cada 1 s)
volatile uint32_t analisis_elapsed_ms  = 0;
volatile uint32_t fumigado_elapsed_ms  = 0;

/* ========================= ANALISIS AUTOMÁTICO ========================= */
// Ahora se cuenta tiempo en pasos de 1 s, y se respeta el nuevo periodo
// desde el momento en que se cambia por MQTT (porque se resetea elapsed).
static void vTaskAutoAnalisis(void*){
  TickType_t last = xTaskGetTickCount();
  const uint32_t STEP_MS = 1000;  // resolución 1 s

  for(;;){
    vTaskDelayUntil(&last, pdMS_TO_TICKS(STEP_MS));

    // No contamos tiempo si hay emergencia o no estamos en AUTO
    if (emergency_stop || opMode != MODE_AUTO) {
      continue;
    }

    // No lanzamos análisis mientras se mueven los motores
    if (xEventGroupGetBits(eg) & EV_MOTION_BUSY) {
      continue;
    }

    // Periodo actual (con mínimo de 1 min)
    uint32_t p_ms = analisis_period_ms;
    if (p_ms < 60000UL) p_ms = 60000UL;

    // Actualizamos tiempo transcurrido desde el último disparo o cambio
    analisis_elapsed_ms += STEP_MS;

    if (analisis_elapsed_ms >= p_ms) {
      analisis_elapsed_ms = 0;
      uiSend(CMD_ANALISIS);
    }
  }
}

/* ========================= FUMIGADO AUTOMÁTICO ========================= */
static void vTaskAutoFumigado(void*){
  TickType_t last = xTaskGetTickCount();
  const uint32_t STEP_MS = 1000;  // resolución 1 s

  for(;;){
    vTaskDelayUntil(&last, pdMS_TO_TICKS(STEP_MS));

    if (emergency_stop || opMode != MODE_AUTO) {
      continue;
    }

    if (xEventGroupGetBits(eg) & EV_MOTION_BUSY) {
      continue;
    }

    uint32_t p_ms = fumigado_period_ms;
    if (p_ms < 60000UL) p_ms = 60000UL;

    fumigado_elapsed_ms += STEP_MS;

    if (fumigado_elapsed_ms >= p_ms) {
      fumigado_elapsed_ms = 0;
      uiSend(CMD_FUMIGADO);
    }
  }
}

/* ========================= WIFI + MQTT ========================= */

void setupWiFi() {
  delay(10);
  Serial.println();
  Serial.print("Conectando a WiFi: ");
  Serial.println(WIFI_SSID);

  WiFi.mode(WIFI_STA);
  WiFi.begin(WIFI_SSID, WIFI_PASSWORD);

  while (WiFi.status() != WL_CONNECTED) {
    delay(500);
    Serial.print(".");
  }
  Serial.println("\nWiFi conectado.");
  Serial.print("IP: ");
  Serial.println(WiFi.localIP());
}

void mqttCallback(char* topic, byte* payload, unsigned int length) {
  String msg;
  for (unsigned int i = 0; i < length; i++) {
    msg += (char)payload[i];
  }
  msg.trim();

  String t = String(topic);
  Serial.print("MQTT mensaje en ");
  Serial.print(t);
  Serial.print(": ");
  Serial.println(msg);

  if (t == MQTT_TOPIC_CMD_ANALISIS) {
    uiSend(CMD_ANALISIS);
  }
  else if (t == MQTT_TOPIC_CMD_SP) {
    double sp = msg.toFloat();
    uiSend(CMD_PID_SP_ABS, (float)sp);
  }
  else if (t == MQTT_TOPIC_CMD_SAFE) {
    msg.toLowerCase();
    if (msg == "on" || msg == "1" || msg == "true") {
      uiSend(CMD_PID_SAFE_ON);
    } else if (msg == "off" || msg == "0" || msg == "false") {
      uiSend(CMD_PID_SAFE_OFF);
    }
  }
  else if (t == MQTT_TOPIC_CMD_RAW) {
    parseLineAndDispatch(msg);
  }
  else if (t == MQTT_TOPIC_CMD_MODE) {
    msg.toLowerCase();
    if (msg == "auto") {
      uiSend(CMD_MODE_AUTO);
    } else if (msg == "manual") {
      uiSend(CMD_MODE_MANUAL);
    }
  }
  // Cambiar periodo de ANÁLISIS (minutos) y reiniciar el conteo desde el cambio
  else if (t == MQTT_TOPIC_CMD_ANALISIS_PERIOD) {
    double mins = msg.toFloat();
    if (mins < 1.0) mins = 1.0;       // mínimo 1 min
    if (mins > 1440.0) mins = 1440.0; // máximo 1 día
    analisis_period_ms  = (uint32_t)(mins * 60.0 * 1000.0);
    analisis_elapsed_ms = 0;          // <-- empieza a contar desde el cambio
    Serial.printf("Nuevo periodo ANALISIS = %.2f min\n", mins);
  }
  // Cambiar periodo de FUMIGADO (minutos) y reiniciar el conteo desde el cambio
  else if (t == MQTT_TOPIC_CMD_FUMIGADO_PERIOD) {
    double mins = msg.toFloat();
    if (mins < 1.0) mins = 1.0;
    if (mins > 1440.0) mins = 1440.0;
    fumigado_period_ms  = (uint32_t)(mins * 60.0 * 1000.0);
    fumigado_elapsed_ms = 0;          // <-- empieza a contar desde el cambio
    Serial.printf("Nuevo periodo FUMIGADO = %.2f min\n", mins);
  }
}

void reconnectMqtt() {
  while (!mqttClient.connected()) {
    Serial.print("Intentando conectar a MQTT...");
    String clientId = "ESP32CNC-";
    clientId += String(random(0xffff), HEX);

    if (mqttClient.connect(clientId.c_str(), MQTT_USER, MQTT_PASS)) {
      Serial.println(" conectado.");
      mqttClient.subscribe(MQTT_TOPIC_CMD_ANALISIS);
      mqttClient.subscribe(MQTT_TOPIC_CMD_SP);
      mqttClient.subscribe(MQTT_TOPIC_CMD_SAFE);
      mqttClient.subscribe(MQTT_TOPIC_CMD_RAW);
      mqttClient.subscribe(MQTT_TOPIC_CMD_MODE);
      mqttClient.subscribe(MQTT_TOPIC_CMD_ANALISIS_PERIOD);
      mqttClient.subscribe(MQTT_TOPIC_CMD_FUMIGADO_PERIOD);
    } else {
      Serial.print(" fallo, rc=");
      Serial.print(mqttClient.state());
      Serial.println(" reintentando en 5s");
      vTaskDelay(pdMS_TO_TICKS(5000));
    }
  }
}

static void publishFloat(const char* topic, double value, uint8_t decimals = 2) {
  char buf[32];
  dtostrf(value, 0, decimals, buf);
  mqttClient.publish(topic, buf, true);  // retained
}

static void publishBool(const char* topic, bool value) {
  mqttClient.publish(topic, value ? "1" : "0", true);
}

static void vTaskMqtt(void* pv) {
  (void)pv;
  for (;;) {
    if (!mqttClient.connected()) {
      reconnectMqtt();
    }
    mqttClient.loop();

    static uint32_t lastPub = 0;
    uint32_t now = millis();
    if (now - lastPub >= 2000) {  // cada 2 s
      lastPub = now;

      publishFloat(MQTT_TOPIC_TEMP,     y_tempC);
      publishFloat(MQTT_TOPIC_SETPOINT, SETPOINT_C);
      publishFloat(MQTT_TOPIC_HEATER,   u_duty);
      publishFloat(MQTT_TOPIC_FAN,      fan_pct_last);
      publishBool (MQTT_TOPIC_PUMP,     pump_state);
      publishFloat(MQTT_TOPIC_POSX,     getXmm(), 2);
      publishFloat(MQTT_TOPIC_POSY,     getYmm(), 2);

      // Periodos actuales en minutos
      double anal_min = (double)analisis_period_ms / 60000.0;
      double fum_min  = (double)fumigado_period_ms / 60000.0;
      publishFloat(MQTT_TOPIC_ANALISIS_PERIOD, anal_min, 2);
      publishFloat(MQTT_TOPIC_FUMIGADO_PERIOD, fum_min, 2);

      // ESTADO DEL SENSOR DE TEMPERATURA (inteligente según contexto)
      EventBits_t bits = xEventGroupGetBits(eg);
      bool motion_busy = bits & EV_MOTION_BUSY;

      const char* sensor_msg = "ok";

      if (motion_busy) {
        // CNC en movimiento: ignoramos errores, reportamos "okoc"
        sensor_msg = "okoc";
      } else if (pid_guard_armed) {
        // PID armado: reportamos estado real del sensor
        switch (temp_error_code) {
          case 0: sensor_msg = "ok"; break;
          case 1: sensor_msg = "nan"; break;
          case 2: sensor_msg = "out_of_range_low"; break;
          case 3: sensor_msg = "out_of_range_high"; break;
          default: sensor_msg = "ok"; break;
        }
      } else {
        // Sin movimiento y PID no armado: equipo en reposo
        sensor_msg = "okidle";
      }

      mqttClient.publish(MQTT_TOPIC_TEMP_SENSOR, sensor_msg, true);

      char safetyBuf[64];
      snprintf(safetyBuf, sizeof(safetyBuf), "trip=%d,sens=%d,emerg=%d,mode=%s",
               safety_trip ? 1 : 0,
               sensor_ok   ? 1 : 0,
               emergency_stop ? 1 : 0,
               opMode == MODE_AUTO ? "A" : "M");
      mqttClient.publish(MQTT_TOPIC_SAFETY, safetyBuf, true);
    }

    vTaskDelay(pdMS_TO_TICKS(100));
  }
}

/* ========================= SETUP ========================= */
void setup() {
  Serial.begin(115200);
  delay(200);

  randomSeed(micros());

  // ADC NTC
  analogReadResolution(12);
  analogSetAttenuation(ADC_11db);

  // PWM FANS
  ledcAttach(PIN_FAN_IN,  FAN_PWM_HZ, FAN_PWM_BITS);
  ledcAttach(PIN_FAN_OUT, FAN_PWM_HZ, FAN_PWM_BITS);
  ledcWrite(PIN_FAN_IN,  0);
  ledcWrite(PIN_FAN_OUT, 0);

  // Dimmer / ZC
  pinMode(PIN_DIM, OUTPUT);
  digitalWrite(PIN_DIM, LOW);
  pinMode(PIN_ZC, INPUT_PULLUP);

  fireTimer = timerBegin(1000000); // 1 MHz
  timerAttachInterrupt(fireTimer, &onFireTimer);
  attachInterrupt(digitalPinToInterrupt(PIN_ZC), isrZeroCross, CHANGE);

  myPID.SetOutputLimits(U_MIN, U_MAX);
  myPID.SetSampleTime(PID_SAMPLE_MS);
  myPID.SetMode(AUTOMATIC);

  // Endstops
  pinMode(X_ENDSTOP_PIN, INPUT_PULLUP);
  pinMode(Y_ENDSTOP_PIN, INPUT_PULLUP);

  // Pines de habilitación de drivers
  pinMode(X_ENABLE_PIN, OUTPUT);
  pinMode(Y_ENABLE_PIN, OUTPUT);
  motorsEnable(false);

  // BOMBA
  pinMode(PUMP_PIN, OUTPUT);
  pumpOff();

  // LED análisis PWM
  pinMode(LED_ANALISIS_PIN, OUTPUT);
  GPIO.out_w1tc = (1UL << LED_ANALISIS_PIN);
  ledTimer = timerBegin(250000);   // 250 kHz
  timerAttachInterrupt(ledTimer, ledTimerISR);
  timerAlarm(ledTimer, 1, true, 0);
  timerStart(ledTimer);
  ledSetPower(0);

  // Steppers
  engine.init();

  stepperX = engine.stepperConnectToPin(X_STEP_PIN);
  if (!stepperX){ OUT_println("Error X"); while(1){} }
  stepperX->setDirectionPin(X_DIR_PIN, X_DIR_INVERTED);
  stepperX->setAutoEnable(false);
  stepperX->setSpeedInHz(X_SPEED_HZ);
  stepperX->setAcceleration(X_ACCEL);

  stepperY = engine.stepperConnectToPin(Y_STEP_PIN);
  if (!stepperY){ OUT_println("Error Y"); while(1){} }
  stepperY->setDirectionPin(Y_DIR_PIN, Y_DIR_INVERTED);
  stepperY->setAutoEnable(false);
  stepperY->setSpeedInHz(Y_SPEED_HZ);
  stepperY->setAcceleration(Y_ACCEL);

  // RTOS infra
  eg   = xEventGroupCreate();
  qCmd = xQueueCreate(16, sizeof(Command));

  // Auto-homing al arrancar
  OUT_println("\n=== Auto-homing al iniciar ===");
  homeX();
  homeY();
  moveToXYAbsSync(0.0f, 0.0f);
  OUT_println("Posicionado en HOME (0,0).");

  // ==== WIFI + MQTT ====
  setupWiFi();
  mqttClient.setServer(MQTT_SERVER, MQTT_PORT);
  mqttClient.setCallback(mqttCallback);

  // Tareas
  xTaskCreatePinnedToCore(taskSense,        "sense",    4096, NULL, 2, NULL, 1);
  xTaskCreatePinnedToCore(taskControl,      "control",  4096, NULL, 3, NULL, 1);
  xTaskCreatePinnedToCore(taskActuators,    "act",      4096, NULL, 1, NULL, 0);

  xTaskCreatePinnedToCore(vTaskUI,          "UI",       4096, nullptr, 2, &hUI,     0);
  xTaskCreatePinnedToCore(vTaskUtil,        "UTIL",     2048, nullptr, 1, &hUtil,   0);
  xTaskCreatePinnedToCore(vTaskMotion,      "MOTION",   4096, nullptr, 3, &hMotion, 1);

  xTaskCreatePinnedToCore(vTaskAutoAnalisis,"AUTO_ANAL",4096, nullptr, 1, &hAutoAnalisis, 0);
  xTaskCreatePinnedToCore(vTaskAutoFumigado,"AUTO_FUMI",4096, nullptr, 1, &hAutoFumigado, 0);
  xTaskCreatePinnedToCore(vTaskMqtt,        "MQTT",     4096, nullptr, 1, &hMqtt,         0);

  OUT_println("Sistema listo. Modo inicial: AUTO.");
  OUT_println("Puedes cambiar modo en 'hidrovida/cmd/mode' (auto/manual).");
  OUT_println("Puedes cambiar periodos en:");
  OUT_println("  hidrovida/cmd/analisis_period  (minutos)");
  OUT_println("  hidrovida/cmd/fumigado_period  (minutos)");
  OUT_println("Estado de sensor en:");
  OUT_println("  hidrovida/temp_sensor_state (ok, okoc, okidle, nan, out_of_range_low, out_of_range_high)");
}

/* ===================== LOOP ===================== */
void loop() {
  static uint32_t lastPrint = 0;
  if (millis() - lastPrint >= 5000) {
    lastPrint = millis();
    Serial.println(y_tempC, 2);  // solo la temperatura filtrada
  }
  vTaskDelay(pdMS_TO_TICKS(10));
}
