rod-0310/Senior_Engineering_Design_Project/(commit log)

2025-10-14 subir archivos
    [base_trupan.SLDPRT, botellon.SLDPRT, ensamblaje_v1.SLDASM, esquinero.SLDPRT, esquinero_varillas.SLDPRT, mueble.SLDPRT, perfil_x_y.SLDPRT, perfil_z.SLDPRT]
2025-10-14 archivos para el esnamblaje
    [Nima 17 40x42x5mm.SLDPRT, Nima 17 40x42x5mm.STEP, TB-6600.SLDPRT, TB-6600.STEP]
2025-10-14 adicion de bomba
2025-10-15 bomba y codos
    [BOMBA MARCH ENVASADO.SLDPRT, BOMBA MARCH ENVASADO.STEP, coude30.SLDPRT, coude50.SLDPRT, ensamblaje_v1.SLDASM, mueble.SLDPRT]
2025-10-16 anadiendo el mueble.step
    [mueble.STEP]
2025-10-17 adicion de archivos poleas y acrilicos
    [GT2 sin dientes.SLDPRT, LM00UU.iam, LM08UU.SLDPRT, LM08UU.STEP, LM08UU.ipt, LM12UU.STEP, LM12UU.ipt, LM16UU.STEP]
2025-10-19 adicion codigos arduino
    [PLC.SLDPRT, PLCFinal.SLDASM, PLCPieza2.SLDPRT, esp32_caja.SLDPRT, esp32_caja.STL, mesa_v2.SLDPRT, mesa_v2.STL]
2025-10-29 actualizacion de codigo de arduino
2025-11-08 adicionde de pid
    [acrilico_top.SLDPRT, aspersor.SLDPRT, aspersor.STL, aspersor2.STL, tapa_tubo.SLDPRT, tapa_tubo.STL]
2025-11-08 adicion de archivos
2025-11-13 adicion de archivos pid y movimientos de la planta
    [log_pid_realtime.csv]
2025-11-18 adicion de codigos preliminares el que esta mejor es el codigo preliminar final_v2
2025-11-19 adicion de codigo final arduino
2025-11-21 cambiio vision
    [results.csv]
